rcyaon/suspension-board/fab/rev-b/docs/drill-report.txt

Drill report for suspension-load-daq.kicad_pcb
Created on 2026-10-19T18:48:59

Copper Layer Stackup:
    =============================================================
    L1 :  F.Cu                      front
    L2 :  In1.Cu                    in1
    L3 :  In2.Cu                    in2
    L4 :  B.Cu                      back

Drill file 'suspension-load-daq-PTH.drl' contains
    plated through holes:
    =============================================================
    T1  0.300mm  0.0118"  (591 holes))
    T2  0.600mm  0.0236"  (4 holes)  (with 4 slots)
    T3  0.750mm  0.0295"  (64 holes))
    T4  1.000mm  0.0394"  (10 holes))
    T5  3.200mm  0.1260"  (4 holes))

    Total plated holes count 673

Drill file 'suspension-load-daq-NPTH.drl' contains
    unplated through holes:
    =============================================================
    T1  0.650mm  0.0256"  (2 holes))
    T2  0.991mm  0.0390"  (3 holes))

    Total unplated holes count 5
