rcyaon/suspension-board/fab/rev-b/renders/suspension-load-daq-top.png

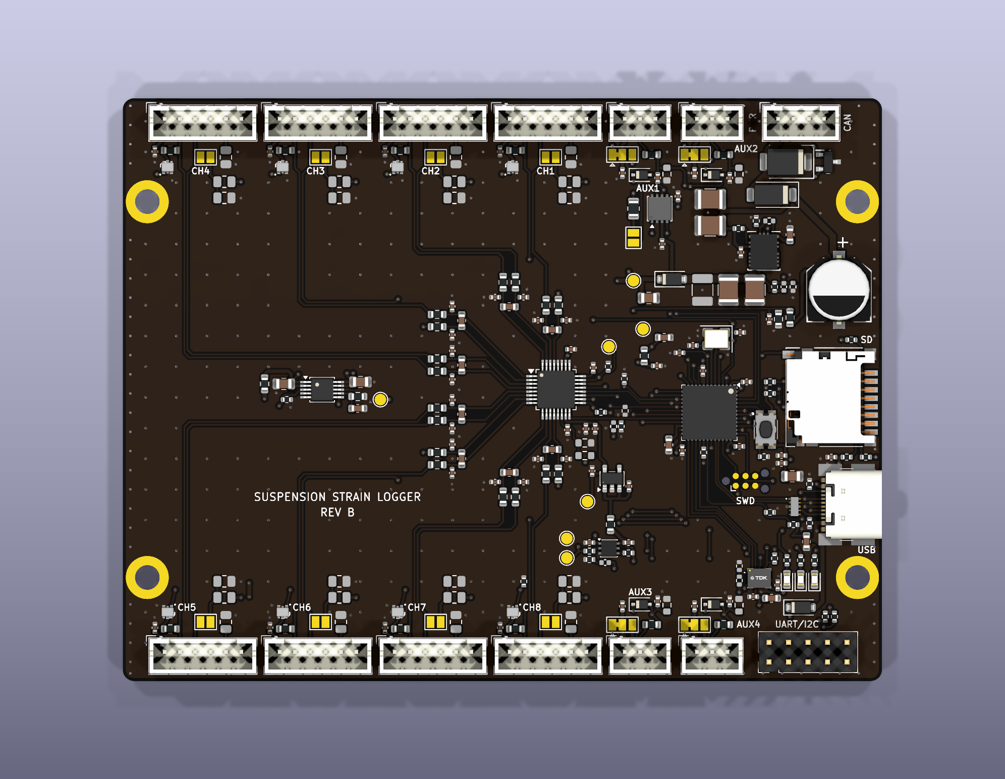
fab/rev-b/renders/suspension-load-daq-top.png
