rcyaon/suspension-board/fab/rev-b/assembly/suspension-load-daq-BOM-full.csv

Designator | Value | MPN | Manufacturer | Footprint | Population | LCSC | DigiKey | Mouser | Description
C1 | 47nF 16V | GRM155R71C473KA01J | Murata Electronics | C_0402_1005Metric | Fit | C2168391 | 490-11420-1-ND | 81-GRM155R71C473KA1J | 47 nF 10% 16 V X7R ceramic capacitor, 0402
C2 | 100nF 16V | GCM155R71H104KE02D | Murata Electronics | C_0402_1005Metric | Fit | C85858 | 490-10672-1-ND | 81-GCM155R71H104KE2D | 0.1 µF ±10% 50V Ceramic Capacitor X7R 0402 (1005 Metric)
C3 | 47nF 16V | GRM155R71C473KA01J | Murata Electronics | C_0402_1005Metric | Fit | C2168391 | 490-11420-1-ND | 81-GRM155R71C473KA1J | 47 nF 10% 16 V X7R ceramic capacitor, 0402
C4 | 100nF 16V | GCM155R71H104KE02D | Murata Electronics | C_0402_1005Metric | Fit | C85858 | 490-10672-1-ND | 81-GCM155R71H104KE2D | 0.1 µF ±10% 50V Ceramic Capacitor X7R 0402 (1005 Metric)
C5 | 47nF 16V | GRM155R71C473KA01J | Murata Electronics | C_0402_1005Metric | Fit | C2168391 | 490-11420-1-ND | 81-GRM155R71C473KA1J | 47 nF 10% 16 V X7R ceramic capacitor, 0402
C6 | 100nF 16V | GCM155R71H104KE02D | Murata Electronics | C_0402_1005Metric | Fit | C85858 | 490-10672-1-ND | 81-GCM155R71H104KE2D | 0.1 µF ±10% 50V Ceramic Capacitor X7R 0402 (1005 Metric)
C7 | 47nF 16V | GRM155R71C473KA01J | Murata Electronics | C_0402_1005Metric | Fit | C2168391 | 490-11420-1-ND | 81-GRM155R71C473KA1J | 47 nF 10% 16 V X7R ceramic capacitor, 0402
C8 | 100nF 16V | GCM155R71H104KE02D | Murata Electronics | C_0402_1005Metric | Fit | C85858 | 490-10672-1-ND | 81-GCM155R71H104KE2D | 0.1 µF ±10% 50V Ceramic Capacitor X7R 0402 (1005 Metric)
C9 | 1uF 10V | GRM155Z71A105KE01D | Murata Electronics | C_0402_1005Metric | Fit | C528974 | 490-GRM155Z71A105KE01DCT-ND | 81-GRM155Z71A105KE1D | 1 µF ±10% 10V Ceramic Capacitor X7R 0402 (1005 Metric)
C10 | 1uF 6.3V | GRM155Z71A105KE01D | Murata Electronics | C_0402_1005Metric | Fit | C528974 | 490-GRM155Z71A105KE01DCT-ND | 81-GRM155Z71A105KE1D | 1 µF ±10% 10V Ceramic Capacitor X7R 0402 (1005 Metric)
C11 | 1nF 5% 50V C0G | GCM1555C1H102FA16D | Murata Electronics | C_0402_1005Metric | Fit | C126493 | 490-16461-1-ND | 81-GCM1555C1H102FA6D | 1000 pF ±1% 50V Ceramic Capacitor C0G, NP0 0402 (1005 Metric)
C12 | 1nF 5% 50V C0G | GCM1555C1H102FA16D | Murata Electronics | C_0402_1005Metric | Fit | C126493 | 490-16461-1-ND | 81-GCM1555C1H102FA6D | 1000 pF ±1% 50V Ceramic Capacitor C0G, NP0 0402 (1005 Metric)
C13 | 10nF 5% 50V C0G | GCM1885C2A103JE02W | Murata Electronics | C_0603_1608Metric | Fit |  | 490-GCM1885C2A103JE02WCT-ND | 81-GCM1885C2A103JE2W | 10000 pF ±5% 100V Ceramic Capacitor C0G, NP0 0603 (1608 Metric)
C14 | 100nF 16V | GCM155R71H104KE02D | Murata Electronics | C_0402_1005Metric | Fit | C85858 | 490-10672-1-ND | 81-GCM155R71H104KE2D | 0.1 µF ±10% 50V Ceramic Capacitor X7R 0402 (1005 Metric)
C15 | 1nF 5% 50V C0G | GCM1555C1H102FA16D | Murata Electronics | C_0402_1005Metric | Fit | C126493 | 490-16461-1-ND | 81-GCM1555C1H102FA6D | 1000 pF ±1% 50V Ceramic Capacitor C0G, NP0 0402 (1005 Metric)
C16 | 1nF 5% 50V C0G | GCM1555C1H102FA16D | Murata Electronics | C_0402_1005Metric | Fit | C126493 | 490-16461-1-ND | 81-GCM1555C1H102FA6D | 1000 pF ±1% 50V Ceramic Capacitor C0G, NP0 0402 (1005 Metric)
C17 | 10nF 5% 50V C0G | GCM1885C2A103JE02W | Murata Electronics | C_0603_1608Metric | Fit |  | 490-GCM1885C2A103JE02WCT-ND | 81-GCM1885C2A103JE2W | 10000 pF ±5% 100V Ceramic Capacitor C0G, NP0 0603 (1608 Metric)
C18 | 100nF 16V | GCM155R71H104KE02D | Murata Electronics | C_0402_1005Metric | Fit | C85858 | 490-10672-1-ND | 81-GCM155R71H104KE2D | 0.1 µF ±10% 50V Ceramic Capacitor X7R 0402 (1005 Metric)
C19 | 1nF 5% 50V C0G | GCM1555C1H102FA16D | Murata Electronics | C_0402_1005Metric | Fit | C126493 | 490-16461-1-ND | 81-GCM1555C1H102FA6D | 1000 pF ±1% 50V Ceramic Capacitor C0G, NP0 0402 (1005 Metric)
C20 | 1nF 5% 50V C0G | GCM1555C1H102FA16D | Murata Electronics | C_0402_1005Metric | Fit | C126493 | 490-16461-1-ND | 81-GCM1555C1H102FA6D | 1000 pF ±1% 50V Ceramic Capacitor C0G, NP0 0402 (1005 Metric)
C21 | 10nF 5% 50V C0G | GCM1885C2A103JE02W | Murata Electronics | C_0603_1608Metric | Fit |  | 490-GCM1885C2A103JE02WCT-ND | 81-GCM1885C2A103JE2W | 10000 pF ±5% 100V Ceramic Capacitor C0G, NP0 0603 (1608 Metric)
C22 | 100nF 16V | GCM155R71H104KE02D | Murata Electronics | C_0402_1005Metric | Fit | C85858 | 490-10672-1-ND | 81-GCM155R71H104KE2D | 0.1 µF ±10% 50V Ceramic Capacitor X7R 0402 (1005 Metric)
C23 | 1nF 5% 50V C0G | GCM1555C1H102FA16D | Murata Electronics | C_0402_1005Metric | Fit | C126493 | 490-16461-1-ND | 81-GCM1555C1H102FA6D | 1000 pF ±1% 50V Ceramic Capacitor C0G, NP0 0402 (1005 Metric)
C24 | 1nF 5% 50V C0G | GCM1555C1H102FA16D | Murata Electronics | C_0402_1005Metric | Fit | C126493 | 490-16461-1-ND | 81-GCM1555C1H102FA6D | 1000 pF ±1% 50V Ceramic Capacitor C0G, NP0 0402 (1005 Metric)
C25 | 10nF 5% 50V C0G | GCM1885C2A103JE02W | Murata Electronics | C_0603_1608Metric | Fit |  | 490-GCM1885C2A103JE02WCT-ND | 81-GCM1885C2A103JE2W | 10000 pF ±5% 100V Ceramic Capacitor C0G, NP0 0603 (1608 Metric)
C26 | 100nF 16V | GCM155R71H104KE02D | Murata Electronics | C_0402_1005Metric | Fit | C85858 | 490-10672-1-ND | 81-GCM155R71H104KE2D | 0.1 µF ±10% 50V Ceramic Capacitor X7R 0402 (1005 Metric)
C27 | 1nF 5% 50V C0G | GCM1555C1H102FA16D | Murata Electronics | C_0402_1005Metric | Fit | C126493 | 490-16461-1-ND | 81-GCM1555C1H102FA6D | 1000 pF ±1% 50V Ceramic Capacitor C0G, NP0 0402 (1005 Metric)
C28 | 1nF 5% 50V C0G | GCM1555C1H102FA16D | Murata Electronics | C_0402_1005Metric | Fit | C126493 | 490-16461-1-ND | 81-GCM1555C1H102FA6D | 1000 pF ±1% 50V Ceramic Capacitor C0G, NP0 0402 (1005 Metric)
C29 | 10nF 5% 50V C0G | GCM1885C2A103JE02W | Murata Electronics | C_0603_1608Metric | Fit |  | 490-GCM1885C2A103JE02WCT-ND | 81-GCM1885C2A103JE2W | 10000 pF ±5% 100V Ceramic Capacitor C0G, NP0 0603 (1608 Metric)
C30 | 100nF 16V | GCM155R71H104KE02D | Murata Electronics | C_0402_1005Metric | Fit | C85858 | 490-10672-1-ND | 81-GCM155R71H104KE2D | 0.1 µF ±10% 50V Ceramic Capacitor X7R 0402 (1005 Metric)
C31 | 1nF 5% 50V C0G | GCM1555C1H102FA16D | Murata Electronics | C_0402_1005Metric | Fit | C126493 | 490-16461-1-ND | 81-GCM1555C1H102FA6D | 1000 pF ±1% 50V Ceramic Capacitor C0G, NP0 0402 (1005 Metric)
C32 | 1nF 5% 50V C0G | GCM1555C1H102FA16D | Murata Electronics | C_0402_1005Metric | Fit | C126493 | 490-16461-1-ND | 81-GCM1555C1H102FA6D | 1000 pF ±1% 50V Ceramic Capacitor C0G, NP0 0402 (1005 Metric)
C33 | 10nF 5% 50V C0G | GCM1885C2A103JE02W | Murata Electronics | C_0603_1608Metric | Fit |  | 490-GCM1885C2A103JE02WCT-ND | 81-GCM1885C2A103JE2W | 10000 pF ±5% 100V Ceramic Capacitor C0G, NP0 0603 (1608 Metric)
C34 | 100nF 16V | GCM155R71H104KE02D | Murata Electronics | C_0402_1005Metric | Fit | C85858 | 490-10672-1-ND | 81-GCM155R71H104KE2D | 0.1 µF ±10% 50V Ceramic Capacitor X7R 0402 (1005 Metric)
C35 | 1nF 5% 50V C0G | GCM1555C1H102FA16D | Murata Electronics | C_0402_1005Metric | Fit | C126493 | 490-16461-1-ND | 81-GCM1555C1H102FA6D | 1000 pF ±1% 50V Ceramic Capacitor C0G, NP0 0402 (1005 Metric)
C36 | 1nF 5% 50V C0G | GCM1555C1H102FA16D | Murata Electronics | C_0402_1005Metric | Fit | C126493 | 490-16461-1-ND | 81-GCM1555C1H102FA6D | 1000 pF ±1% 50V Ceramic Capacitor C0G, NP0 0402 (1005 Metric)
C37 | 10nF 5% 50V C0G | GCM1885C2A103JE02W | Murata Electronics | C_0603_1608Metric | Fit |  | 490-GCM1885C2A103JE02WCT-ND | 81-GCM1885C2A103JE2W | 10000 pF ±5% 100V Ceramic Capacitor C0G, NP0 0603 (1608 Metric)
C38 | 100nF 16V | GCM155R71H104KE02D | Murata Electronics | C_0402_1005Metric | Fit | C85858 | 490-10672-1-ND | 81-GCM155R71H104KE2D | 0.1 µF ±10% 50V Ceramic Capacitor X7R 0402 (1005 Metric)
C39 | 1nF 5% 50V C0G | GCM1555C1H102FA16D | Murata Electronics | C_0402_1005Metric | Fit | C126493 | 490-16461-1-ND | 81-GCM1555C1H102FA6D | 1000 pF ±1% 50V Ceramic Capacitor C0G, NP0 0402 (1005 Metric)
C40 | 1nF 5% 50V C0G | GCM1555C1H102FA16D | Murata Electronics | C_0402_1005Metric | Fit | C126493 | 490-16461-1-ND | 81-GCM1555C1H102FA6D | 1000 pF ±1% 50V Ceramic Capacitor C0G, NP0 0402 (1005 Metric)
C41 | 10nF 5% 50V C0G | GCM1885C2A103JE02W | Murata Electronics | C_0603_1608Metric | Fit |  | 490-GCM1885C2A103JE02WCT-ND | 81-GCM1885C2A103JE2W | 10000 pF ±5% 100V Ceramic Capacitor C0G, NP0 0603 (1608 Metric)
C42 | 100nF 16V | GCM155R71H104KE02D | Murata Electronics | C_0402_1005Metric | Fit | C85858 | 490-10672-1-ND | 81-GCM155R71H104KE2D | 0.1 µF ±10% 50V Ceramic Capacitor X7R 0402 (1005 Metric)
C43 | 1uF 16V | GRM155R61C105KA12J | Murata Electronics | C_0402_1005Metric | Fit | C20549880 | 490-14598-1-ND | 81-GRM155R61C105KA2J | 1 uF 10% 16 V X5R ceramic capacitor, 0402
C44 | 100nF 16V | GCM155R71H104KE02D | Murata Electronics | C_0402_1005Metric | Fit | C85858 | 490-10672-1-ND | 81-GCM155R71H104KE2D | 0.1 µF ±10% 50V Ceramic Capacitor X7R 0402 (1005 Metric)
C45 | 220nF 16V | GRM155R71C224KA12J | Murata Electronics | C_0402_1005Metric | Fit | C2190027 | 490-GRM155R71C224KA12JCT-ND | 81-GRM155R71C224KA2J | 220 nF 10% 16 V X7R ceramic capacitor, 0402
C46 | 1uF 16V | GRM155R61C105KA12J | Murata Electronics | C_0402_1005Metric | Fit | C20549880 | 490-14598-1-ND | 81-GRM155R61C105KA2J | 1 uF 10% 16 V X5R ceramic capacitor, 0402
C47 | 100nF 16V | GCM155R71H104KE02D | Murata Electronics | C_0402_1005Metric | Fit | C85858 | 490-10672-1-ND | 81-GCM155R71H104KE2D | 0.1 µF ±10% 50V Ceramic Capacitor X7R 0402 (1005 Metric)
C48 | 10uF 16V | GRM21BZ71E106KE15L | Murata Electronics | C_0805_2012Metric | Fit | C237493 | 490-GRM21BZ71E106KE15LCT-ND | 81-GRM21BZ71E106KE5L | 10 µF ±10% 25V Ceramic Capacitor X7R 0805 (2012 Metric)
C49 | 100nF 16V | GCM155R71H104KE02D | Murata Electronics | C_0402_1005Metric | Fit | C85858 | 490-10672-1-ND | 81-GCM155R71H104KE2D | 0.1 µF ±10% 50V Ceramic Capacitor X7R 0402 (1005 Metric)
C50 | 1uF 25V | GCM188R71E105KA64D | Murata Electronics | C_0603_1608Metric | Fit | C85862 | 490-10673-1-ND | 81-GCM188R71E105KA4D | 1 µF ±10% 25V Ceramic Capacitor X7R 0603 (1608 Metric)
C51 | 10uF 16V | GRM21BZ71E106KE15L | Murata Electronics | C_0805_2012Metric | Fit | C237493 | 490-GRM21BZ71E106KE15LCT-ND | 81-GRM21BZ71E106KE5L | 10 µF ±10% 25V Ceramic Capacitor X7R 0805 (2012 Metric)
C52 | 10uF 16V | GRM21BZ71E106KE15L | Murata Electronics | C_0805_2012Metric | Fit | C237493 | 490-GRM21BZ71E106KE15LCT-ND | 81-GRM21BZ71E106KE5L | 10 µF ±10% 25V Ceramic Capacitor X7R 0805 (2012 Metric)
C53 | 4.7uF 16V | GRM188Z71C475KE21D | Murata Electronics | C_0603_1608Metric | Fit | C389010 | 490-GRM188Z71C475KE21DCT-ND | 81-GRM188Z71C475KE1D | 4.7 µF ±10% 16V Ceramic Capacitor X7R 0603 (1608 Metric)
C54 | 10nF 10% 6.3V | GCM155R71H103KA55D | Murata Electronics | C_0402_1005Metric | Fit | C91601 | 490-4762-1-ND | 81-GCM155R71H103KA5D | 10000 pF ±10% 50V Ceramic Capacitor X7R 0402 (1005 Metric)
C55 | 100nF 10% 6.3V | GCM155R71H104KE02D | Murata Electronics | C_0402_1005Metric | Fit | C85858 | 490-10672-1-ND | 81-GCM155R71H104KE2D | 0.1 µF ±10% 50V Ceramic Capacitor X7R 0402 (1005 Metric)
C56 | 2.2uF 10V | GRM188Z71E225ME43D | Murata Electronics | C_0603_1608Metric | Fit | C3856236 | 490-GRM188Z71E225ME43DCT-ND | 81-GRM188Z71E225ME3D | 2.2 µF ±20% 25V Ceramic Capacitor X7R 0603 (1608 Metric)
C58 | 12pF 5% 50V C0G | GCM1555C1H120FA16D | Murata Electronics | C_0402_1005Metric | Fit | C393682 | 490-16460-1-ND | 81-GCM1555C1H120FA6D | 12 pF ±1% 50V Ceramic Capacitor C0G, NP0 0402 (1005 Metric)
C59 | 12pF 5% 50V C0G | GCM1555C1H120FA16D | Murata Electronics | C_0402_1005Metric | Fit | C393682 | 490-16460-1-ND | 81-GCM1555C1H120FA6D | 12 pF ±1% 50V Ceramic Capacitor C0G, NP0 0402 (1005 Metric)
C62 | 100nF 16V | GCM155R71H104KE02D | Murata Electronics | C_0402_1005Metric | Fit | C85858 | 490-10672-1-ND | 81-GCM155R71H104KE2D | 0.1 µF ±10% 50V Ceramic Capacitor X7R 0402 (1005 Metric)
C63 | 4.7uF 16V | GRM188Z71C475KE21D | Murata Electronics | C_0603_1608Metric | Fit | C389010 | 490-GRM188Z71C475KE21DCT-ND | 81-GRM188Z71C475KE1D | 4.7 µF ±10% 16V Ceramic Capacitor X7R 0603 (1608 Metric)
C64 | 100nF 16V | GCM155R71H104KE02D | Murata Electronics | C_0402_1005Metric | Fit | C85858 | 490-10672-1-ND | 81-GCM155R71H104KE2D | 0.1 µF ±10% 50V Ceramic Capacitor X7R 0402 (1005 Metric)
C65 | 100nF 16V | GCM155R71H104KE02D | Murata Electronics | C_0402_1005Metric | Fit | C85858 | 490-10672-1-ND | 81-GCM155R71H104KE2D | 0.1 µF ±10% 50V Ceramic Capacitor X7R 0402 (1005 Metric)
C66 | 100nF 16V | GCM155R71H104KE02D | Murata Electronics | C_0402_1005Metric | Fit | C85858 | 490-10672-1-ND | 81-GCM155R71H104KE2D | 0.1 µF ±10% 50V Ceramic Capacitor X7R 0402 (1005 Metric)
C67 | 100nF 16V | GCM155R71H104KE02D | Murata Electronics | C_0402_1005Metric | Fit | C85858 | 490-10672-1-ND | 81-GCM155R71H104KE2D | 0.1 µF ±10% 50V Ceramic Capacitor X7R 0402 (1005 Metric)
C68 | 100nF 16V | GCM155R71H104KE02D | Murata Electronics | C_0402_1005Metric | Fit | C85858 | 490-10672-1-ND | 81-GCM155R71H104KE2D | 0.1 µF ±10% 50V Ceramic Capacitor X7R 0402 (1005 Metric)
C69 | 1uF 16V | GRM155R61C105KA12J | Murata Electronics | C_0402_1005Metric | Fit | C20549880 | 490-14598-1-ND | 81-GRM155R61C105KA2J | 1 uF 10% 16 V X5R ceramic capacitor, 0402
C70 | 100nF 16V | GCM155R71H104KE02D | Murata Electronics | C_0402_1005Metric | Fit | C85858 | 490-10672-1-ND | 81-GCM155R71H104KE2D | 0.1 µF ±10% 50V Ceramic Capacitor X7R 0402 (1005 Metric)
C71 | 4.7uF 16V | GRM188Z71C475KE21D | Murata Electronics | C_0603_1608Metric | Fit | C389010 | 490-GRM188Z71C475KE21DCT-ND | 81-GRM188Z71C475KE1D | 4.7 µF ±10% 16V Ceramic Capacitor X7R 0603 (1608 Metric)
C72 | 10pF 50V C0G | GCM1555C1H100FA16D | Murata Electronics |  | DNP | C161145 | 490-14348-1-ND | 81-GCM1555C1H100FA6D | 10 pF ±1% 50V Ceramic Capacitor C0G, NP0 0402 (1005 Metric)
C73 | 4.7uF 50V X7R | C3225X7R1H475K250AB | TDK | C_1210_3225Metric | Fit | C2183952 | 445-7726-1-ND | 810-C3225X7R1H475K | 4.7uF 50V X7R
C74 | 100nF 50V X7R | GCM155R71H104KE02D | Murata Electronics | C_0402_1005Metric | Fit | C85858 | 490-10672-1-ND | 81-GCM155R71H104KE2D | 0.1 µF ±10% 50V Ceramic Capacitor X7R 0402 (1005 Metric)
C75 | 4.7uF 50V X7R | C3225X7R1H475K250AB | TDK | C_1210_3225Metric | Fit | C2183952 | 445-7726-1-ND | 810-C3225X7R1H475K | 4.7uF 50V X7R
C76 | 22uF 16V X7R | GRM32ER71E226KE15L | Murata Electronics | C_1210_3225Metric | Fit | C21397 | 490-5313-1-ND | 81-GRM32ER71E226KE5L | 22 µF ±10% 25V Ceramic Capacitor X7R 1210 (3225 Metric)
C77 | 22uF 16V X7R | GRM32ER71E226KE15L | Murata Electronics | C_1210_3225Metric | Fit | C21397 | 490-5313-1-ND | 81-GRM32ER71E226KE5L | 22 µF ±10% 25V Ceramic Capacitor X7R 1210 (3225 Metric)
C78 | 22uF 16V X7R | GRM32ER71E226KE15L | Murata Electronics |  | DNP | C21397 | 490-5313-1-ND | 81-GRM32ER71E226KE5L | 22 µF ±10% 25V Ceramic Capacitor X7R 1210 (3225 Metric)
C79 | 2.2uF 16V X7R | CC0603KRX7R7BB225 | YAGEO | C_0603_1608Metric | Fit | C914769 | 311-3490-1-ND | 603-CC0603KRX77BB225 | 2.2uF 16V X7R
C80 | 1uF 16V | GRM155R61C105KA12J | Murata Electronics | C_0402_1005Metric | Fit | C20549880 | 490-14598-1-ND | 81-GRM155R61C105KA2J | 1 uF 10% 16 V X5R ceramic capacitor, 0402
C81 | 1uF 16V | GRM155R61C105KA12J | Murata Electronics | C_0402_1005Metric | Fit | C20549880 | 490-14598-1-ND | 81-GRM155R61C105KA2J | 1 uF 10% 16 V X5R ceramic capacitor, 0402
C82 | EEE-FK1H470P | EEE-FK1H470P | Panasonic | EEE-FK1H470P | Fit | C278400 | PCE3815CT-ND | 667-EEE-FK1H470P | Aluminum electrolytic capacitor, 47uF 20% 50V, FK series low-impedance, SMD size E (8x6.2mm), 20 ...
C83 | 100nF 16V | GCM155R71H104KE02D | Murata Electronics | C_0402_1005Metric | Fit | C85858 | 490-10672-1-ND | 81-GCM155R71H104KE2D | 0.1 µF ±10% 50V Ceramic Capacitor X7R 0402 (1005 Metric)
C84 | 10uF 16V | GRM21BZ71E106KE15L | Murata Electronics | C_0805_2012Metric | Fit | C237493 | 490-GRM21BZ71E106KE15LCT-ND | 81-GRM21BZ71E106KE5L | 10 µF ±10% 25V Ceramic Capacitor X7R 0805 (2012 Metric)
C85 | 10nF | GCM155R71H103KA55D | Murata Electronics |  | DNP | C91601 | 490-4762-1-ND | 81-GCM155R71H103KA5D | 10000 pF ±10% 50V Ceramic Capacitor X7R 0402 (1005 Metric)
C86 | 1uF 10V | GRM155Z71A105KE01D | Murata Electronics | C_0402_1005Metric | Fit | C528974 | 490-GRM155Z71A105KE01DCT-ND | 81-GRM155Z71A105KE1D | 1 µF ±10% 10V Ceramic Capacitor X7R 0402 (1005 Metric)
C87 | 1uF 10V | GRM155Z71A105KE01D | Murata Electronics | C_0402_1005Metric | Fit | C528974 | 490-GRM155Z71A105KE01DCT-ND | 81-GRM155Z71A105KE1D | 1 µF ±10% 10V Ceramic Capacitor X7R 0402 (1005 Metric)
D1 | PESD2CANFD24V | PESD2CANFD24V-TR | Nexperia | PESD2CANFD24V | Fit | C552486 | 1727-PESD2CANFD24V-CT-ND | 771-PESD2CANFD24V-TR | Dual bidirectional TVS array for automotive CAN/CAN-FD ESD protection, 24 V working, AEC-Q101, S ...
D2 | LED RED | LTST-C190KRKT | Lite-On Inc. | LED_0603_1608Metric | Fit | C94869 | 160-1436-1-ND | 859-LTST-C190KRKT | Red 631 nm LED, 0603, typical VF 2.0 V
D3 | LED GREEN | LTST-C190KGKT | Lite-On Inc. | LED_0603_1608Metric | Fit | C125094 | 160-1435-1-ND | 859-LTST-C190KGKT | Green 572 nm LED, 0603, typical VF 2.15 V
D4 | LED BLUE | LTST-C190TBKT | Lite-On Inc. | LED_0603_1608Metric | Fit | C125096 | 160-1646-1-ND | 859-LTST-C190TBKT | Blue 470 nm LED, 0603, typical VF 3.3 V
D5 | TPD4E02B04DQAR | TPD4E02B04DQAR | Texas Instruments | TPD4E02B04DQAR | Fit | C106794 | 296-43875-1-ND | 595-TPD4E02B04DQAR | 4-channel bidirectional ESD/TVS protection array for USB Type-C and high-speed data lines, 0.25p ...
D6 | 1A 40V Low-IR Schottky | RB168MM-40TFTR | Rohm Semiconductor | D_SOD-123F | Fit | C3758797 | RB168MM-40TFCT-ND | 755-RB168MM-40TFTR | 1 A 40 V super-low-IR Schottky rectifier, AEC-Q101, VF <= 0.65 V at 1 A, IR <= 0.55 uA at 40 V/2 ...
D7 | 1A 40V Low-IR Schottky | RB168MM-40TFTR | Rohm Semiconductor | D_SOD-123F | Fit | C3758797 | RB168MM-40TFCT-ND | 755-RB168MM-40TFTR | 1 A 40 V super-low-IR Schottky rectifier, AEC-Q101, VF <= 0.65 V at 1 A, IR <= 0.55 uA at 40 V/2 ...
D8 | 2A 40V Schottky Rectifier | B240A-13-F | Diodes Incorporated | D_SMA | Fit | C92506 | B240A-FDICT-ND | 621-B240A-F | 2 A 40 V Schottky rectifier, DO-214AC (SMA)
D9 | 18V TVS Diode | SMBJ18CA | Littelfuse | D_SMB | Fit | C83327 | SMBJ18CALFCT-ND | 576-SMBJ18CA | 18V TVS Diode
D10 | 200mA 30V Schottky Rectifier | BAT54WS-HE3_A-08 | Vishay | D_SOD-323 | Fit | C146335 | 112-BAT54WS-HE3_A-08CT-ND | 78-BAT54WS-HE3_A-08 | 200mA 30V Schottky Rectifier
D11 | 200mA 30V Schottky Rectifier | BAT54WS-HE3_A-08 | Vishay | D_SOD-323 | Fit | C146335 | 112-BAT54WS-HE3_A-08CT-ND | 78-BAT54WS-HE3_A-08 | 200mA 30V Schottky Rectifier
D12 | 200mA 30V Schottky Rectifier | BAT54WS-HE3_A-08 | Vishay | D_SOD-323 | Fit | C146335 | 112-BAT54WS-HE3_A-08CT-ND | 78-BAT54WS-HE3_A-08 | 200mA 30V Schottky Rectifier
D13 | 200mA 30V Schottky Rectifier | BAT54WS-HE3_A-08 | Vishay | D_SOD-323 | Fit | C146335 | 112-BAT54WS-HE3_A-08CT-ND | 78-BAT54WS-HE3_A-08 | 200mA 30V Schottky Rectifier
FB1 | 220 100MHz | BLM18EG221SZ1D | Murata Electronics | R_0603_1608Metric | Fit | C710364 | 490-16657-1-ND | 81-BLM18EG221SZ1D | 220 Ohms @ 100 MHz 1 Signal Line Ferrite Bead 0603 (1608 Metric) 2A 50mOhm
FB2 | 220 100MHz | BLM18EG221SZ1D | Murata Electronics | R_0603_1608Metric | Fit | C710364 | 490-16657-1-ND | 81-BLM18EG221SZ1D | 220 Ohms @ 100 MHz 1 Signal Line Ferrite Bead 0603 (1608 Metric) 2A 50mOhm
IC1 | ICM-42688-P | ICM-42688-P | TDK | IIM42352 | Fit | C20619370 |  |  | IMU (Inertial Measurement Unit), 6-Axis, Accelerometer, Gyroscope
J1 | B3B-PH-K-S | B3B-PH-K-S | JST | JST_PH_B3B-PH-K_1x03_P2.00mm_Vertical | Fit | C131339 | 455-1705-ND | 306-B3BPHKSLFSNP | JST PH series 2.00mm 3-position vertical through-hole wire-to-board header
J2 | B3B-PH-K-S | B3B-PH-K-S | JST | JST_PH_B3B-PH-K_1x03_P2.00mm_Vertical | Fit | C131339 | 455-1705-ND | 306-B3BPHKSLFSNP | JST PH series 2.00mm 3-position vertical through-hole wire-to-board header
J3 | B3B-PH-K-S | B3B-PH-K-S | JST | JST_PH_B3B-PH-K_1x03_P2.00mm_Vertical | Fit | C131339 | 455-1705-ND | 306-B3BPHKSLFSNP | JST PH series 2.00mm 3-position vertical through-hole wire-to-board header
J4 | B3B-PH-K-S | B3B-PH-K-S | JST | JST_PH_B3B-PH-K_1x03_P2.00mm_Vertical | Fit | C131339 | 455-1705-ND | 306-B3BPHKSLFSNP | JST PH series 2.00mm 3-position vertical through-hole wire-to-board header
J5 | B6B-PH-K-S | B6B-PH-K-S | JST | JST_PH_B6B-PH-K_1x06_P2.00mm_Vertical | Fit | C131342 | 455-1708-ND | 306-B6B-PH-K-SLFSN | JST PH series 2.00mm 6-position vertical through-hole wire-to-board header
J6 | B6B-PH-K-S | B6B-PH-K-S | JST | JST_PH_B6B-PH-K_1x06_P2.00mm_Vertical | Fit | C131342 | 455-1708-ND | 306-B6B-PH-K-SLFSN | JST PH series 2.00mm 6-position vertical through-hole wire-to-board header
J7 | B6B-PH-K-S | B6B-PH-K-S | JST | JST_PH_B6B-PH-K_1x06_P2.00mm_Vertical | Fit | C131342 | 455-1708-ND | 306-B6B-PH-K-SLFSN | JST PH series 2.00mm 6-position vertical through-hole wire-to-board header
J8 | B6B-PH-K-S | B6B-PH-K-S | JST | JST_PH_B6B-PH-K_1x06_P2.00mm_Vertical | Fit | C131342 | 455-1708-ND | 306-B6B-PH-K-SLFSN | JST PH series 2.00mm 6-position vertical through-hole wire-to-board header
J9 | B6B-PH-K-S | B6B-PH-K-S | JST | JST_PH_B6B-PH-K_1x06_P2.00mm_Vertical | Fit | C131342 | 455-1708-ND | 306-B6B-PH-K-SLFSN | JST PH series 2.00mm 6-position vertical through-hole wire-to-board header
J10 | B6B-PH-K-S | B6B-PH-K-S | JST | JST_PH_B6B-PH-K_1x06_P2.00mm_Vertical | Fit | C131342 | 455-1708-ND | 306-B6B-PH-K-SLFSN | JST PH series 2.00mm 6-position vertical through-hole wire-to-board header
J11 | B6B-PH-K-S | B6B-PH-K-S | JST | JST_PH_B6B-PH-K_1x06_P2.00mm_Vertical | Fit | C131342 | 455-1708-ND | 306-B6B-PH-K-SLFSN | JST PH series 2.00mm 6-position vertical through-hole wire-to-board header
J12 | B6B-PH-K-S | B6B-PH-K-S | JST | JST_PH_B6B-PH-K_1x06_P2.00mm_Vertical | Fit | C131342 | 455-1708-ND | 306-B6B-PH-K-SLFSN | JST PH series 2.00mm 6-position vertical through-hole wire-to-board header
J13 | 2.54mm 5 x 2 THT Vertical Male | TSW-105-07-G-D | Samtec Inc. | PinHeader_2x05_P2.54mm_Vertical | Fit | C7074471 | 612-TSW-105-07-G-D-ND | 200-TSW10507GD | 2x5 male straight through-hole header, 2.54 mm pitch, 0.64 mm square posts
J15 | USB4105 | USB4105-GF-A | GCT | USB4105 | Fit | C3020560 | 2073-USB4105-GF-ACT-ND | 640-USB4105-GF-A | USB Type-C USB 2.0 receptacle, 16P, top-mount right-angle, GCT USB4105
J16 | B4B-PH-K-S | B4B-PH-K-S | JST | JST_PH_B4B-PH-K_1x04_P2.00mm_Vertical | Fit | C131334 | 455-1706-ND | 306-B4BPHKSLFSNPP | JST PH series 2.00mm 4-position vertical through-hole wire-to-board header
J17 | DM3D-SF | DM3D-SF | Hirose Electric Co Ltd | microSD_HC_Hirose_DM3D-SF | Fit | C719027 | HR1941CT-ND | 798-DM3D-SF | Hirose DM3D-SF push-pull microSD card socket, right-angle SMT, with card-detect switch
Q1 | PJE138K_R1_00001 | PJE138K_R1_00001 | PANJIT | SOT-523 | Fit | C391643 | 3757-PJE138K_R1_00001CT-ND | 241-PJE138K_R1_00001 | FET/MOSFET transistor
Q2 | PJE138K_R1_00001 | PJE138K_R1_00001 | PANJIT | SOT-523 | Fit | C391643 | 3757-PJE138K_R1_00001CT-ND | 241-PJE138K_R1_00001 | FET/MOSFET transistor
Q3 | PJE138K_R1_00001 | PJE138K_R1_00001 | PANJIT | SOT-523 | Fit | C391643 | 3757-PJE138K_R1_00001CT-ND | 241-PJE138K_R1_00001 | FET/MOSFET transistor
Q4 | PJE138K_R1_00001 | PJE138K_R1_00001 | PANJIT | SOT-523 | Fit | C391643 | 3757-PJE138K_R1_00001CT-ND | 241-PJE138K_R1_00001 | FET/MOSFET transistor
Q5 | PJE138K_R1_00001 | PJE138K_R1_00001 | PANJIT | SOT-523 | Fit | C391643 | 3757-PJE138K_R1_00001CT-ND | 241-PJE138K_R1_00001 | FET/MOSFET transistor
Q6 | PJE138K_R1_00001 | PJE138K_R1_00001 | PANJIT | SOT-523 | Fit | C391643 | 3757-PJE138K_R1_00001CT-ND | 241-PJE138K_R1_00001 | FET/MOSFET transistor
Q7 | PJE138K_R1_00001 | PJE138K_R1_00001 | PANJIT | SOT-523 | Fit | C391643 | 3757-PJE138K_R1_00001CT-ND | 241-PJE138K_R1_00001 | FET/MOSFET transistor
Q8 | PJE138K_R1_00001 | PJE138K_R1_00001 | PANJIT | SOT-523 | Fit | C391643 | 3757-PJE138K_R1_00001CT-ND | 241-PJE138K_R1_00001 | FET/MOSFET transistor
R1 | 18k 1% | ERJ-3EKF1802V | Panasonic Industry |  | DNP | C403034 | P18.0KHCT-ND | 667-ERJ-3EKF1802V | 18 kOhms ±1% 0.1W, 1/10W Chip Resistor 0603 (1608 Metric) Automotive AEC-Q200 Thick Film
R2 | 10k 1% | ERJ-3EKF1002V | Panasonic Industry | R_0603_1608Metric | Fit | C191124 | P10.0KHCT-ND | 667-ERJ-3EKF1002V | 10 kOhms ±1% 0.1W, 1/10W Chip Resistor 0603 (1608 Metric) Automotive AEC-Q200 Thick Film
R3 | 18k 1% | ERJ-3EKF1802V | Panasonic Industry |  | DNP | C403034 | P18.0KHCT-ND | 667-ERJ-3EKF1802V | 18 kOhms ±1% 0.1W, 1/10W Chip Resistor 0603 (1608 Metric) Automotive AEC-Q200 Thick Film
R4 | 10k 1% | ERJ-3EKF1002V | Panasonic Industry | R_0603_1608Metric | Fit | C191124 | P10.0KHCT-ND | 667-ERJ-3EKF1002V | 10 kOhms ±1% 0.1W, 1/10W Chip Resistor 0603 (1608 Metric) Automotive AEC-Q200 Thick Film
R5 | 18k 1% | ERJ-3EKF1802V | Panasonic Industry |  | DNP | C403034 | P18.0KHCT-ND | 667-ERJ-3EKF1802V | 18 kOhms ±1% 0.1W, 1/10W Chip Resistor 0603 (1608 Metric) Automotive AEC-Q200 Thick Film
R6 | 10k 1% | ERJ-3EKF1002V | Panasonic Industry | R_0603_1608Metric | Fit | C191124 | P10.0KHCT-ND | 667-ERJ-3EKF1002V | 10 kOhms ±1% 0.1W, 1/10W Chip Resistor 0603 (1608 Metric) Automotive AEC-Q200 Thick Film
R7 | 18k 1% | ERJ-3EKF1802V | Panasonic Industry |  | DNP | C403034 | P18.0KHCT-ND | 667-ERJ-3EKF1802V | 18 kOhms ±1% 0.1W, 1/10W Chip Resistor 0603 (1608 Metric) Automotive AEC-Q200 Thick Film
R8 | 10k 1% | ERJ-3EKF1002V | Panasonic Industry | R_0603_1608Metric | Fit | C191124 | P10.0KHCT-ND | 667-ERJ-3EKF1002V | 10 kOhms ±1% 0.1W, 1/10W Chip Resistor 0603 (1608 Metric) Automotive AEC-Q200 Thick Film
R9 | 100k 0.1% | TNPW0603100KBEEA | Vishay Dale | R_0603_1608Metric | Fit | C844888 | TNP100KAACT-ND | 71-TNPW0603100KBEEA | 100 kOhm 0.1%, 0603, 0.21 W thin-film resistor
R10 | 1k 0.1% | TNPW06031K00BEEA | Vishay Dale | R_0603_1608Metric | Fit | C844891 | TNP1.00KAACT-ND | 71-TNPW06031K00BEEA | 1 kOhm 0.1%, 0603, 0.21 W thin-film resistor
R11 | 1k 0.1% | TNPW06031K00BEEA | Vishay Dale | R_0603_1608Metric | Fit | C844891 | TNP1.00KAACT-ND | 71-TNPW06031K00BEEA | 1 kOhm 0.1%, 0603, 0.21 W thin-film resistor
R12 | 350 0.1% | RWB350R0BL | VPG Foil Resistors |  | DNP |  | 804-RWB350R0BL-ND |  | 350 Ohm 0.1%, 0805, 0.2 W bulk metal-foil resistor
R13 | 350 0.1% | RWB350R0BL | VPG Foil Resistors |  | DNP |  | 804-RWB350R0BL-ND |  | 350 Ohm 0.1%, 0805, 0.2 W bulk metal-foil resistor
R14 | 350 0.1% | RWB350R0BL | VPG Foil Resistors |  | DNP |  | 804-RWB350R0BL-ND |  | 350 Ohm 0.1%, 0805, 0.2 W bulk metal-foil resistor
R15 | 100k 0.1% | TNPW0603100KBEEA | Vishay Dale | R_0603_1608Metric | Fit | C844888 | TNP100KAACT-ND | 71-TNPW0603100KBEEA | 100 kOhm 0.1%, 0603, 0.21 W thin-film resistor
R16 | 1k 0.1% | TNPW06031K00BEEA | Vishay Dale | R_0603_1608Metric | Fit | C844891 | TNP1.00KAACT-ND | 71-TNPW06031K00BEEA | 1 kOhm 0.1%, 0603, 0.21 W thin-film resistor
R17 | 1k 0.1% | TNPW06031K00BEEA | Vishay Dale | R_0603_1608Metric | Fit | C844891 | TNP1.00KAACT-ND | 71-TNPW06031K00BEEA | 1 kOhm 0.1%, 0603, 0.21 W thin-film resistor
R18 | 350 0.1% | RWB350R0BL | VPG Foil Resistors |  | DNP |  | 804-RWB350R0BL-ND |  | 350 Ohm 0.1%, 0805, 0.2 W bulk metal-foil resistor
R19 | 350 0.1% | RWB350R0BL | VPG Foil Resistors |  | DNP |  | 804-RWB350R0BL-ND |  | 350 Ohm 0.1%, 0805, 0.2 W bulk metal-foil resistor
R20 | 350 0.1% | RWB350R0BL | VPG Foil Resistors |  | DNP |  | 804-RWB350R0BL-ND |  | 350 Ohm 0.1%, 0805, 0.2 W bulk metal-foil resistor
R21 | 100k 0.1% | TNPW0603100KBEEA | Vishay Dale | R_0603_1608Metric | Fit | C844888 | TNP100KAACT-ND | 71-TNPW0603100KBEEA | 100 kOhm 0.1%, 0603, 0.21 W thin-film resistor
R22 | 1k 0.1% | TNPW06031K00BEEA | Vishay Dale | R_0603_1608Metric | Fit | C844891 | TNP1.00KAACT-ND | 71-TNPW06031K00BEEA | 1 kOhm 0.1%, 0603, 0.21 W thin-film resistor
R23 | 1k 0.1% | TNPW06031K00BEEA | Vishay Dale | R_0603_1608Metric | Fit | C844891 | TNP1.00KAACT-ND | 71-TNPW06031K00BEEA | 1 kOhm 0.1%, 0603, 0.21 W thin-film resistor
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
R52 | 1k 0.1% | TNPW06031K00BEEA | Vishay Dale | R_0603_1608Metric | Fit | C844891 | TNP1.00KAACT-ND | 71-TNPW06031K00BEEA | 1 kOhm 0.1%, 0603, 0.21 W thin-film resistor
R53 | 1k 0.1% | TNPW06031K00BEEA | Vishay Dale | R_0603_1608Metric | Fit | C844891 | TNP1.00KAACT-ND | 71-TNPW06031K00BEEA | 1 kOhm 0.1%, 0603, 0.21 W thin-film resistor
R54 | 350 0.1% | RWB350R0BL | VPG Foil Resistors |  | DNP |  | 804-RWB350R0BL-ND |  | 350 Ohm 0.1%, 0805, 0.2 W bulk metal-foil resistor
R55 | 350 0.1% | RWB350R0BL | VPG Foil Resistors |  | DNP |  | 804-RWB350R0BL-ND |  | 350 Ohm 0.1%, 0805, 0.2 W bulk metal-foil resistor
R56 | 350 0.1% | RWB350R0BL | VPG Foil Resistors |  | DNP |  | 804-RWB350R0BL-ND |  | 350 Ohm 0.1%, 0805, 0.2 W bulk metal-foil resistor
R57 | 100k | ERJ-2RKF1003X | Panasonic Industry | R_0402_1005Metric | Fit | C192169 | P100KLCT-ND | 667-ERJ-2RKF1003X | 100 kOhms ±1% 0.1W, 1/10W Chip Resistor 0402 (1005 Metric) Automotive AEC-Q200 Thick Film
R58 | 1 1% | RC0603FR-071RL | YAGEO | R_0603_1608Metric | Fit | C112305 | 311-1.00HRCT-ND | 603-RC0603FR-071RL | 1 Ohm 1%, 0603, 0.1 W thick-film resistor
R59 | 24.9k 0.1% | TNPW060324K9BEEA | Vishay Dale | R_0603_1608Metric | Fit | C3009044 | TNP24.9KAACT-ND | 71-TNPW060324K9BEEA | 24.9 kOhm 0.1%, 0603, 0.21 W thin-film resistor
R60 | 10k | ERJ-2RKF1002X | Panasonic Industry |  | DNP | C191123 | P10.0KLCT-ND | 667-ERJ-2RKF1002X | 10 kOhms ±1% 0.1W, 1/10W Chip Resistor 0402 (1005 Metric) Automotive AEC-Q200 Thick Film
R61 | 10k | ERJ-2RKF1002X | Panasonic Industry |  | DNP | C191123 | P10.0KLCT-ND | 667-ERJ-2RKF1002X | 10 kOhms ±1% 0.1W, 1/10W Chip Resistor 0402 (1005 Metric) Automotive AEC-Q200 Thick Film
R62 | 10k | ERJ-2RKF1002X | Panasonic Industry | R_0402_1005Metric | Fit | C191123 | P10.0KLCT-ND | 667-ERJ-2RKF1002X | 10 kOhms ±1% 0.1W, 1/10W Chip Resistor 0402 (1005 Metric) Automotive AEC-Q200 Thick Film
R63 | 10k | ERJ-2RKF1002X | Panasonic Industry | R_0402_1005Metric | Fit | C191123 | P10.0KLCT-ND | 667-ERJ-2RKF1002X | 10 kOhms ±1% 0.1W, 1/10W Chip Resistor 0402 (1005 Metric) Automotive AEC-Q200 Thick Film
R64 | 10k | ERJ-2RKF1002X | Panasonic Industry | R_0402_1005Metric | Fit | C191123 | P10.0KLCT-ND | 667-ERJ-2RKF1002X | 10 kOhms ±1% 0.1W, 1/10W Chip Resistor 0402 (1005 Metric) Automotive AEC-Q200 Thick Film
R65 | 100k | ERJ-2RKF1003X | Panasonic Industry | R_0402_1005Metric | Fit | C192169 | P100KLCT-ND | 667-ERJ-2RKF1003X | 100 kOhms ±1% 0.1W, 1/10W Chip Resistor 0402 (1005 Metric) Automotive AEC-Q200 Thick Film
R66 | 10k | ERJ-2RKF1002X | Panasonic Industry |  | DNP | C191123 | P10.0KLCT-ND | 667-ERJ-2RKF1002X | 10 kOhms ±1% 0.1W, 1/10W Chip Resistor 0402 (1005 Metric) Automotive AEC-Q200 Thick Film
R67 | 0 | ERJ-2GE0R00X | Panasonic Industry | R_0402_1005Metric | Fit | C242160 | P0.0JCT-ND | 667-ERJ-2GE0R00X | 0 Ohms Jumper Chip Resistor 0402 (1005 Metric) Automotive AEC-Q200 Thick Film
R68 | 100k | ERJ-2RKF1003X | Panasonic Industry | R_0402_1005Metric | Fit | C192169 | P100KLCT-ND | 667-ERJ-2RKF1003X | 100 kOhms ±1% 0.1W, 1/10W Chip Resistor 0402 (1005 Metric) Automotive AEC-Q200 Thick Film
R69 | 100k | ERJ-2RKF1003X | Panasonic Industry |  | DNP | C192169 | P100KLCT-ND | 667-ERJ-2RKF1003X | 100 kOhms ±1% 0.1W, 1/10W Chip Resistor 0402 (1005 Metric) Automotive AEC-Q200 Thick Film
R70 | 100k | ERJ-2RKF1003X | Panasonic Industry | R_0402_1005Metric | Fit | C192169 | P100KLCT-ND | 667-ERJ-2RKF1003X | 100 kOhms ±1% 0.1W, 1/10W Chip Resistor 0402 (1005 Metric) Automotive AEC-Q200 Thick Film
R71 | 51k 1% | ERJ-2RKF5102X | Panasonic Industry | R_0402_1005Metric | Fit | C278599 | P51.0KLCT-ND | 667-ERJ-2RKF5102X | 51 kOhms ±1% 0.1W, 1/10W Chip Resistor 0402 (1005 Metric) Automotive AEC-Q200 Thick Film
R72 | 255k 1% | ERJ-2RKF2553X | Panasonic Industry | R_0402_1005Metric | Fit | C2986594 | P255KLCT-ND | 667-ERJ-2RKF2553X | 255 kOhms ±1% 0.1W, 1/10W Chip Resistor 0402 (1005 Metric) Automotive AEC-Q200 Thick Film
R73 | 100k 1% | ERJ-3EKF1003V | Panasonic Industry | R_0603_1608Metric | Fit | C189597 | P100KHCT-ND | 667-ERJ-3EKF1003V | 100 kOhms ±1% 0.1W, 1/10W Chip Resistor 0603 (1608 Metric) Automotive AEC-Q200 Thick Film
R74 | 10k 1% | ERJ-3EKF1002V | Panasonic Industry | R_0603_1608Metric | Fit | C191124 | P10.0KHCT-ND | 667-ERJ-3EKF1002V | 10 kOhms ±1% 0.1W, 1/10W Chip Resistor 0603 (1608 Metric) Automotive AEC-Q200 Thick Film
R75 | 33 | ERJ-2RKF33R0X | Panasonic Industry | R_0402_1005Metric | Fit | C278594 | P33.0LCT-ND | 667-ERJ-2RKF33R0X | 33 Ohms ±1% 0.1W, 1/10W Chip Resistor 0402 (1005 Metric) Automotive AEC-Q200 Thick Film
R76 | 100k | ERJ-2RKF1003X | Panasonic Industry | R_0402_1005Metric | Fit | C192169 | P100KLCT-ND | 667-ERJ-2RKF1003X | 100 kOhms ±1% 0.1W, 1/10W Chip Resistor 0402 (1005 Metric) Automotive AEC-Q200 Thick Film
R77 | 10k | ERJ-2RKF1002X | Panasonic Industry | R_0402_1005Metric | Fit | C191123 | P10.0KLCT-ND | 667-ERJ-2RKF1002X | 10 kOhms ±1% 0.1W, 1/10W Chip Resistor 0402 (1005 Metric) Automotive AEC-Q200 Thick Film
R78 | 100k | ERJ-2RKF1003X | Panasonic Industry |  | DNP | C192169 | P100KLCT-ND | 667-ERJ-2RKF1003X | 100 kOhms ±1% 0.1W, 1/10W Chip Resistor 0402 (1005 Metric) Automotive AEC-Q200 Thick Film
R79 | 100k | ERJ-2RKF1003X | Panasonic Industry | R_0402_1005Metric | Fit | C192169 | P100KLCT-ND | 667-ERJ-2RKF1003X | 100 kOhms ±1% 0.1W, 1/10W Chip Resistor 0402 (1005 Metric) Automotive AEC-Q200 Thick Film
R80 | 10k | ERJ-2RKF1002X | Panasonic Industry |  | DNP | C191123 | P10.0KLCT-ND | 667-ERJ-2RKF1002X | 10 kOhms ±1% 0.1W, 1/10W Chip Resistor 0402 (1005 Metric) Automotive AEC-Q200 Thick Film
R81 | 120 1% | ERJ-6ENF1200V | Panasonic Industry | R_0805_2012Metric | Fit | C409952 | P120CCT-ND | 667-ERJ-6ENF1200V | 120 Ohm 1%, 0805, 0.125 W thick-film resistor
R82 | 5.1k 1% | ERJ-2RKF5101X | Panasonic Industry | R_0402_1005Metric | Fit | C278598 | P5.10KLCT-ND | 667-ERJ-2RKF5101X | 5.1 kOhms ±1% 0.1W, 1/10W Chip Resistor 0402 (1005 Metric) Automotive AEC-Q200 Thick Film
R83 | 5.1k 1% | ERJ-2RKF5101X | Panasonic Industry | R_0402_1005Metric | Fit | C278598 | P5.10KLCT-ND | 667-ERJ-2RKF5101X | 5.1 kOhms ±1% 0.1W, 1/10W Chip Resistor 0402 (1005 Metric) Automotive AEC-Q200 Thick Film
R84 | 1k | ERJ-2RKF1001X | Panasonic Industry | R_0402_1005Metric | Fit | C242161 | P1.00KLCT-ND | 667-ERJ-2RKF1001X | 1 kOhms ±1% 0.1W, 1/10W Chip Resistor 0402 (1005 Metric) Automotive AEC-Q200 Thick Film
R85 | 1k | ERJ-2RKF1001X | Panasonic Industry | R_0402_1005Metric | Fit | C242161 | P1.00KLCT-ND | 667-ERJ-2RKF1001X | 1 kOhms ±1% 0.1W, 1/10W Chip Resistor 0402 (1005 Metric) Automotive AEC-Q200 Thick Film
R86 | 2.2k | ERJ-2RKF2201X | Panasonic Industry | R_0402_1005Metric | Fit | C413087 | P2.20KLCT-ND | 667-ERJ-2RKF2201X | 2.2 kOhms ±1% 0.1W, 1/10W Chip Resistor 0402 (1005 Metric) Automotive AEC-Q200 Thick Film
R87 | 10k 0.1% | TNPW060310K0BEEA | Vishay Dale |  | DNP | C844890 | TNP10.0KAACT-ND | 71-TNPW060310K0BEEA | 10 kOhm 0.1%, 0603, 0.21 W thin-film resistor
R88 | 10k 0.1% | TNPW060310K0BEEA | Vishay Dale |  | DNP | C844890 | TNP10.0KAACT-ND | 71-TNPW060310K0BEEA | 10 kOhm 0.1%, 0603, 0.21 W thin-film resistor
R89 | 4.7k | ERJ-2RKF4701X | Panasonic Industry | R_0402_1005Metric | Fit | C400631 | P4.70KLCT-ND | 667-ERJ-2RKF4701X | 4.7 kOhms ±1% 0.1W, 1/10W Chip Resistor 0402 (1005 Metric) Automotive AEC-Q200 Thick Film
R90 | 4.7k | ERJ-2RKF4701X | Panasonic Industry | R_0402_1005Metric | Fit | C400631 | P4.70KLCT-ND | 667-ERJ-2RKF4701X | 4.7 kOhms ±1% 0.1W, 1/10W Chip Resistor 0402 (1005 Metric) Automotive AEC-Q200 Thick Film
R91 | 47k | ERJ-2RKF4702X | Panasonic Industry | R_0402_1005Metric | Fit | C413103 | P47.0KLCT-ND | 667-ERJ-2RKF4702X | 47 kOhms ±1% 0.1W, 1/10W Chip Resistor 0402 (1005 Metric) Automotive AEC-Q200 Thick Film
R92 | 47k | ERJ-2RKF4702X | Panasonic Industry | R_0402_1005Metric | Fit | C413103 | P47.0KLCT-ND | 667-ERJ-2RKF4702X | 47 kOhms ±1% 0.1W, 1/10W Chip Resistor 0402 (1005 Metric) Automotive AEC-Q200 Thick Film
R93 | 47k | ERJ-2RKF4702X | Panasonic Industry | R_0402_1005Metric | Fit | C413103 | P47.0KLCT-ND | 667-ERJ-2RKF4702X | 47 kOhms ±1% 0.1W, 1/10W Chip Resistor 0402 (1005 Metric) Automotive AEC-Q200 Thick Film
R94 | 47k | ERJ-2RKF4702X | Panasonic Industry | R_0402_1005Metric | Fit | C413103 | P47.0KLCT-ND | 667-ERJ-2RKF4702X | 47 kOhms ±1% 0.1W, 1/10W Chip Resistor 0402 (1005 Metric) Automotive AEC-Q200 Thick Film
R95 | 47k | ERJ-2RKF4702X | Panasonic Industry | R_0402_1005Metric | Fit | C413103 | P47.0KLCT-ND | 667-ERJ-2RKF4702X | 47 kOhms ±1% 0.1W, 1/10W Chip Resistor 0402 (1005 Metric) Automotive AEC-Q200 Thick Film
R96 | 100k | ERJ-2RKF1003X | Panasonic Industry | R_0402_1005Metric | Fit | C192169 | P100KLCT-ND | 667-ERJ-2RKF1003X | 100 kOhms ±1% 0.1W, 1/10W Chip Resistor 0402 (1005 Metric) Automotive AEC-Q200 Thick Film
R97 | 10k 1% | ERJ-2RKF1002X | Panasonic Industry | R_0402_1005Metric | Fit | C191123 | P10.0KLCT-ND | 667-ERJ-2RKF1002X | 10 kOhms ±1% 0.1W, 1/10W Chip Resistor 0402 (1005 Metric) Automotive AEC-Q200 Thick Film
R98 | 15k 1% | ERJ-2RKF1502X | Panasonic Industry | R_0402_1005Metric | Fit | C413097 | P15.0KLCT-ND | 667-ERJ-2RKF1502X | 15 kOhms ±1% 0.1W, 1/10W Chip Resistor 0402 (1005 Metric) Automotive AEC-Q200 Thick Film
SW1 | KMR211NGLFS | KMR211NG LFS | C&K | KMR2x1NGLFS | Fit | C221676 | CKN10243CT-ND | 611-KMR211NGLFS | Tactile switch SPST-NO, 1.2N, 32V 50mA, silver contacts, IP40, 4.2x2.8mm SMD gullwing
U1 | TCAN1462VDRBRQ1 | TCAN1462VDRBRQ1 | Texas Instruments | TCAN1462V-Q1-DRB | Fit | C5215833 | 296-TCAN1462VDRBRQ1CT-ND | 595-TCAN1462VDRBRQ1 | Automotive CAN FD transceiver with SIC and VIO level-shift, 8 Mbps, 58-V bus fault, standby, VSO ...
U2 | LT3042xMSE | LT3042EMSE#PBF | Analog Devices | MSOP-10-1EP_3x3mm_P0.5mm_EP1.68x1.88mm | Fit | C69847 | 505-LT3042EMSE#PBF-ND | 584-LT3042EMSE#PBF | 200mA, Adjustable, Ultralow Noise, Ultrahigh PSRR RF Linear Regulator, MSOP-10
U3 |  | STM32F412CEU6 | STMicroelectronics | ST_UFQFPN-48-1EP_7x7mm_P0.5mm_EP5.6x5.6mm | Fit | C1337664 | 497-18545-ND | 511-STM32F412CEU6 | STM32F412CE Arm Cortex-M4F MCU, 100 MHz, 512 KB flash, 256 KB SRAM, UFQFPN48 7x7 mm 0.5 mm pitch ...
U4 | TPSM33610S5QRDNRQ1 | TPSM33610S5QRDNRQ1 | Texas Instruments | TPSM336xx-Q1 | Fit | C51957001 | 296-TPSM33610S5QRDNRQ1CT-ND | 595-SM33610S5QRDNRQ1 | 1A 5V fixed automotive synchronous buck power module, 3-36V VIN, QFN-FCMOD-11
U5 | TPS74501PDRVR | TPS74501PDRVR | Texas Instruments | TPS74x01P | Fit | C2841886 | 296-TPS74501PDRVRCT-ND | 595-TPS74501PDRVR | 500mA low-IQ high-PSRR adjustable LDO, open-drain PG with 150 us delay, WSON-6
U6 | LP5907MFX-3.3 | LP5907MFX-3.3/NOPB | Texas Instruments | SOT-23-5 | Fit | C80670 | 296-38557-1-ND | 595-LP5907MFX-3.3NPB | 250-mA Ultra-Low-Noise Low-IQ LDO, 3.3V, SOT-23
U7 | ADS131M08xPBS | ADS131M08IPBSR | Texas Instruments | TQFP-32_5x5mm_P0.5mm | Fit | C2862610 | 296-ADS131M08IPBSRCT-ND | 595-ADS131M08IPBSR | 8-channel, 24-bit, simultaneous sampling Delta-Sigma ADC, 32kSPS, G=1..128 PGA, SPI interface, i ...
Y1 | 8MHz 10pF | ECS-80-10-33-CGN-TR3 | ECS Inc. | Crystal_SMD_3225-4Pin_3.2x2.5mm | Fit | C7183312 | 50-ECS-80-10-33-CGN-TR3CT-ND | 520-80-10-33-CGN-TR3 | 8 MHz 10 pF load crystal, 3.2x2.5 mm, GND pads 2/4
