rcyaon/suspension-board/data/adams-mini-baja/mini_baja_parts.csv

Subsystem | Part | Symmetry | Count | Mass each (kg) | Mass total (kg) | Sprung % | CM x from part (mm) | CM y from part (mm) | CM z from part (mm) | Ixx (kg mm^2) | Iyy (kg mm^2) | Izz (kg mm^2) | Section
baja_dw_rear.sub | subframe | single | 1 | 1 | 1 | 100 | 0 | 0 | 149.9999999994 | 1.0000000005 | 1.0000000005 | 1.0000000005 | PART_ASSEMBLY
baja_dw_rear.sub | drive_shaft | left/right | 2 | 4.2174529406 | 8.434906 | 100 | 0 | 0 | -365.6817014647 | 165989.06562 | 165989.06562 | 692.8258536659 | PART_ASSEMBLY
baja_dw_rear.sub | lower_control_arm | left/right | 2 | 1.6629087861 | 3.325818 | 100 | 4.7397791183 | -1.3327599202 | 58.5711320574 | 14669.8365509993 | 34505.8650550141 | 20075.1108630053 | PART_ASSEMBLY
baja_dw_rear.sub | lower_control_arm2 | left/right | 2 | 1 | 2 | 100 | 0 | 0 | 0 | 100 | 100 | 100 | PART_ASSEMBLY
baja_dw_rear.sub | lower_strut | left/right | 2 | 5 | 10 | 100 | 0 | 0 | 0 | 1.0000000005 | 1.0000000005 | 1.0000000005 | PART_ASSEMBLY
baja_dw_rear.sub | spindle | left/right | 2 | 1.1028403931 | 2.205681 | 100 | 0 | 0 | 14.9999999999 | 477.8975036801 | 477.8975036801 | 496.2781768715 | PART_ASSEMBLY
baja_dw_rear.sub | tierod_inner | left/right | 2 | 1 | 2 | 100 | 0 | 0 | 0 | 1 | 1 | 1 | PART_ASSEMBLY
baja_dw_rear.sub | tierod_outer | left/right | 2 | 1 | 2 | 100 | 0 | 0 | 0 | 1 | 1 | 1 | PART_ASSEMBLY
baja_dw_rear.sub | tripot | left/right | 2 | 1.9851127075 | 3.970225 | 100 | 0 | 0 | 13.8888888897 | 1101.8600904956 | 1101.8600904956 | 813.8962100962 | PART_ASSEMBLY
baja_dw_rear.sub | upper_control_arm | left/right | 2 | 1.0030822408 | 2.006164 | 100 | -3.2492670295 | 0 | 44.5679265383 | 5755.987035363 | 7485.6933100743 | 1838.5550157111 | PART_ASSEMBLY
baja_dw_rear.sub | upper_strut | left/right | 2 | 5 | 10 | 100 | 0 | 0 | 0 | 1.0000000005 | 1.0000000005 | 1.0000000005 | PART_ASSEMBLY
baja_dw_rear.sub | upright | left/right | 2 | 3.6382197927 | 7.27644 | 100 | 24.7110210579 | 50.4417588928 | 11.6960296584 | 40802.7390439917 | 42306.3470500134 | 8340.0654158878 | PART_ASSEMBLY
baja_frame.sub | frame | single | 1 | 42.9186083435 | 42.918608 | 100 | 4.8261130884 | 351.5814123527 | 250.3380939253 | 13559683.943 | 6036911.2847 | 9978160.0252 | PART_ASSEMBLY
baja_front_suspension.sub | subframe | single | 1 | 50 | 50 | 100 | 0 | 0 | 149.9999999994 | 1.0000000005 | 1.0000000005 | 1.0000000005 | PART_ASSEMBLY
baja_front_suspension.sub | drive_shaft | left/right | 2 | 4.2174529406 | 8.434906 | 100 | 0 | 0 | -365.6817014647 | 165989.06562 | 165989.06562 | 692.8258536659 | PART_ASSEMBLY
baja_front_suspension.sub | lower_control_arm | left/right | 2 | 1.2585941448 | 2.517188 | 100 | 0.3755068334 | -0.048659067 | 53.1632597566 | 8826.6108269838 | 11962.2175481191 | 3267.6557991862 | PART_ASSEMBLY
baja_front_suspension.sub | lower_control_arm2 | left/right | 2 | 1 | 2 | 100 | 0 | 0 | 0 | 100 | 100 | 100 | PART_ASSEMBLY
baja_front_suspension.sub | lower_strut | left/right | 2 | 1 | 2 | 100 | 0 | 0 | 0 | 1.0000000005 | 1.0000000005 | 1.0000000005 | PART_ASSEMBLY
baja_front_suspension.sub | spindle | left/right | 2 | 1.1028403931 | 2.205681 | 100 | 0 | 0 | 14.9999999999 | 477.8975036801 | 477.8975036801 | 496.2781768715 | PART_ASSEMBLY
baja_front_suspension.sub | tierod_inner | left/right | 2 | 1 | 2 | 100 | 0 | 0 | 0 | 1 | 1 | 1 | PART_ASSEMBLY
baja_front_suspension.sub | tierod_outer | left/right | 2 | 1 | 2 | 100 | 0 | 0 | 0 | 1 | 1 | 1 | PART_ASSEMBLY
baja_front_suspension.sub | tripot | left/right | 2 | 1.9851127075 | 3.970225 | 100 | 0 | 0 | 13.8888888897 | 1101.8600904956 | 1101.8600904956 | 813.8962100962 | PART_ASSEMBLY
baja_front_suspension.sub | upper_control_arm | left/right | 2 | 1.0898458291 | 2.179692 | 100 | 0.4524900755 | 0 | 48.770965008 | 6853.9502778226 | 9694.866311484 | 2959.2443868273 | PART_ASSEMBLY
baja_front_suspension.sub | upper_strut | left/right | 2 | 1 | 2 | 100 | 0 | 0 | 0 | 1.0000000005 | 1.0000000005 | 1.0000000005 | PART_ASSEMBLY
baja_front_suspension.sub | upright | left/right | 2 | 2.0966221 | 4.193244 | 100 | 4.6737466698 | 66.9207758712 | -7.084493131 | 6528.2028936822 | 5746.2509422746 | 1769.3494505115 | PART_ASSEMBLY
baja_front_tires.sub | wheel | left/right | 2 | 10 | 20 | 0 |  |  |  | 50000 | 50000 | 10000 | WHEEL_ASSEMBLY
baja_powertrain.sub | powertrain | single | 1 | 23.5 | 23.5 | 100 | 0 | 0 | 0 | 202000 | 242000 | 185000 | PART_ASSEMBLY
baja_powertrain.sub | diff_output | left/right | 2 | 2 | 4 | 100 | 0 | 0 | 0 | 1 | 1 | 1 | PART_ASSEMBLY
baja_powertrain_direct.sub | powertrain | single | 1 | 23.5 | 23.5 | 100 | 0 | 0 | 0 | 202000 | 242000 | 185000 | PART_ASSEMBLY
baja_rear_tires.sub | wheel | left/right | 2 | 10 | 20 | 0 |  |  |  | 50000 | 50000 | 10000 | WHEEL_ASSEMBLY
baja_rear_tires_large.sub | wheel | left/right | 2 | 10 | 20 | 0 |  |  |  | 50000 | 50000 | 10000 | WHEEL_ASSEMBLY
baja_steering.sub | pinion | single | 1 | 0.5 | 0.5 | 100 | 0 | 0 | 0 | 1.0000000005 | 1.0000000005 | 1.0000000005 | PART_ASSEMBLY
baja_steering.sub | rack | single | 1 | 0.7673154258 | 0.767315 | 100 | 0 | 0 | 0 | 8102.56606854 | 8102.56606854 | 33.7856137587 | PART_ASSEMBLY
baja_steering.sub | rack_housing | single | 1 | 1.2331855057 | 1.233186 | 100 | 0 | 0 | 0 | 6691.1019369207 | 6691.1019369207 | 122.1711925931 | PART_ASSEMBLY
baja_steering.sub | steering_shaft | single | 1 | 3.8402178979 | 3.840218 | 100 | 0 | 0 | 286.8192469979 | 165681.51056 | 165681.51056 | 418.8756073553 | PART_ASSEMBLY
baja_steering.sub | steering_wheel | single | 1 | 2.1500262923 | 2.150026 | 100 | 0 | 0 | 0.5768768879 | 25892.1478540083 | 25892.1478540083 | 51629.1769820088 | PART_ASSEMBLY
baja_swingarm.sub | rear_axle | single | 1 | 3.314705255 | 3.314705 | 100 | 0 | 0 | 0 | 206140.10712 | 206140.10712 | 259.6108904164 | PART_ASSEMBLY
baja_swingarm.sub | swingarm | single | 1 | 5.3040777002 | 5.304078 | 100 | 440.0066461343 | 304.7899094182 | 11.6826043386 | 425592.2646 | 154772.5621 | 575364.55074 | PART_ASSEMBLY
baja_swingarm.sub | lower_strut | left/right | 2 | 1 | 2 | 100 | 0 | 0 | 0 | 1.0000000005 | 1.0000000005 | 1.0000000005 | PART_ASSEMBLY
baja_swingarm.sub | upper_strut | left/right | 2 | 1 | 2 | 100 | 0 | 0 | 0 | 1.0000000005 | 1.0000000005 | 1.0000000005 | PART_ASSEMBLY
