rcyaon/suspension-board/eda/3dmodels/LQFP-64_10x10mm_P0.5mm.step

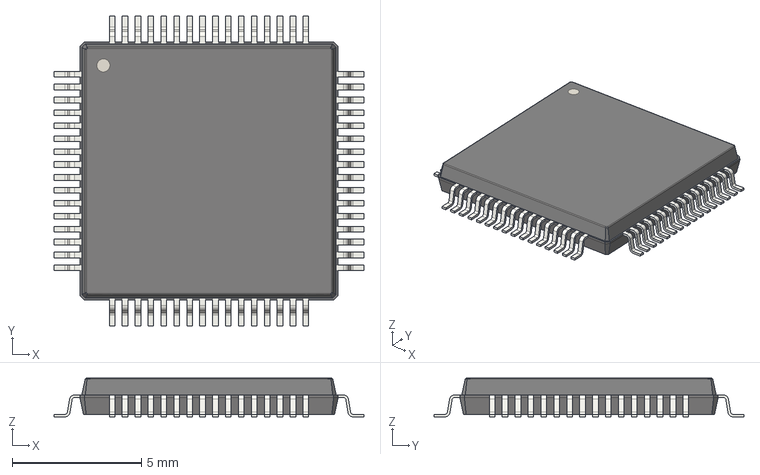
[picture p5: CAD file, 2026-10-19]
eda/3dmodels/LQFP-64_10x10mm_P0.5mm.step
12.0 x 12.0 x 1.50 mm
