rcyaon/suspension-board/fab/rev-b/3d/suspension-load-daq.step

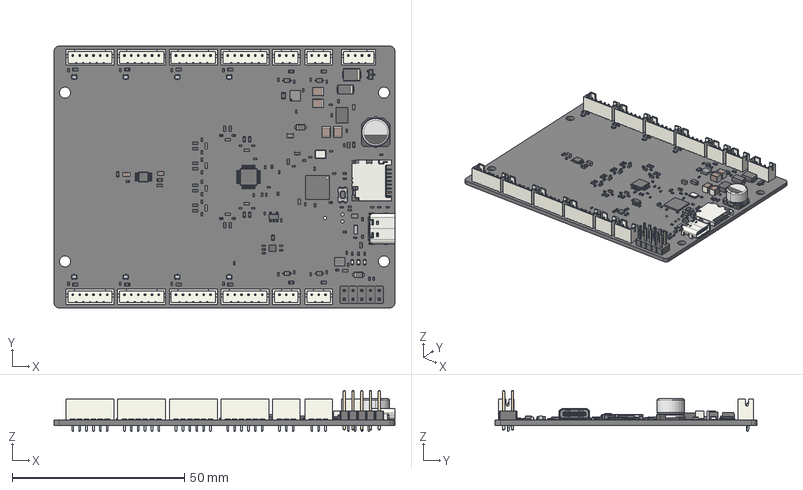
[picture p6: CAD file, 2026-10-19]
fab/rev-b/3d/suspension-load-daq.step
99.0 x 76.0 x 11.9 mm
D_SOD_123F x 2
R_0402_1005Metric x 29
C_0402_1005Metric x 58
R_0603_1608Metric x 34
C_0603_1608Metric x 14
C_0805_2012Metric x 4
JST_B6B_PH_K x 8
WSIZE CODE E-001
WSIZE CODE E-002
WSIZE CODE E-003 x 2
LED_0603_1608Metric x 3
JST_B3B_PH_K x 4
3D SOT-523 x 8
D_SOD-323 x 4
TQFP-32_5x5mm_P0.5mm
MOLD_CPOMPOUND_AF0
SOLID1-489_AF0
SOLID1-490_AF0
SOLID1-491_AF0
SOLID1-492_AF0
SOLID1-493_AF0
SOLID1-494_AF0
SOLID1-495_AF0
SOLID1-496_AF0
SOLID1-497_AF0
SOLID1-498_AF0
SOT-23-5
R_0805_2012Metric
C_1210_3225Metric x 4
JST_B4B_PH_K
Crystal_SMD_3225-4Pin_3.2x2.5mm
ThermalPin
PinsArrayLR
ST_UFQFPN-48-1EP_7x7mm_P0.5mm_EP5.6x5.6mm
D_SMB
SOT23 lower body
SOT23 Lead x 3
SOT23 Upper body
D_SMA
BODY-SON_AF0
PIN1-ID
SW_Push_1P1T-SH_NO_CK_KMR2xxG
microSD_HC_Hirose_DM3D-SF
USB_C_Receptacle_16P_TopMnt_Horizontal_GCT_USB4105-xx-A
TPD4EUSB30DQAR
ICM-20690
MSOP-10-1EP_3x3mm_P0.5mm_EP1.68x1.88mm
suspension-load-daq_PCB
