rcyaon/suspension-board/eda/3dmodels/SOT-23-5.step

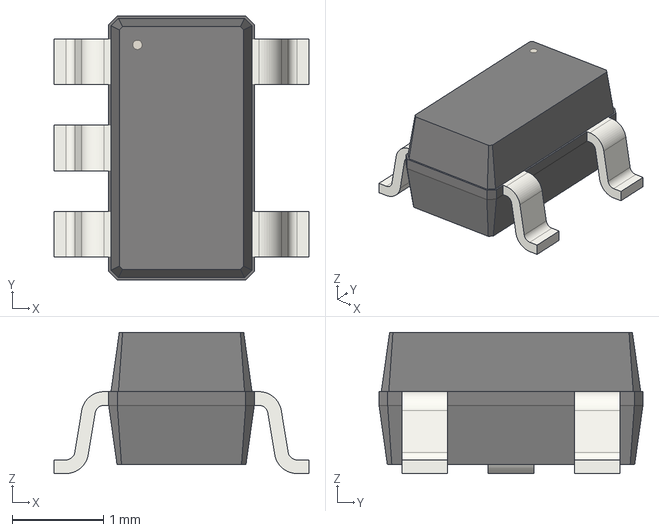
[picture p7: CAD file, 2026-10-16]
eda/3dmodels/SOT-23-5.step
2.80 x 2.90 x 1.55 mm
