rcyaon/suspension-board/eda/3dmodels/MSOP-10-1EP_3x3mm_P0.5mm_EP1.68x1.88mm.step

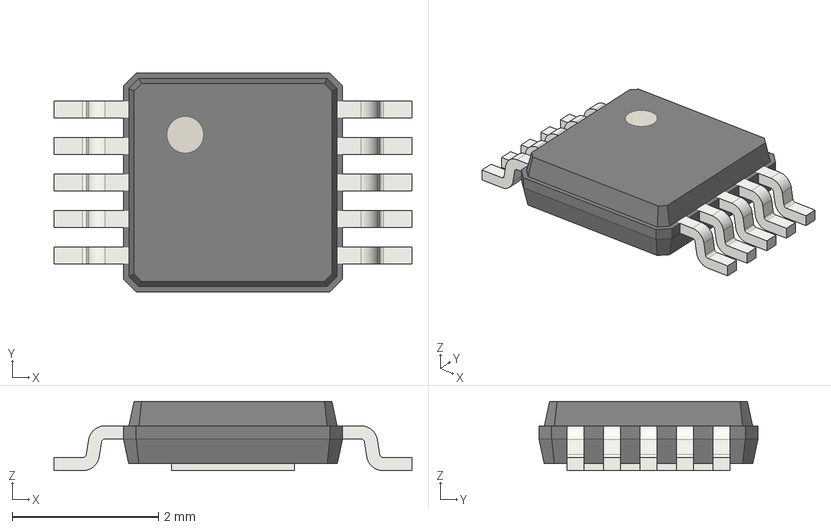
[picture p8: CAD file, 2026-10-16]
eda/3dmodels/MSOP-10-1EP_3x3mm_P0.5mm_EP1.68x1.88mm.step
4.90 x 3.00 x 0.95 mm
