rcyaon/suspension-board/firmware/test/data/adams_rear_drive.csv

t_s | road_mm | shock_travel_mm | shock_vel_mm_s | shock_force_n | tire_load_n | lca_axial_n | lca_foreaft_n | lca_normal_n | uca_axial_n | toe_link_n | ch1_mvv | ch2_mvv | ch3_mvv | ch4_mvv | ch5_mvv | ch6_mvv | ch7_mvv | ch8_mvv | aux1_v | accel_x_g | accel_y_g | accel_z_g | gyro_x_dps | gyro_y_dps | gyro_z_dps
0 | 0 | 43.2 | 0 | 1123.439 | 937.1782 | 221.7668 | 0 | 716.0798 | -259.8514 | 0 | 0.005612915 | 0.005612915 | 0.2429444 | 0.2356561 | -0.006576835 | -0.006576835 | 0 | 0.2808597 | 1.9884 | -0 | 0 | 1.000017 | 0 | -0 | 0
0.001 | -0.04078564 | 43.19858 | -3.735912 | 1116.412 | 713.3492 | 220.3798 | 0 | 711.6012 | -258.2262 | 0 | 0.00557781 | 0.00557781 | 0.2414249 | 0.2341822 | -0.006535701 | -0.006535701 | 0 | 0.2791031 | 1.988383 | -0 | 0 | 0.9937625 | 0 | -0 | 0
0.002 | -0.1457166 | 43.1904 | -12.77887 | 1099.342 | 579.622 | 217.0102 | 0 | 700.7208 | -254.2779 | 0 | 0.005492525 | 0.005492525 | 0.2377336 | 0.2306015 | -0.00643577 | -0.00643577 | 0 | 0.2748356 | 1.988285 | -0 | 0 | 0.9785679 | 0 | -0 | 0
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
