rcyaon/suspension-board/fab/rev-b/docs/suspension-load-daq-assembly-top.pdf

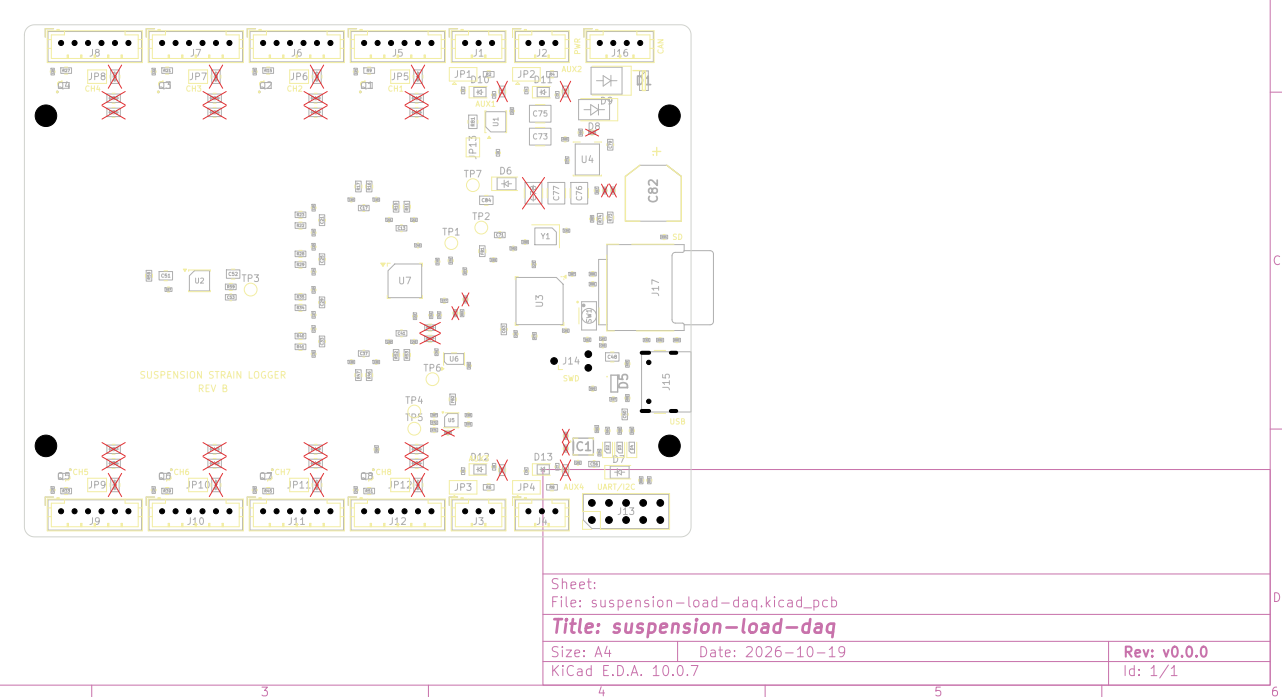
[picture p9: page 1]

Sheet:
File: suspension-load-daq.kicad_pcb
Title: suspension-load-daq

Size: A4 | Rev: v0.0.0
KiCad E.D.A. 10.0.7 | Id: 1/1
