rcyaon/suspension-board/fab/rev-b/docs/suspension-load-daq-schematic.pdf

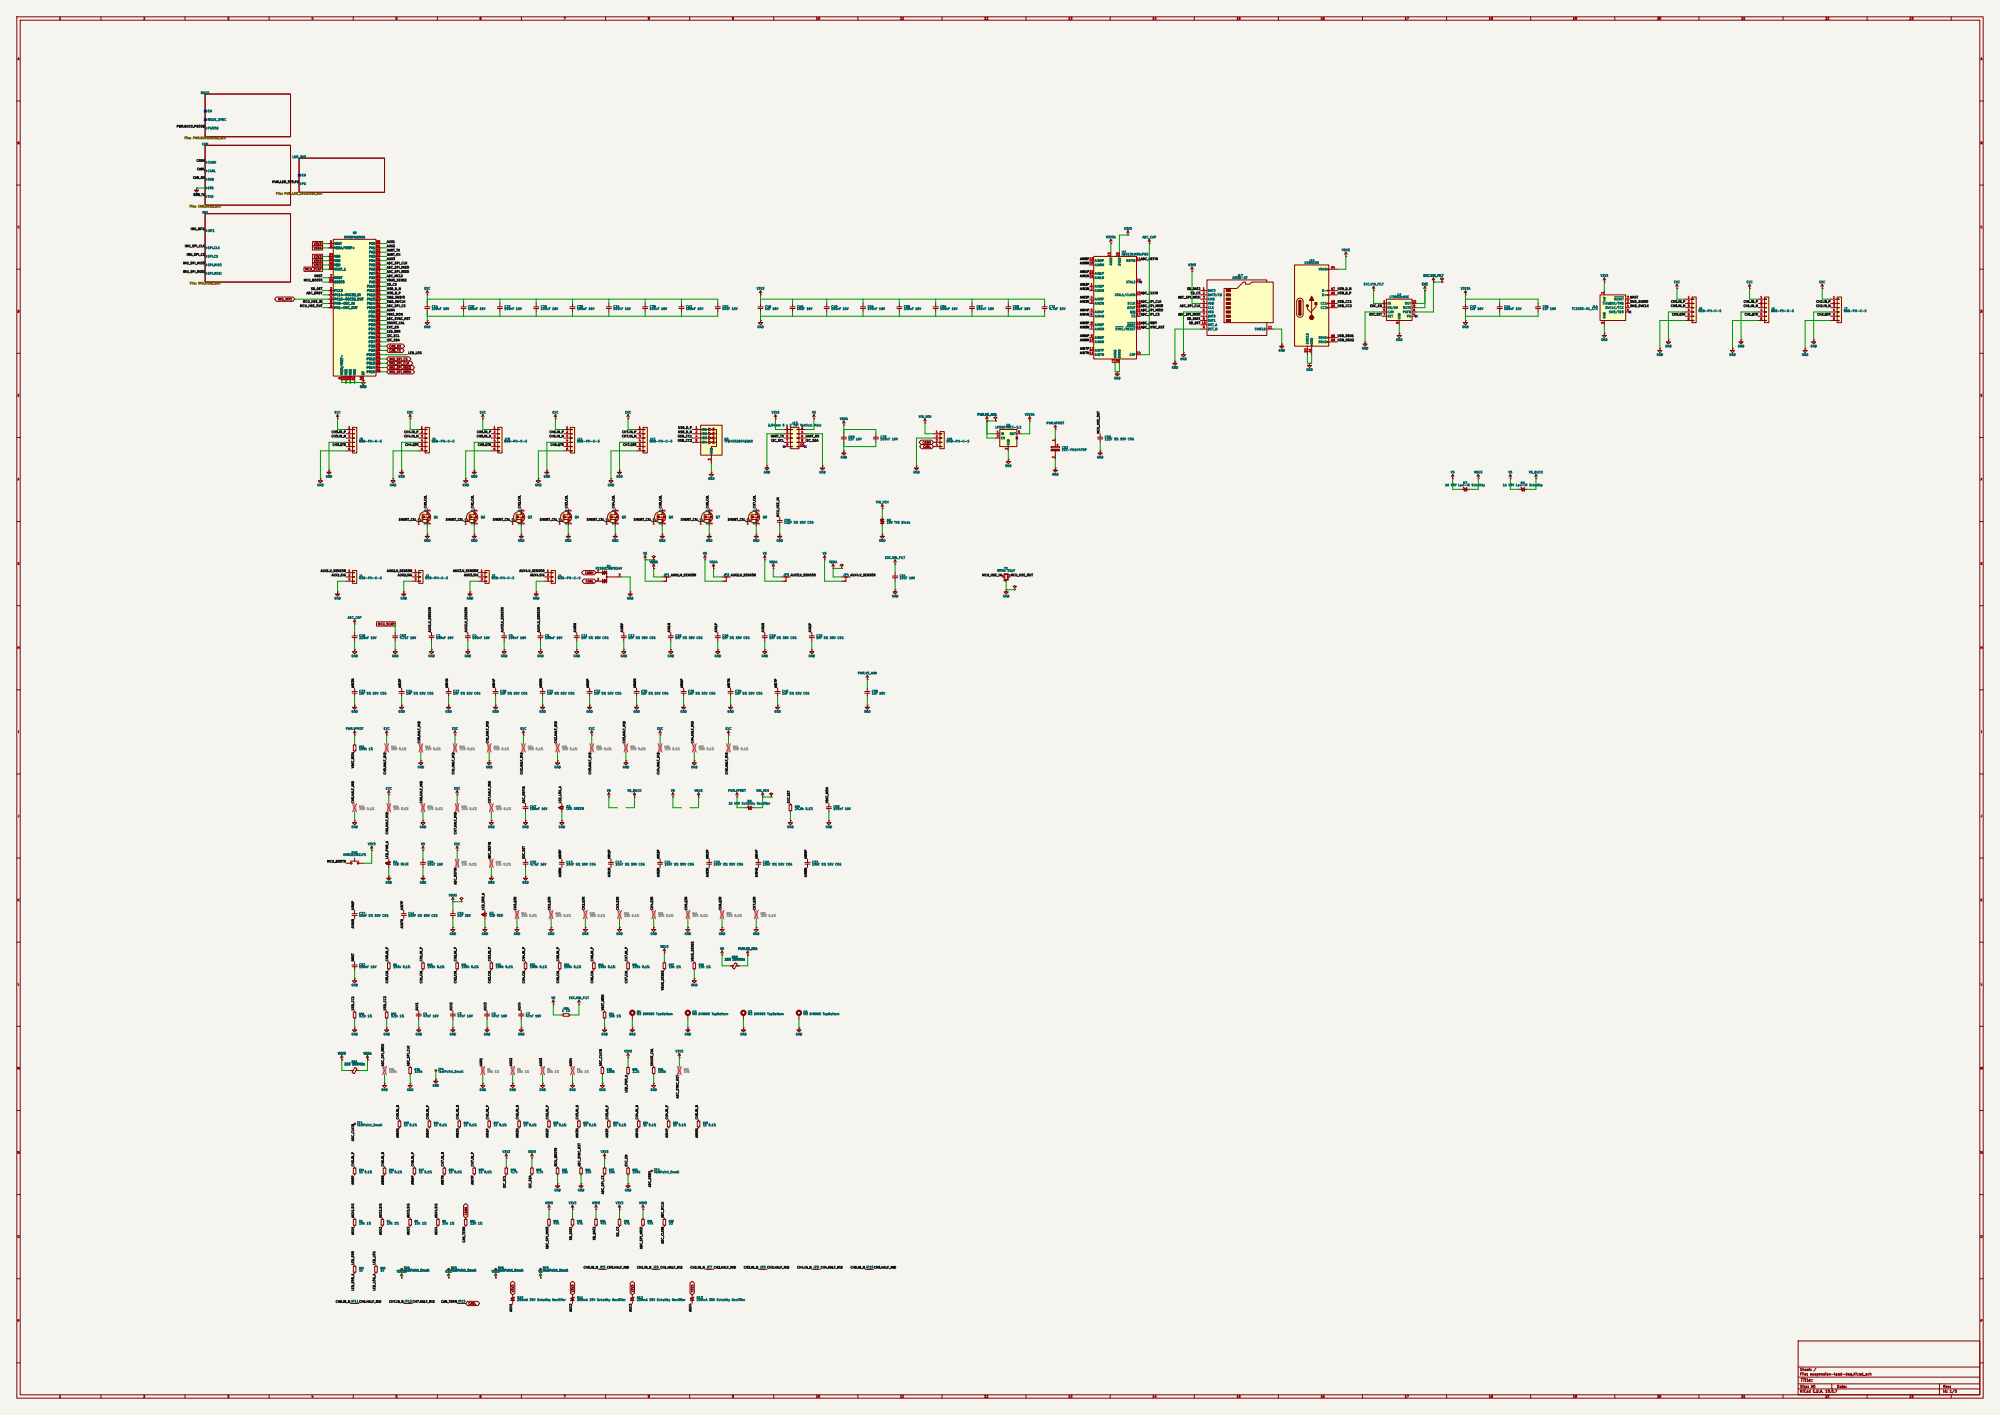
[picture p10: page 1]

200mA 30V Schottky Rectifier TP7 TestPoint_Small D10 200mA 30V Schottky Rectifier V5

Sheet: /
File: suspension-load-daq.kicad_sch
Title:

Size: A0 | Rev:
KiCad E.D.A. 10.0.7 | Id: 1/5

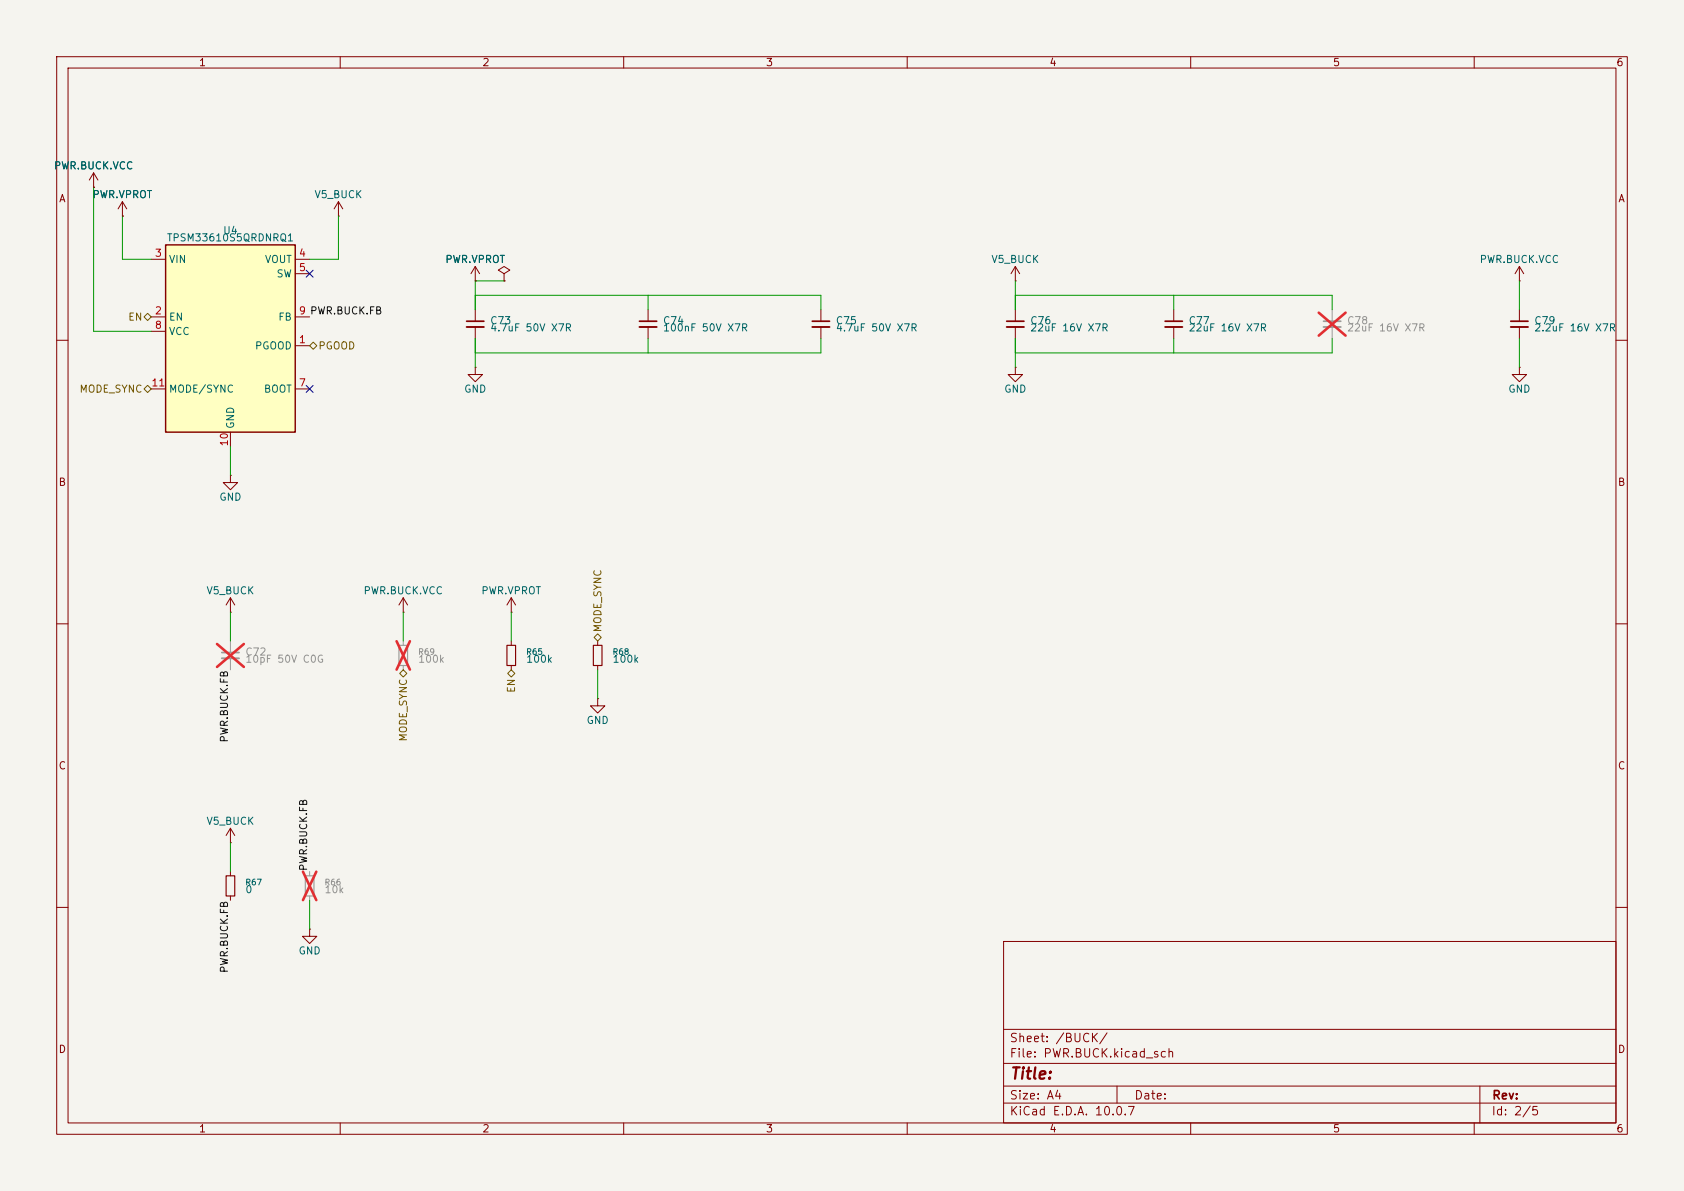
[picture p11: page 2]

PWR.VPROT PWR.VPROT PWR.BUCK.VCC

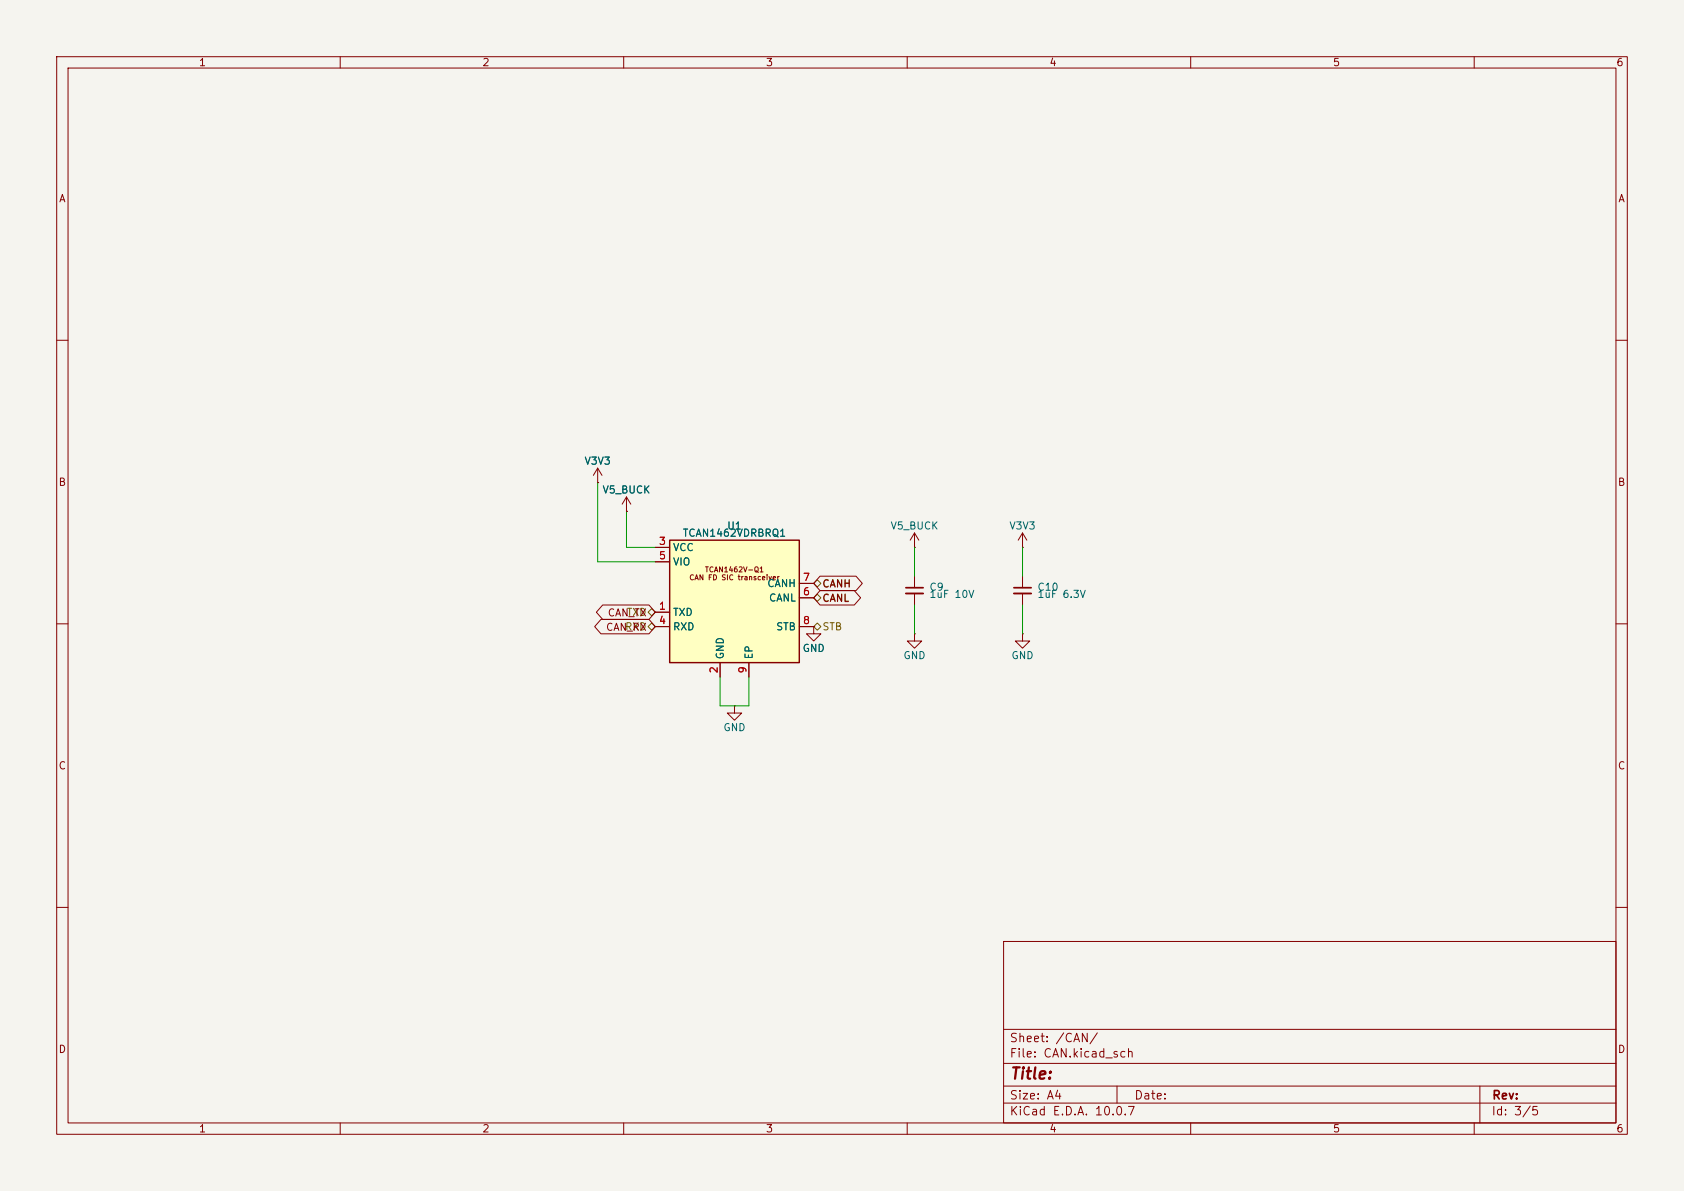
[picture p12: page 3]

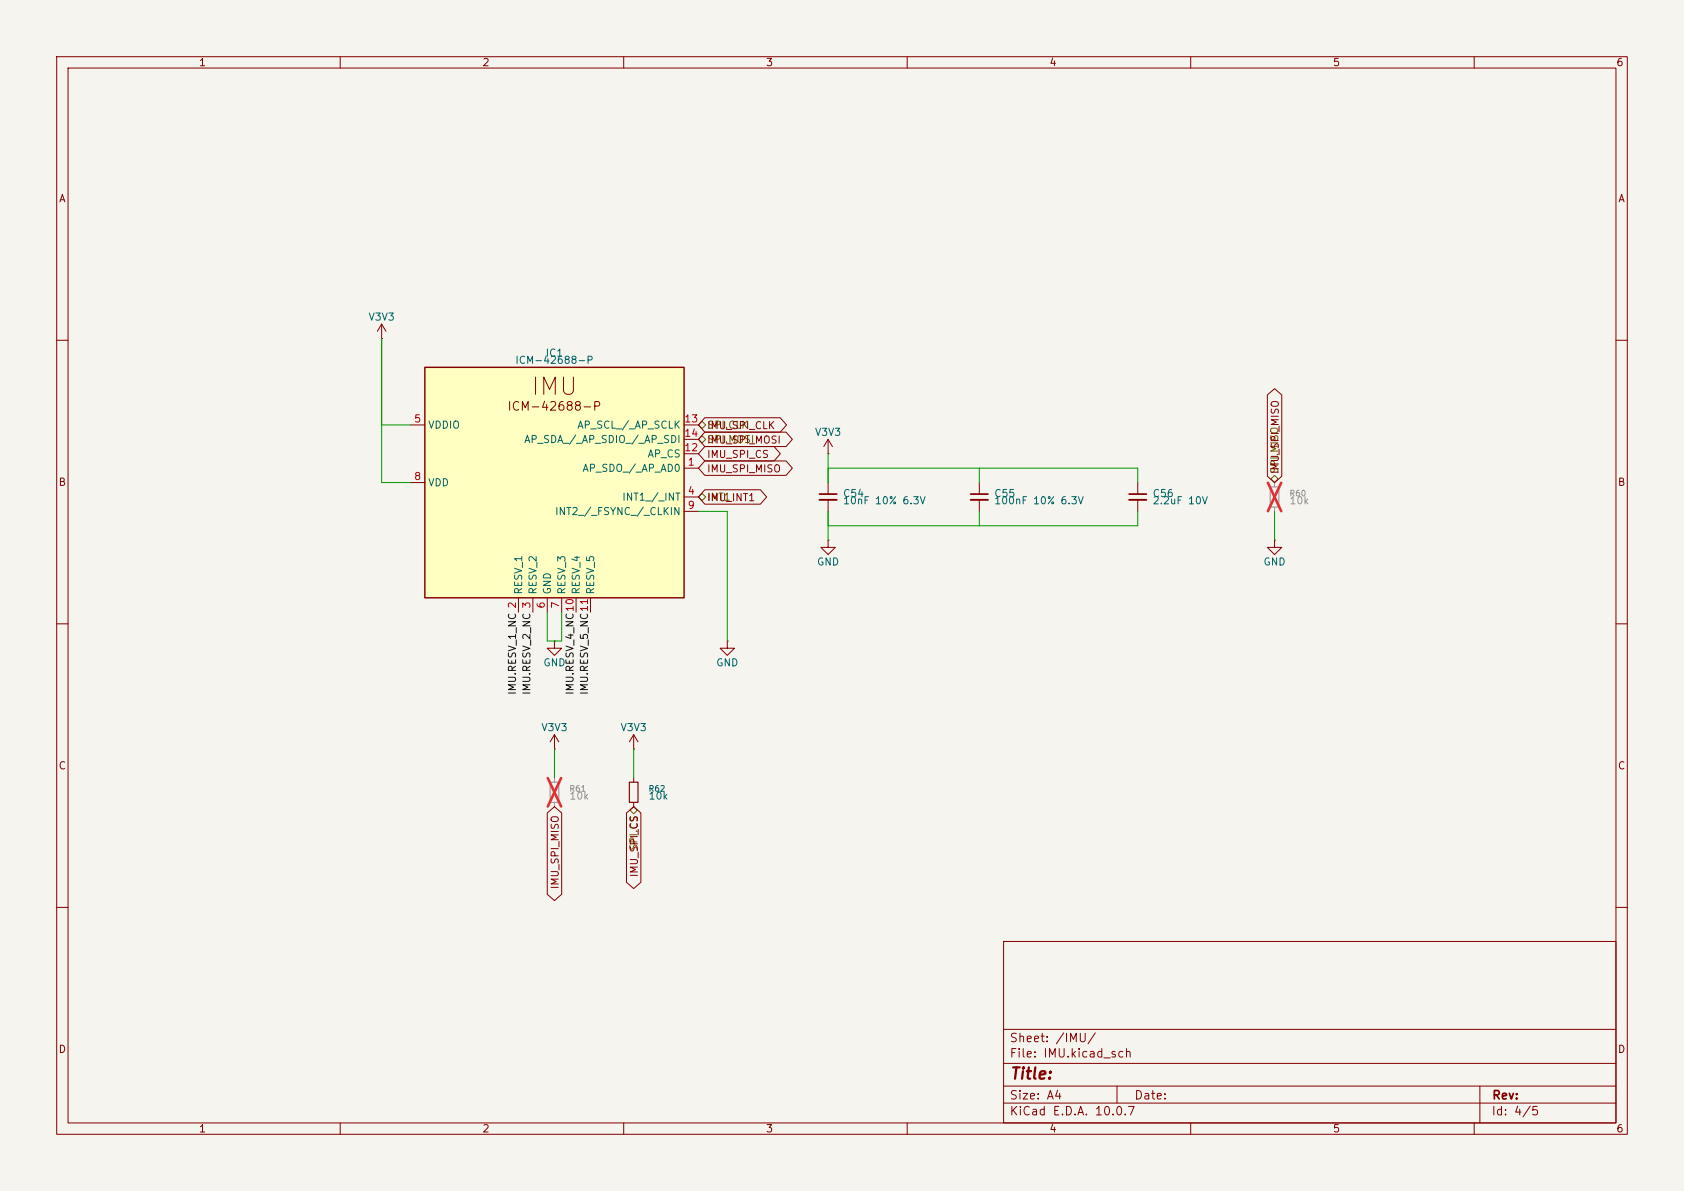
[picture p13: page 4]

SPI.MOSI SPI.CLK
IMU_SPI_CLK

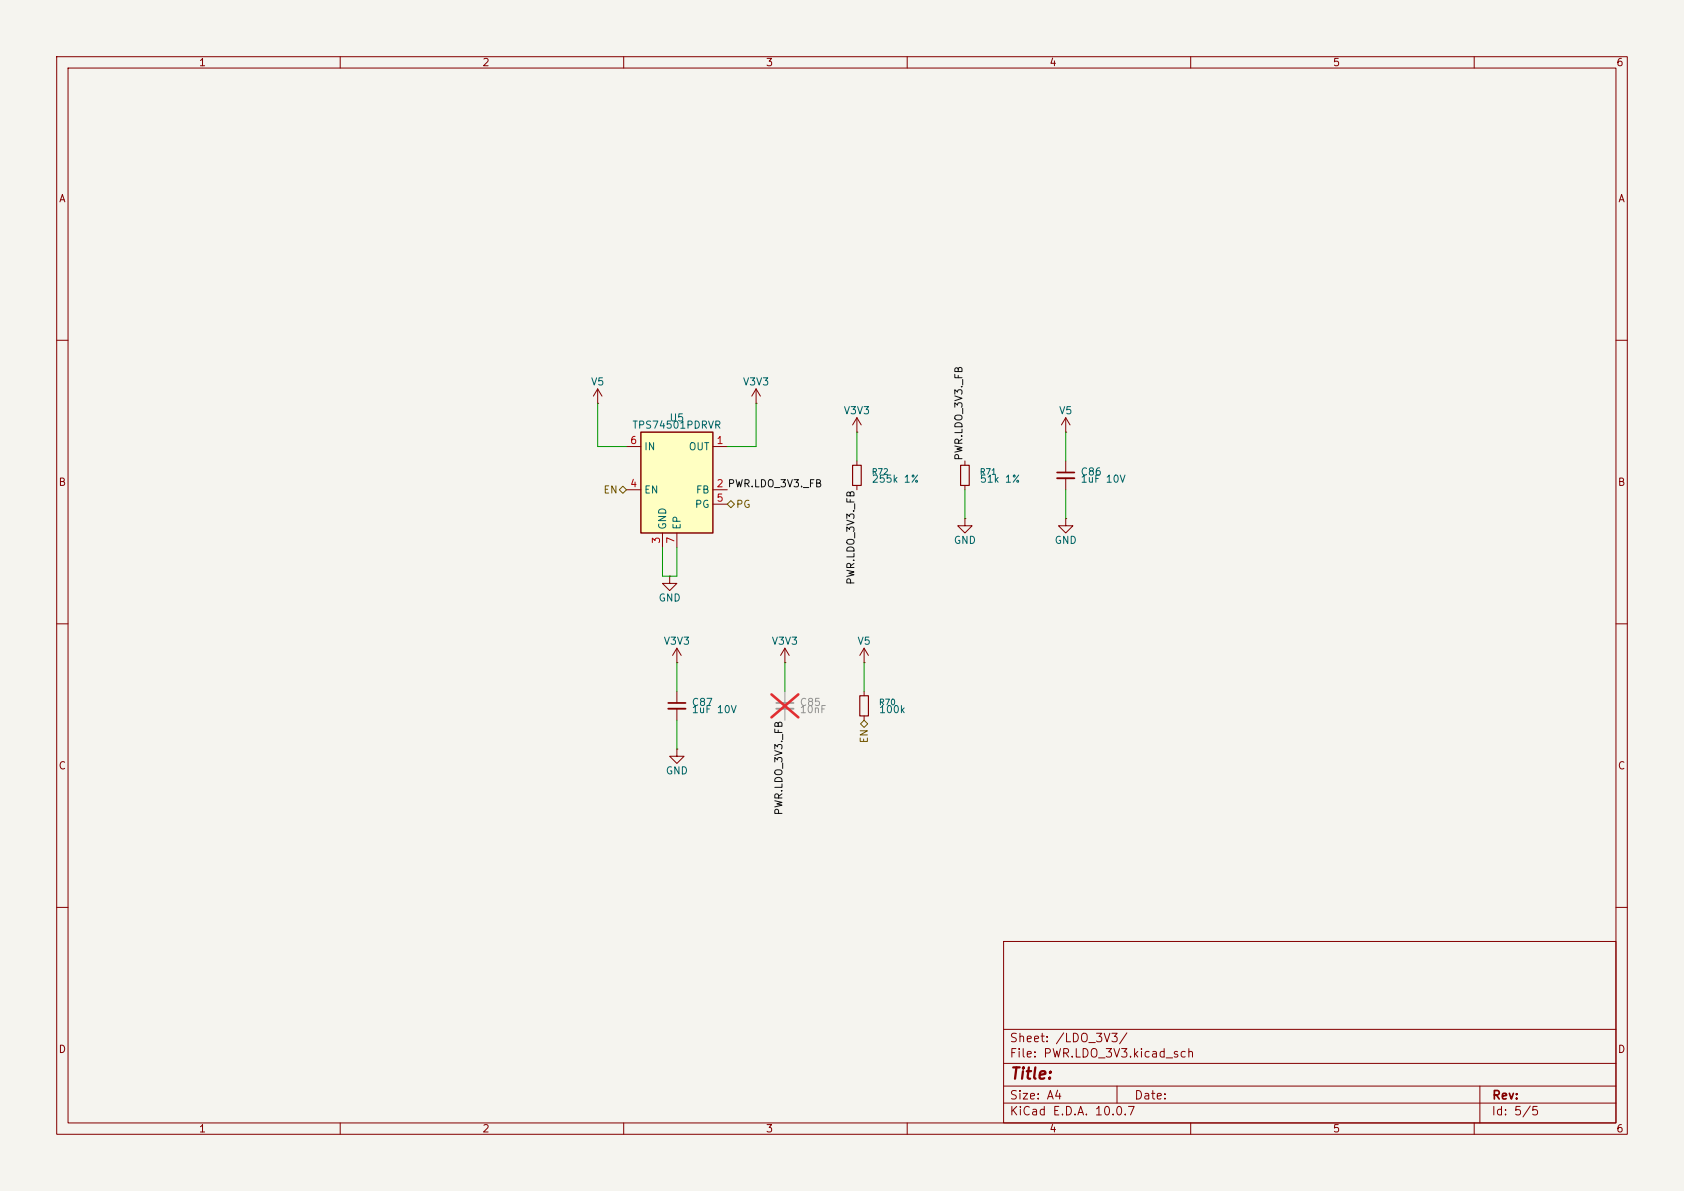
[picture p14: page 5]
