rcyaon/suspension-board/data/olin-baja/source/olin_baja_suspension.pdf

Variable | Value
Bump Travel (mm) | 228.600

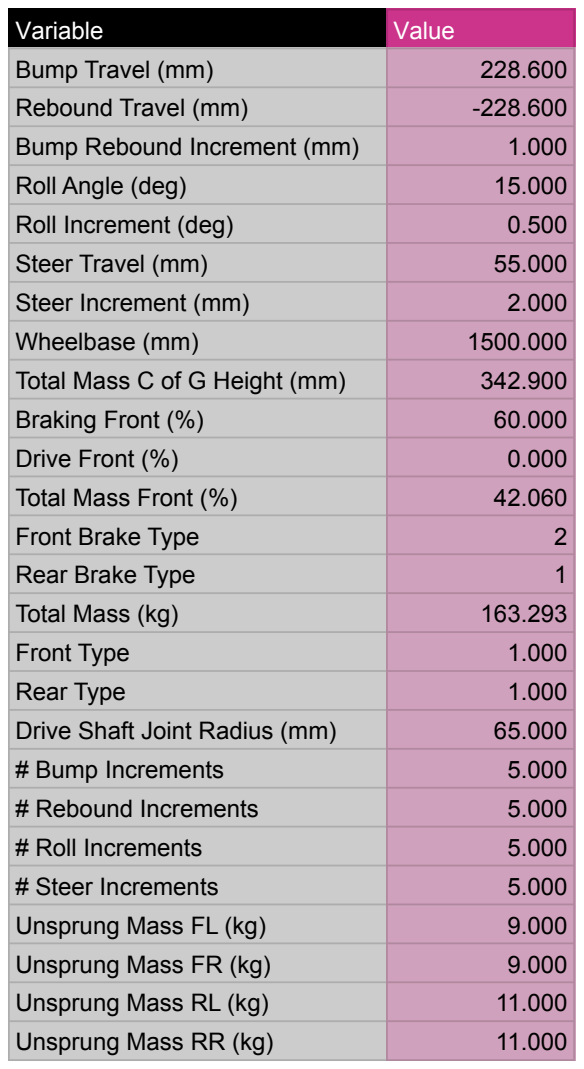
[picture p15: page 1]
Rebound Travel (mm); Bump Rebound Increment (mm); Roll Angle (deg); Roll Increment (deg); Steer Travel (mm); Steer Increment (mm); Wheelbase (mm); Total Mass C of G Height (mm); Braking Front (%); Drive Front (%); Total Mass Front (%); Front Brake Type; Rear Brake Type; Total Mass (kg); Front Type; Rear Type; Drive Shaft Joint Radius (mm); # Bump Increments; # Rebound Increments; # Roll Increments; # Steer Increments; Unsprung Mass FL (kg); Unsprung Mass FR (kg); Unsprung Mass RL (kg)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

(#) | HARD POINT LOCATION | X (mm) | Y (mm) | Z (mm)
1 | Lower Wishbone Front Pivot | -946.454 | -173.635 | 65.741

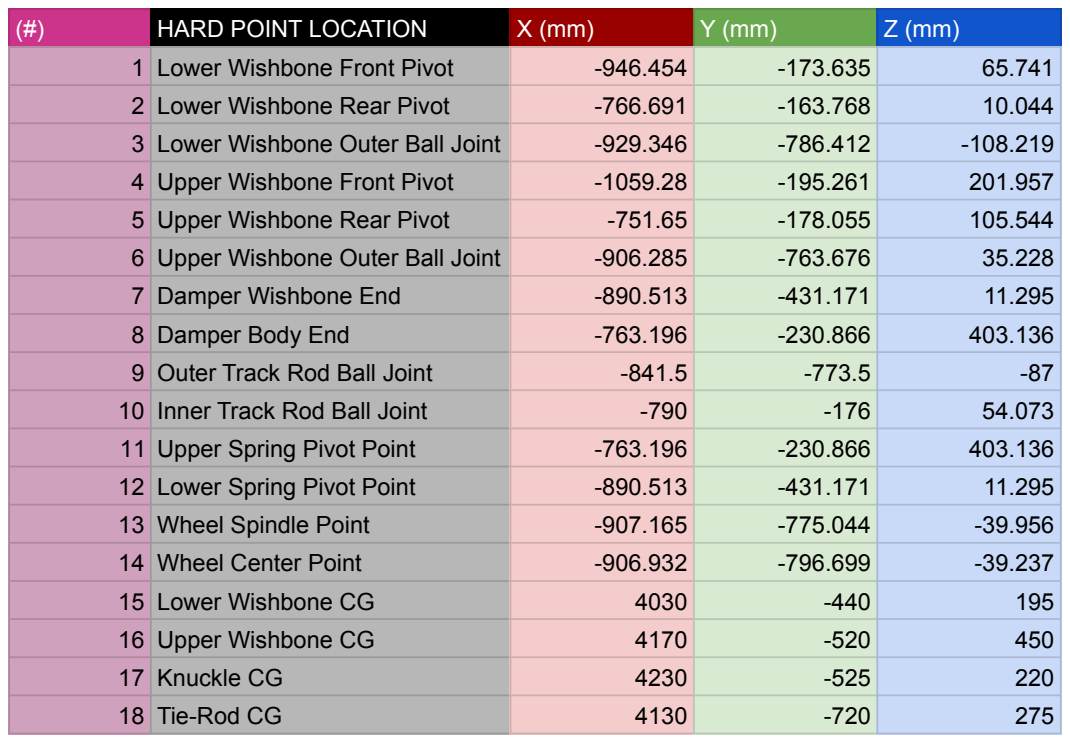
[picture p16: page 2]
Lower Wishbone Rear Pivot; Lower Wishbone Outer Ball Joint; Upper Wishbone Front Pivot; Upper Wishbone Rear Pivot; Upper Wishbone Outer Ball Joint; Damper Wishbone End; Damper Body End; Outer Track Rod Ball Joint; Inner Track Rod Ball Joint; Upper Spring Pivot Point; Lower Spring Pivot Point; Wheel Spindle Point; Wheel Center Point; Lower Wishbone CG; Upper Wishbone CG; Knuckle CG; Tie-Rod CG

(#) | HARD POINT LOCATION | X (in) | Y (in) | Z (in)
1 | Lower Wishbone Front Pivot | -37.262 | -6.836 | 2.588

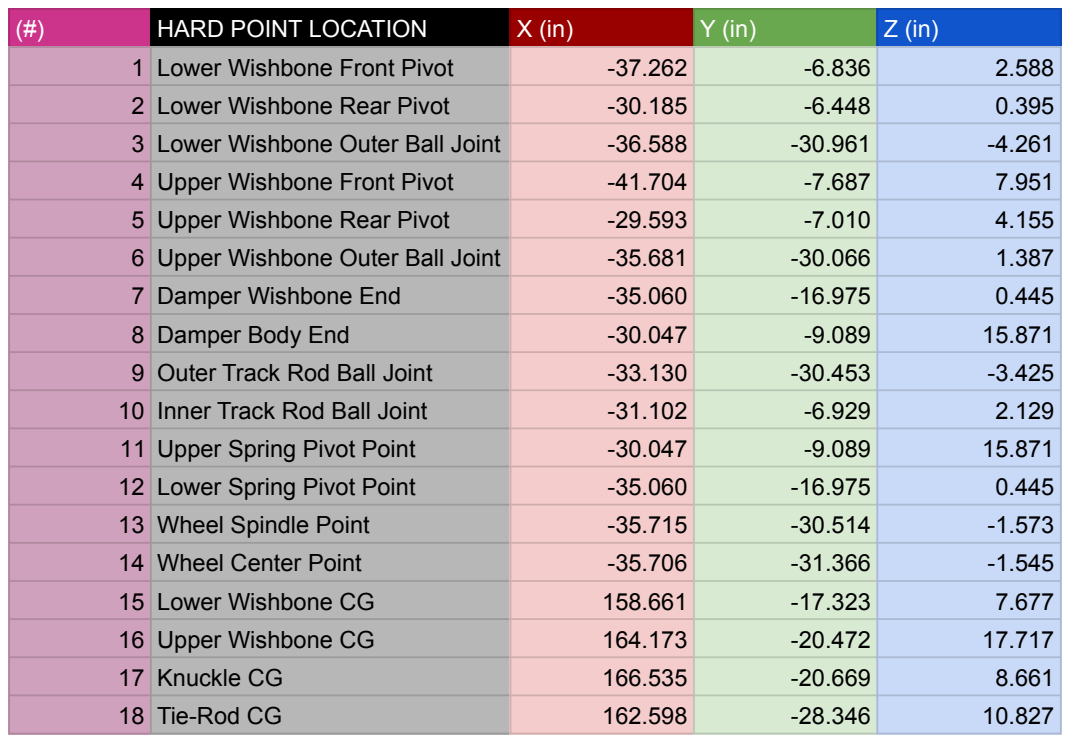
[picture p17: page 3]
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

(#) | HARD POINT LOCATION | X (in) | Y (in) | Z (in)
1 | Lower Wish Front Pivot | 1211.734 | 292.087 | 404.298

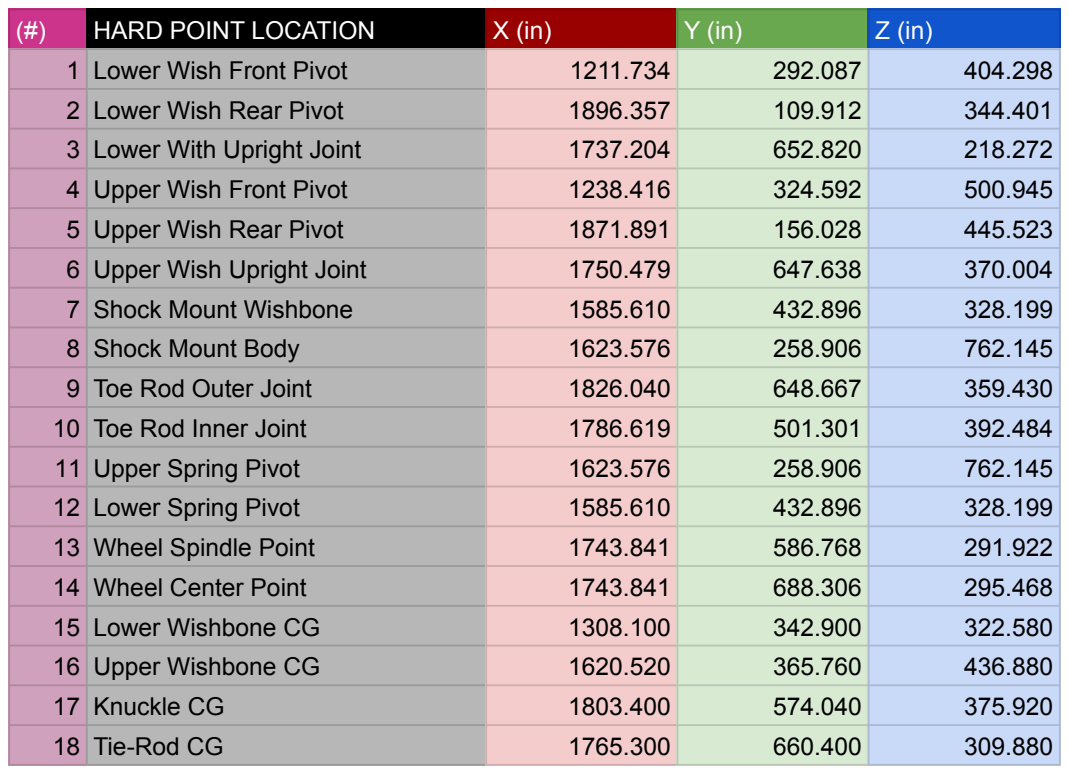
[picture p18: page 4]
Lower Wish Rear Pivot; Lower With Upright Joint; Upper Wish Front Pivot; Upper Wish Rear Pivot; Upper Wish Upright Joint; Shock Mount Wishbone; Shock Mount Body; Toe Rod Outer Joint; Toe Rod Inner Joint; Upper Spring Pivot; Lower Spring Pivot; Wheel Spindle Point; Wheel Center Point; Lower Wishbone CG; Upper Wishbone CG; Knuckle CG; Tie-Rod CG

(#) | HARD POINT LOCATION | X (in) | Y (in) | Z (in)
1 | Lower Wish Front Pivot | 47.706 | 11.499 | 15.917

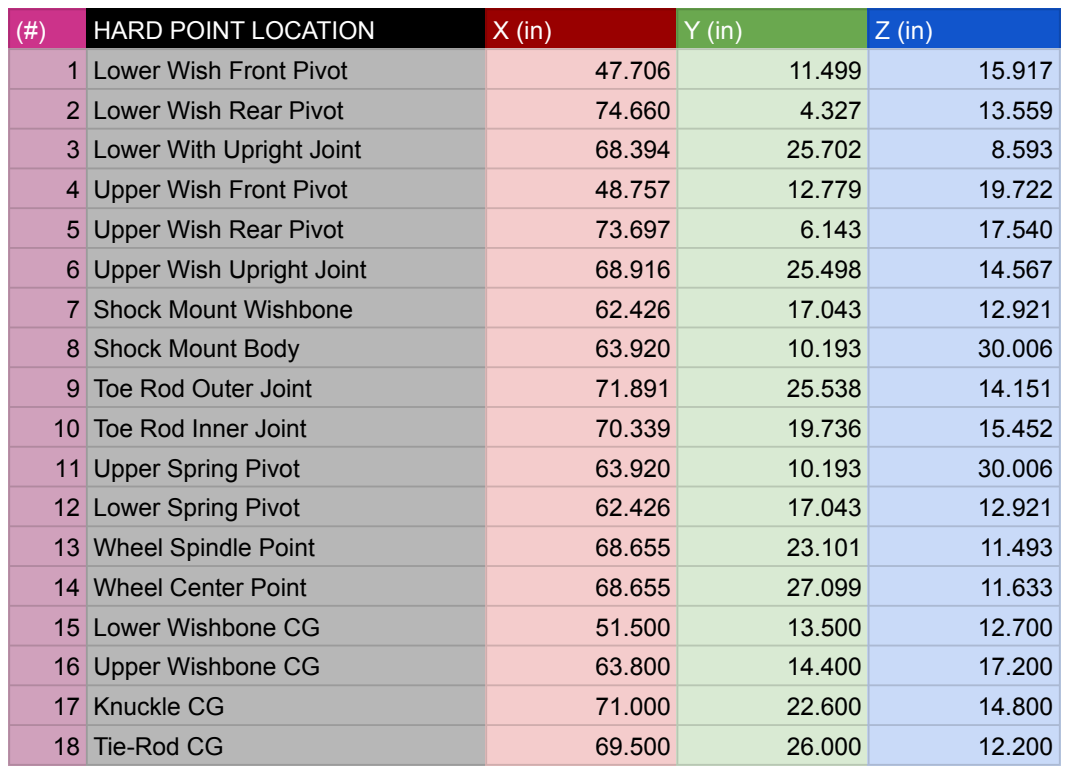
[picture p19: page 5]
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

## Ackermann (%)

X | Front -ve Y | Front +ve Y

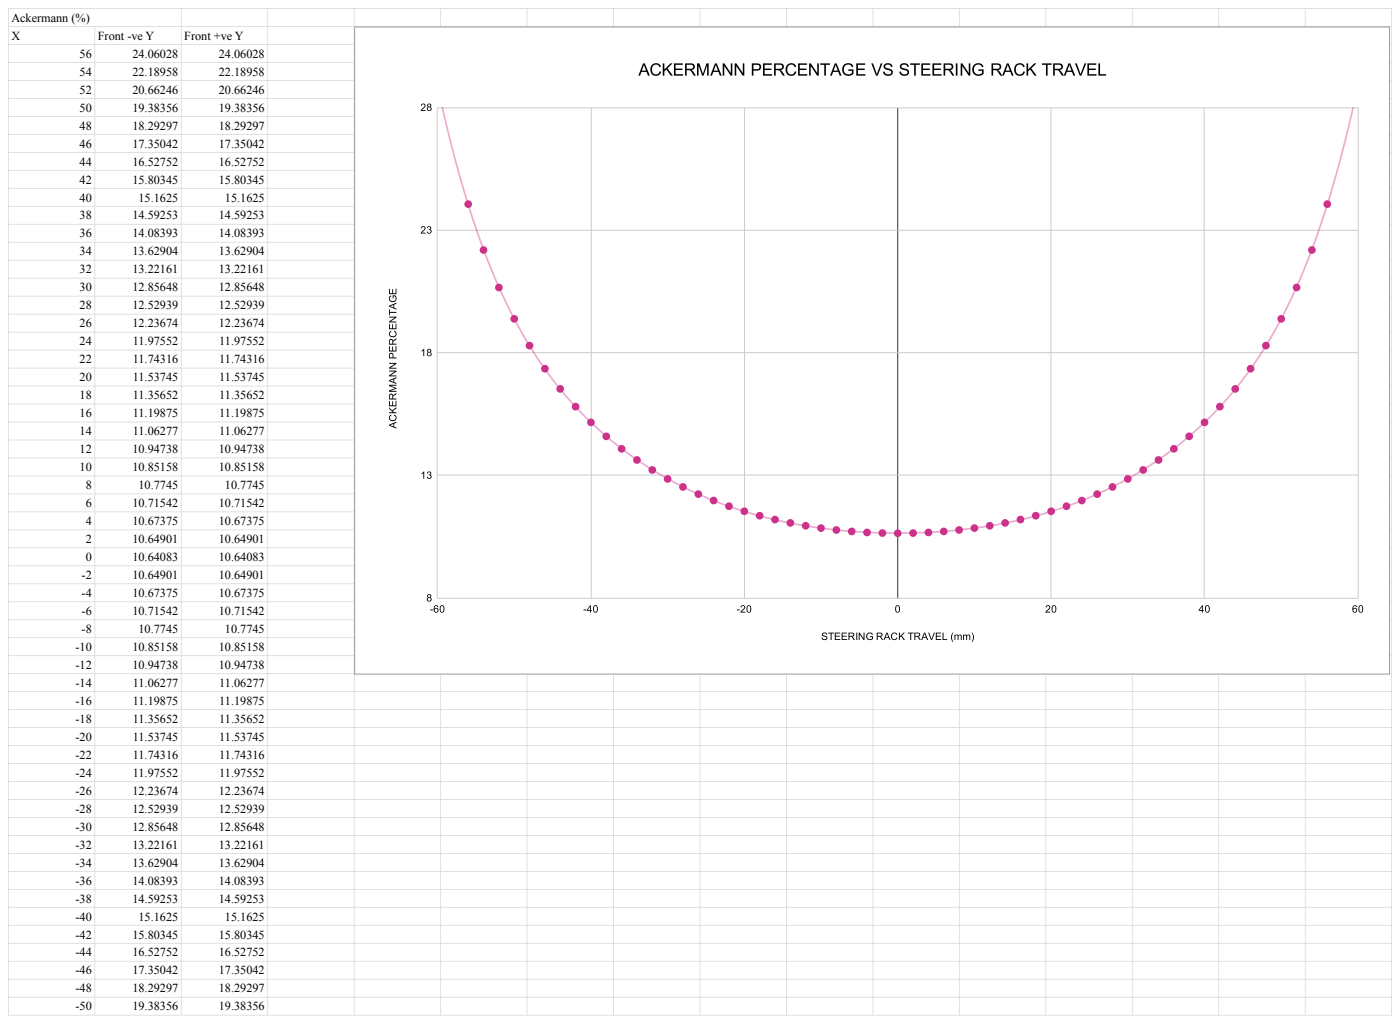
[picture p20: page 6]

-52 | 20.66246 | 20.66246
-54 | 22.18958 | 22.18958
-56 | 24.06028 | 24.06028

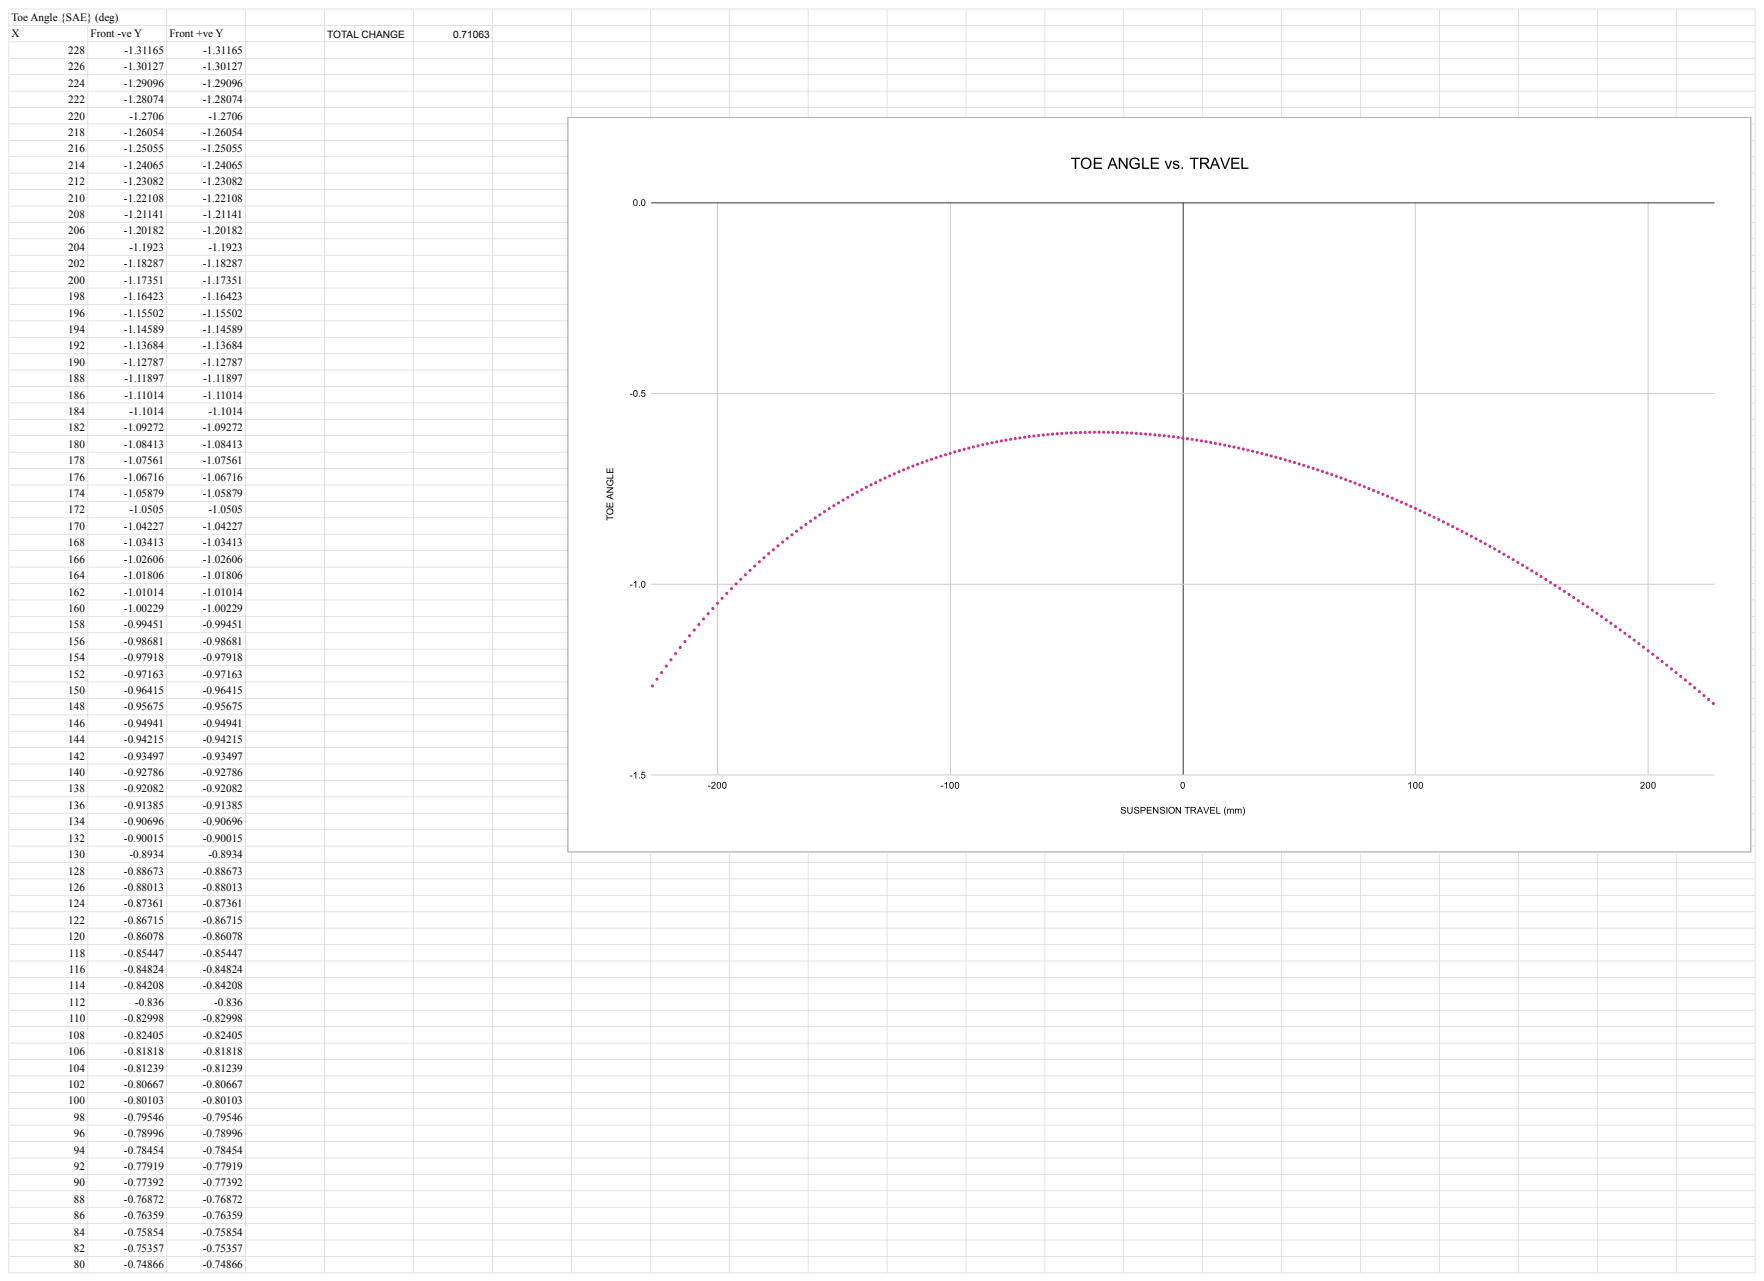
[picture p21: page 8]
Toe Angle {SAE} (deg) X; Front -ve Y; Front +ve Y; TOTAL CHANGE

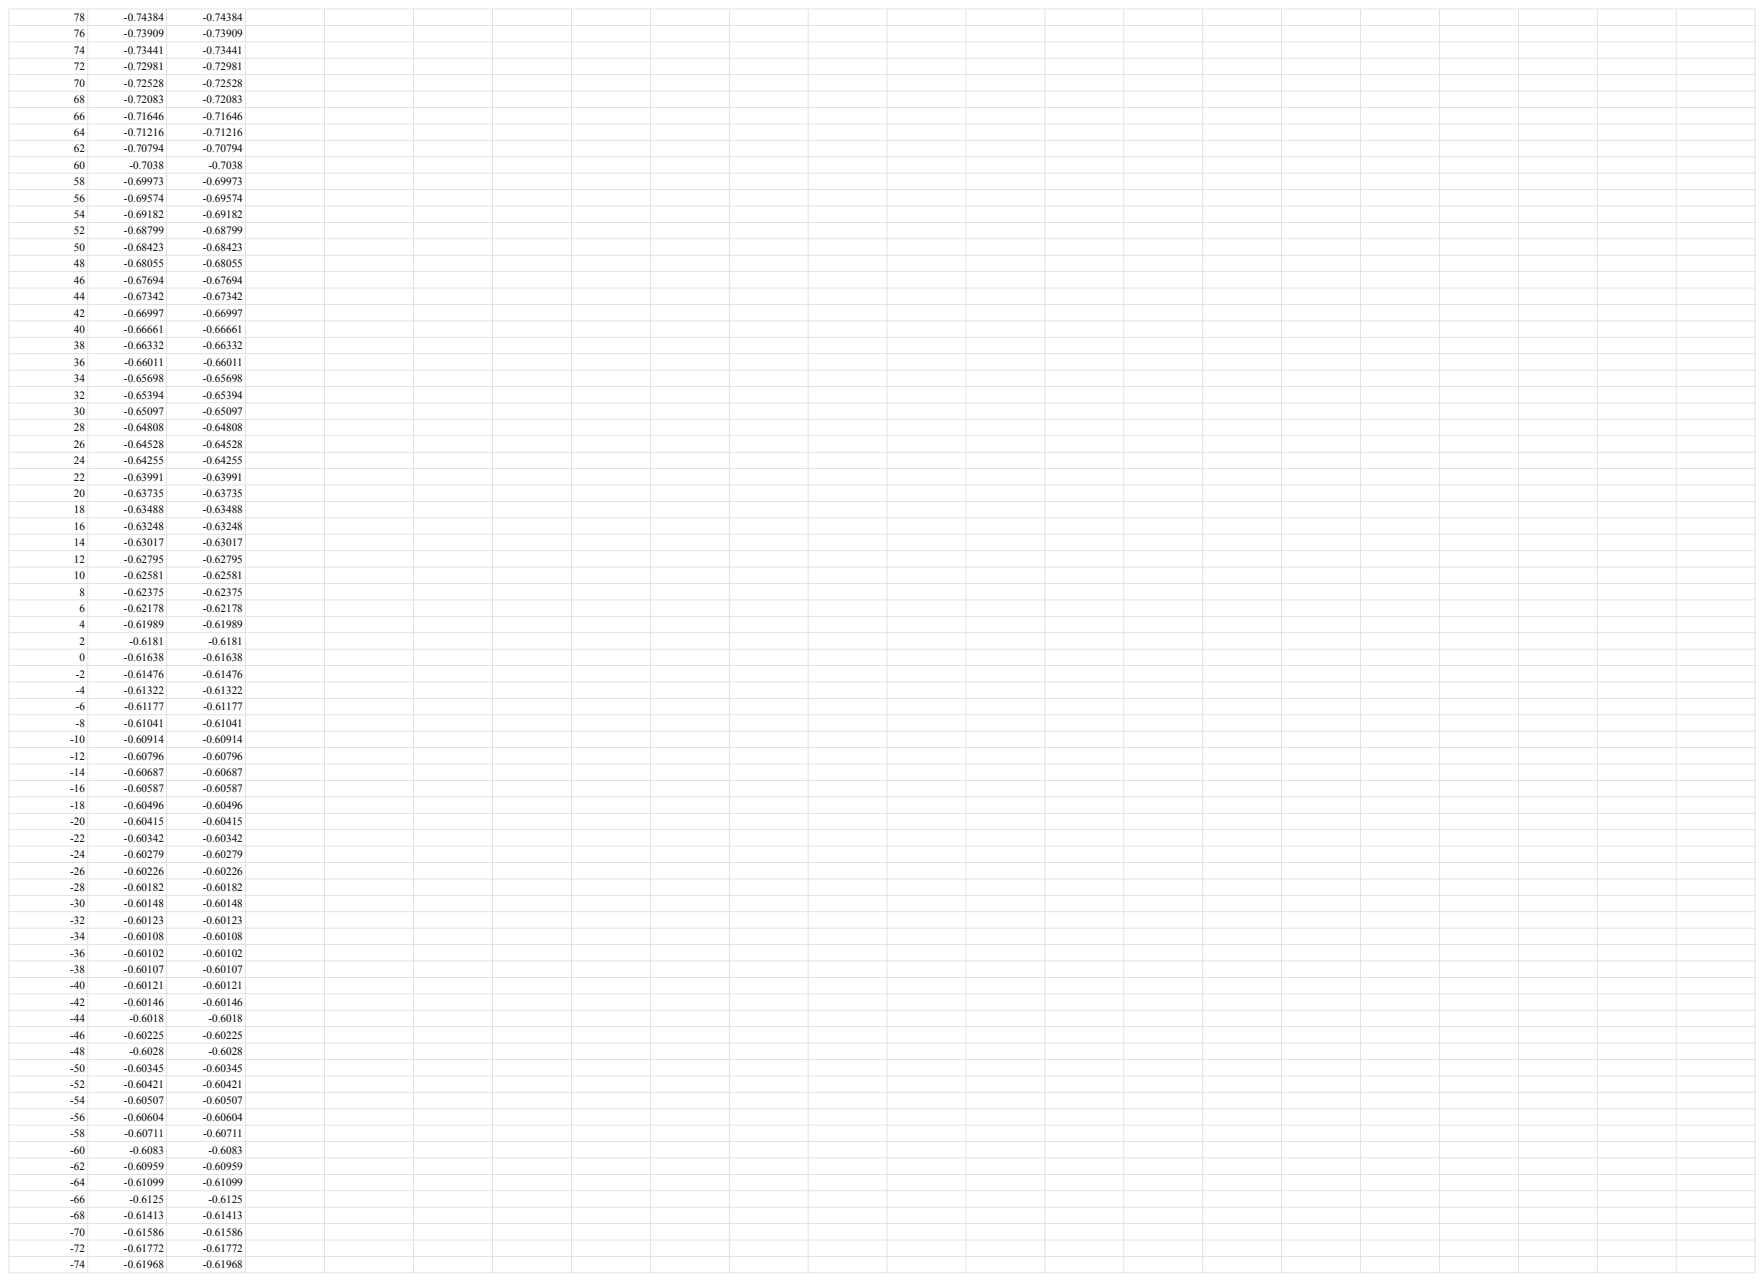
[picture p22: page 9]

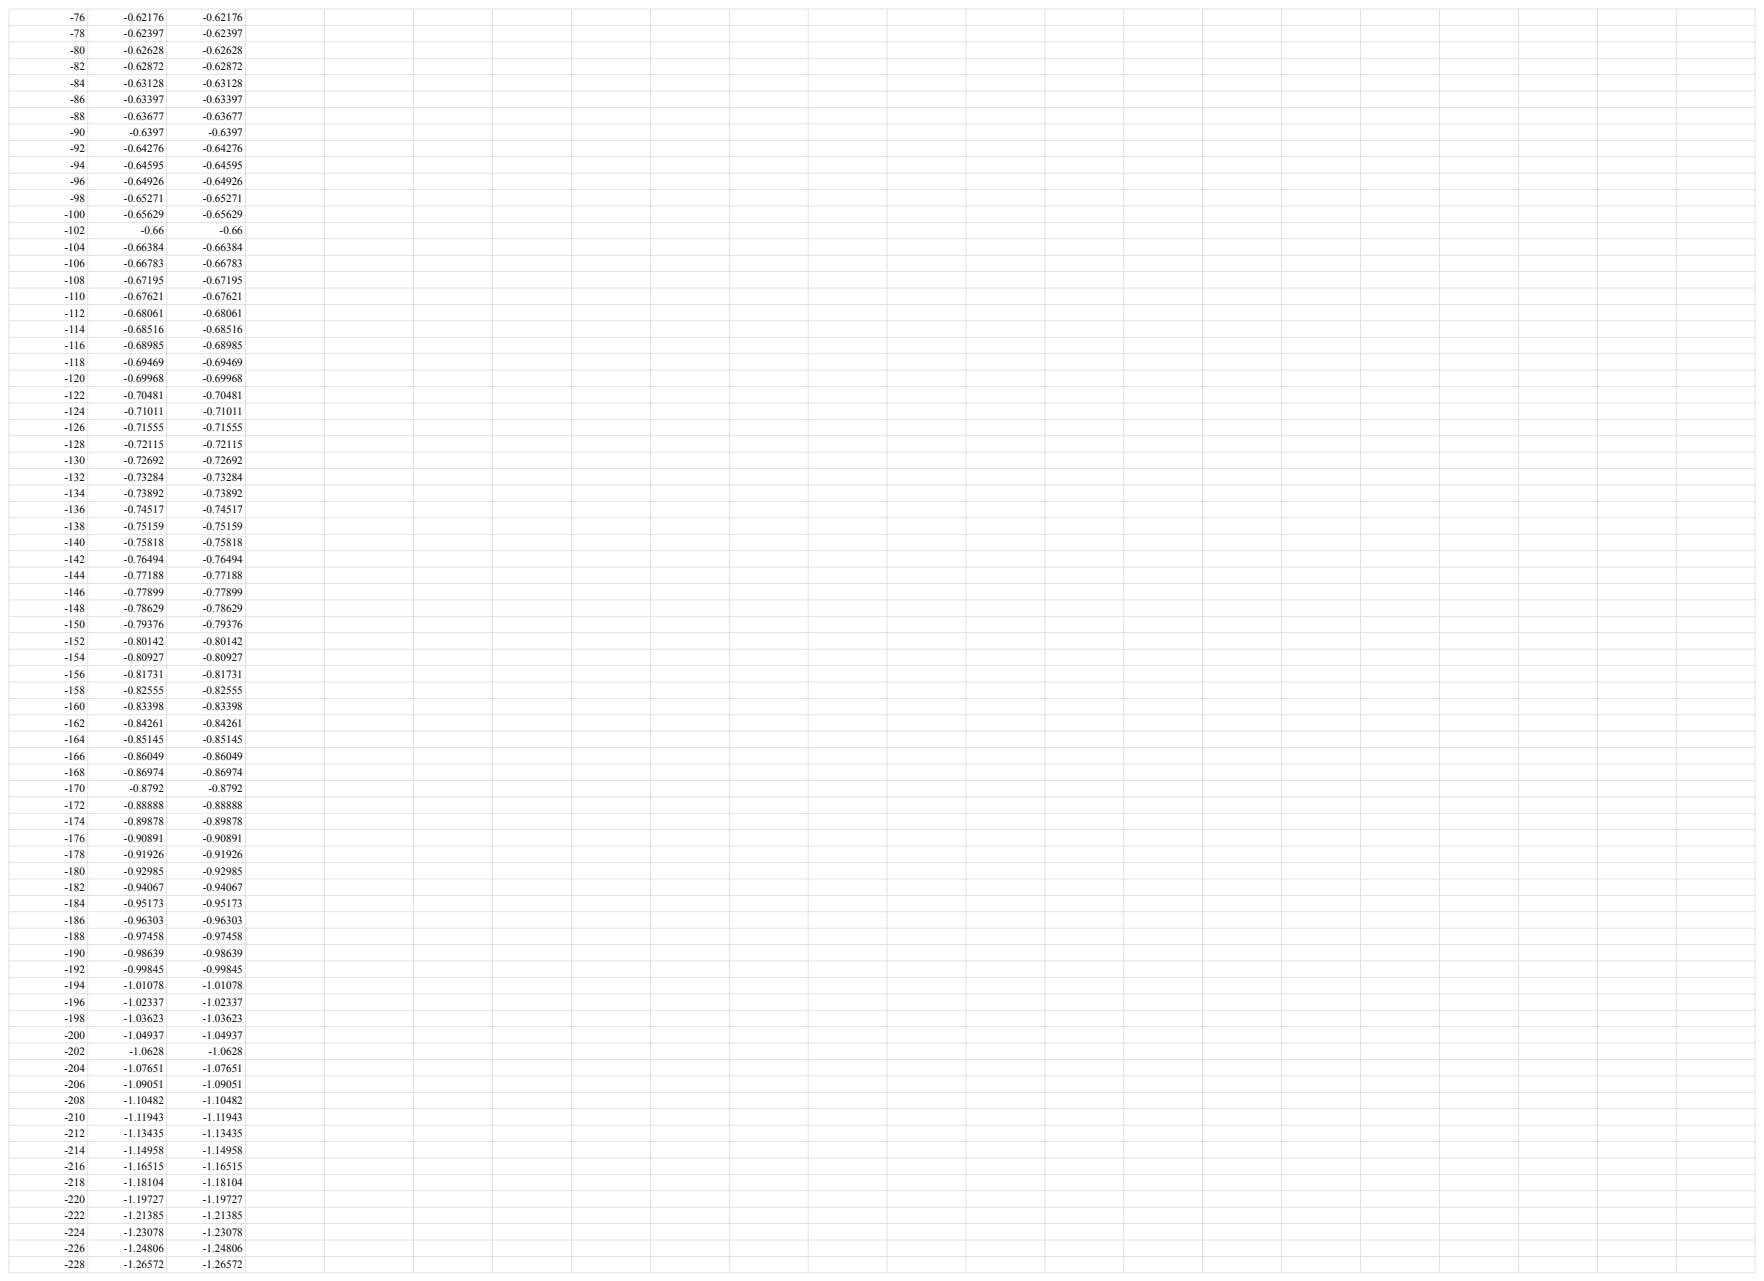
[picture p23: page 10]

56 | -50.2957
54 | -47.3986

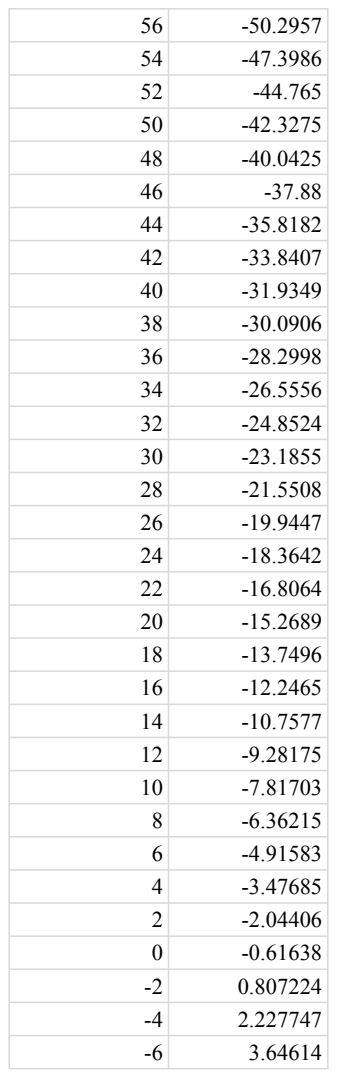
[picture p24: page 11]

-8 | 5.063324
-10 | 6.4802

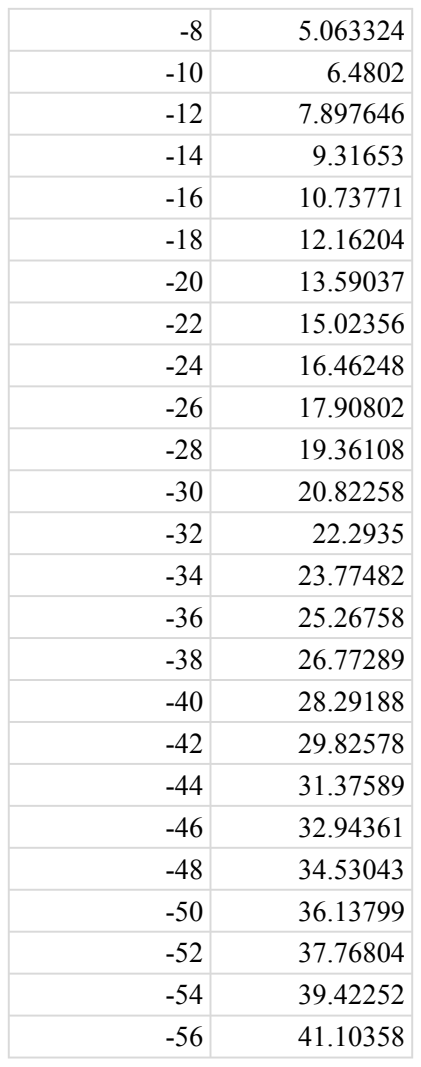
[picture p25: page 12]
