rcyaon/suspension-board/fab/rev-b/docs/suspension-load-daq-layers.pdf

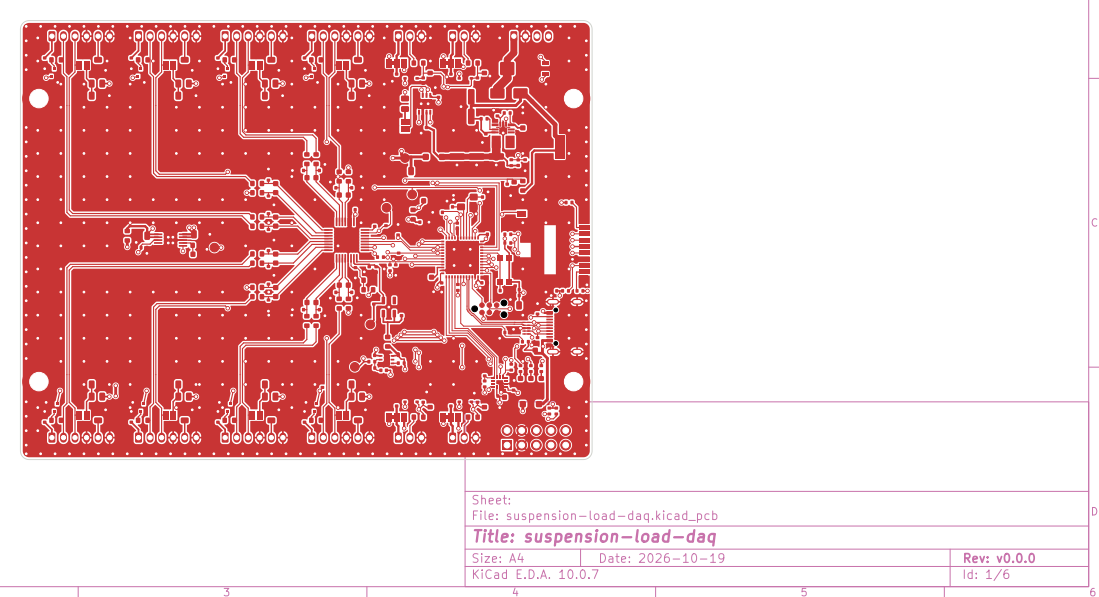
[picture p26: page 1]

Sheet:
File: suspension-load-daq.kicad_pcb
Title: suspension-load-daq

Size: A4 | Rev: v0.0.0
KiCad E.D.A. 10.0.7 | Id: 1/6

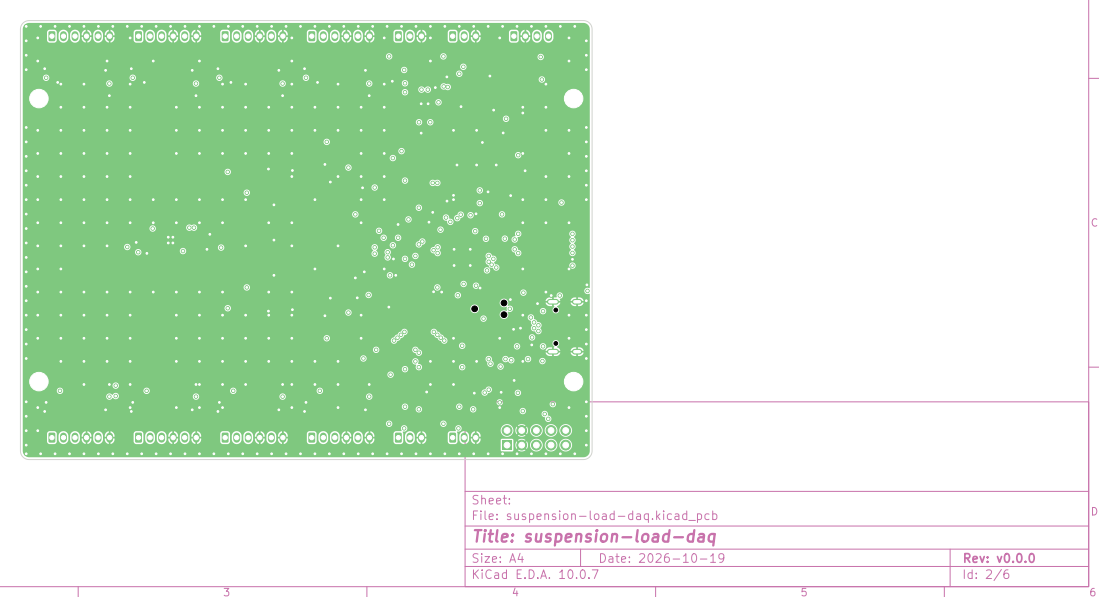
[picture p27: page 2]

Sheet:
File: suspension-load-daq.kicad_pcb
Title: suspension-load-daq

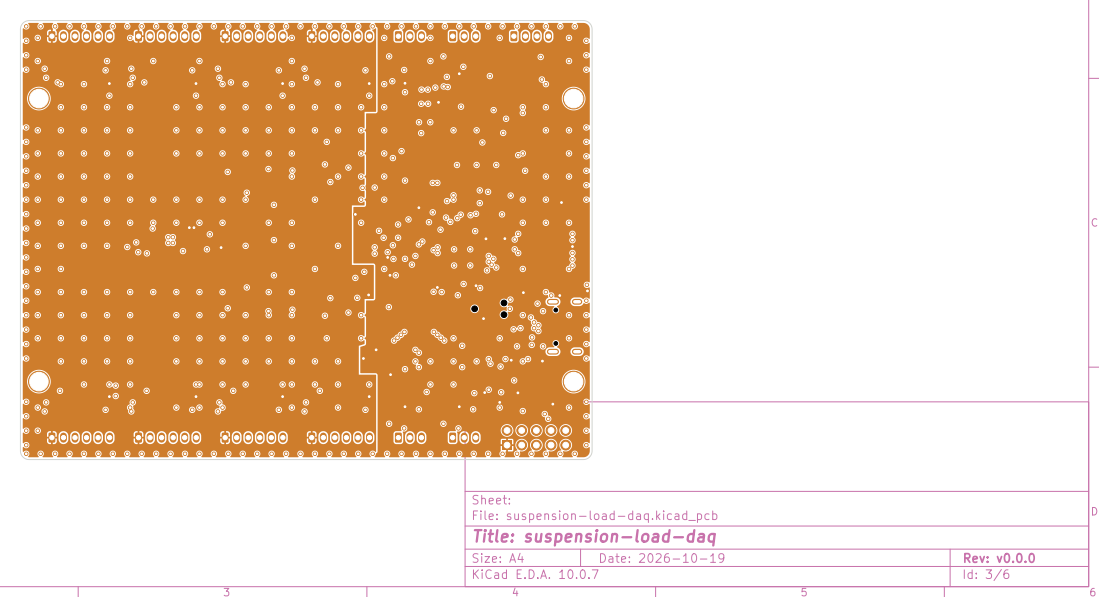
[picture p28: page 3]

Sheet:
File: suspension-load-daq.kicad_pcb
Title: suspension-load-daq

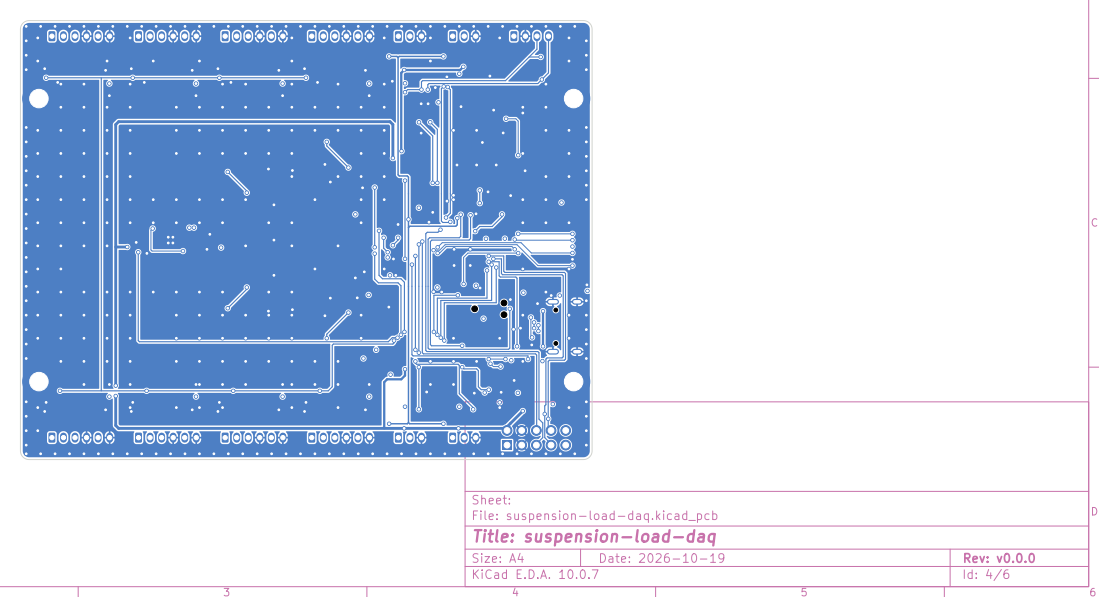
[picture p29: page 4]

Sheet:
File: suspension-load-daq.kicad_pcb
Title: suspension-load-daq

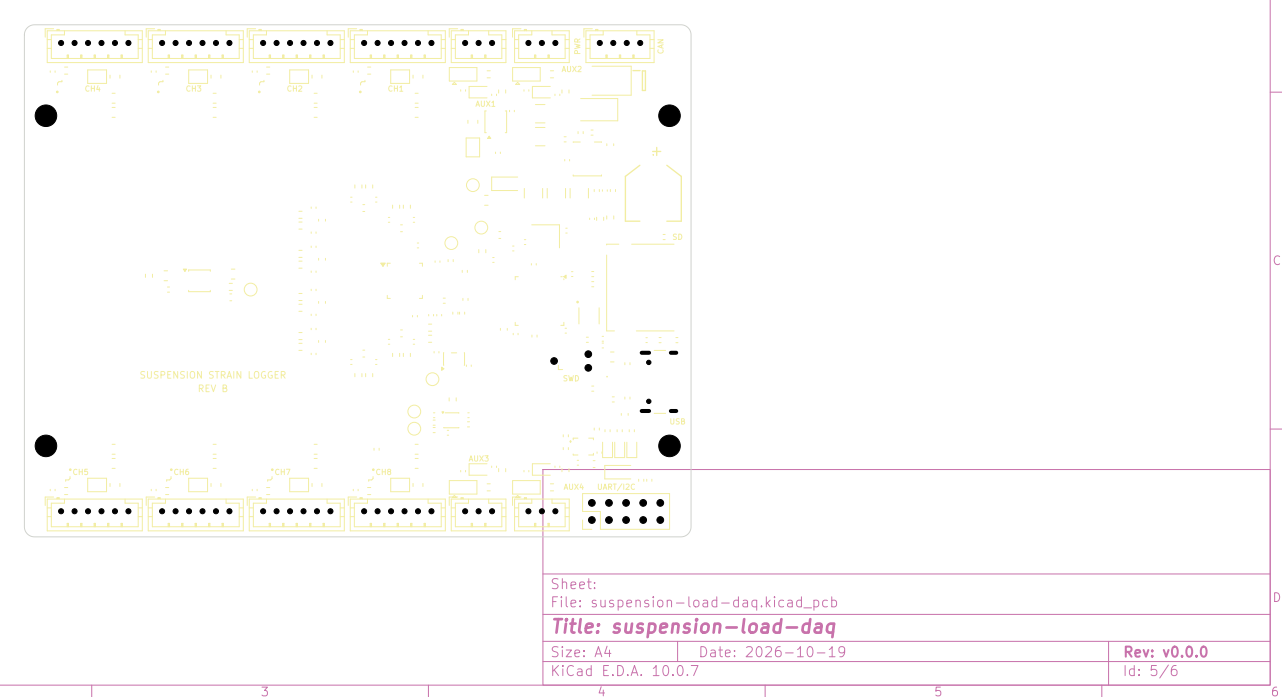
[picture p30: page 5]

Sheet:
File: suspension-load-daq.kicad_pcb
Title: suspension-load-daq

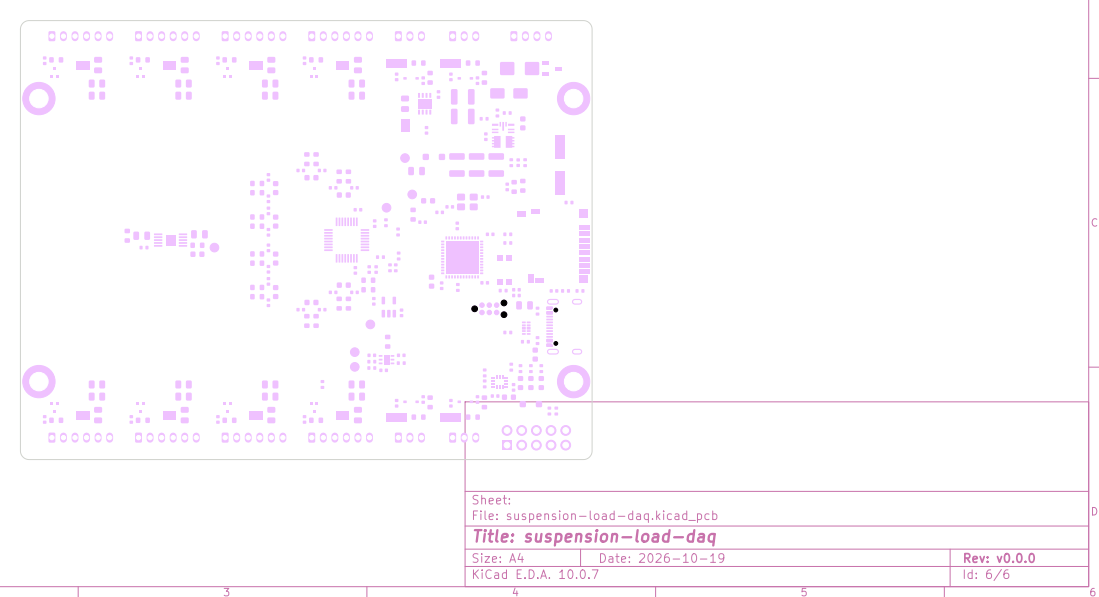
[picture p31: page 6]

Sheet:
File: suspension-load-daq.kicad_pcb
Title: suspension-load-daq
