rcyaon/suspension-board/eda/suspension-load-daq.kicad_pcb

## KiCad design eda/suspension-load-daq.kicad_pcb (2026-10-30)

Schematic: suspension-load-daq.kicad_sch

Parts:
C1, C3, C5, C7: 47nF 16V; C_0402_1005Metric
C2, C4, C6, C8, C14, C18, C22, C26, C30, C34, C38, C42, C44, C47, C49, C62, C64, C65, C66, C67, C68, C70, C83: 100nF 16V; C_0402_1005Metric
C11, C12, C15, C16, C19, C20, C23, C24, C27, C28, C31, C32, C35, C36, C39, C40: 1nF 5% 50V C0G; C_0402_1005Metric
C13, C17, C21, C25, C29, C33, C37, C41: 10nF 5% 50V C0G; C_0603_1608Metric
C43, C46, C69, C80, C81: 1uF 16V; C_0402_1005Metric
C45: 220nF 16V; C_0402_1005Metric
C48, C51, C52, C84: 10uF 16V; C_0805_2012Metric
C50: 1uF 25V; C_0603_1608Metric
C53, C63, C71: 4.7uF 16V; C_0603_1608Metric
C58, C59: 12pF 5% 50V C0G; C_0402_1005Metric
C82: EEE-FK1H470P
D1: PESD2CANFD24V
D2: LED RED; LED_0603_1608Metric
D3: LED GREEN; LED_0603_1608Metric
D4: LED YELLOW; LED_0603_1608Metric
D5: TPD4E02B04DQAR
D6, D7: 1A 40V Low-IR Schottky; D_SOD-123F
D8: 2A 40V Schottky Rectifier; D_SMA
D9: 18V TVS Diode; D_SMB
D10, D11, D12, D13: 200mA 30V Schottky Rectifier; D_SOD-323
FB1, FB2: 220 100MHz; R_0603_1608Metric
H1, H2, H3, H4: M3 DIN965 TopBottom; MountingHole_3.2mm_M3_DIN965_Pad_TopBottom
J1, J2, J3, J4: B3B-PH-K-S; JST_PH_B3B-PH-K_1x03_P2.00mm_Vertical
J5, J6, J7, J8, J9, J10, J11, J12: B6B-PH-K-S; JST_PH_B6B-PH-K_1x06_P2.00mm_Vertical
J13: 2.54mm 5 x 2 THT Vertical Male; PinHeader_2x05_P2.54mm_Vertical
J14: TC2030-NL_CTX; Tag-Connect_TC2030-IDC-NL_2x03_P1.27mm_Vertical
J15: USB4105
J16: B4B-PH-K-S; JST_PH_B4B-PH-K_1x04_P2.00mm_Vertical
J17: DM3D-SF; microSD_HC_Hirose_DM3D-SF
JP1, JP2, JP3, JP4: SolderJumper-3_P1.3mm_Bridged12_Pad1.0x1.5mm
JP5, JP6, JP7, JP8, JP9, JP10, JP11, JP12, JP13: SolderJumper-2_P1.3mm_Open_Pad1.0x1.5mm
Q1, Q2, Q3, Q4, Q5, Q6, Q7, Q8: PJE138K_R1_00001; SOT-523
R1, R3, R5, R7: 16.9k 1%; R_0603_1608Metric; not fitted
R2, R4, R6, R8, R74: 10k 1%; R_0603_1608Metric
R9, R15, R21, R27, R33, R39, R45, R51: 100k 0.1%; R_0603_1608Metric
R10, R11, R16, R17, R22, R23, R28, R29, R34, R35, R40, R41, R46, R47, R52, R53: 1k 0.1%; R_0603_1608Metric
R12, R13, R14, R18, R19, R20, R24, R25, R26, R30, R31, R32, R36, R37, R38, R42, R43, R44, R48, R49, R50, R54, R55, R56: 350 0.1%; R_0805_2012Metric; not fitted
R57, R76, R79, R96: 100k; R_0402_1005Metric
R58: 1 1%; R_0603_1608Metric
R59: 24.9k 0.1%; R_0603_1608Metric
R63, R64, R77: 10k; R_0402_1005Metric
R73: 100k 1%; R_0603_1608Metric
R75: 33; R_0402_1005Metric
R78: 100k; R_0402_1005Metric; not fitted
R80: 10k; R_0402_1005Metric; not fitted
R81: 120 1%; R_0805_2012Metric
R82, R83: 5.1k 1%; R_0402_1005Metric
R84, R85, R86: 1k; R_0402_1005Metric
R87, R88: 10k 0.1%; R_0603_1608Metric; not fitted
R89, R90: 4.7k; R_0402_1005Metric
R91, R92, R93, R94, R95: 47k; R_0402_1005Metric
R97: 10k 1%; R_0402_1005Metric
R98: 15k 1%; R_0402_1005Metric
SW1: KMR211NGLFS; KMR2x1NGLFS
TP1, TP2, TP3, TP4, TP5, TP6, TP7: TestPoint_Small; TestPoint_Pad_D1.5mm
U2: LT3042xMSE; MSOP-10-1EP_3x3mm_P0.5mm_EP1.68x1.88mm
U3: STM32F412CEU6; ST_UFQFPN-48-1EP_7x7mm_P0.5mm_EP5.6x5.6mm
U6: LP5907MFX-3.3; SOT-23-5
U7: ADS131M08xPBS; TQFP-32_5x5mm_P0.5mm
Y1: 8MHz 10pF; Crystal_SMD_3225-4Pin_3.2x2.5mm

Connections:
/ADC_CLKIN: R75.2, R76.1, TP1.1, U7.23 (XTAL1/CLKIN)
/ADC_DRDY: TP2.1, U3.3 (PC14-OSC32_IN), U7.18 (~DRDY)
/ADC_MCLK: R75.1, U3.29 (PA8)
/ADC_REFIN: C47.1, R87.2, R88.1, U7.14 (REFIN)
/ADC_SPI_CLK: J17.5 (CLK), R79.1, U3.15 (PA5), U7.19 (SCLK)
/ADC_SPI_CS: R77.1, U3.38 (PA15), U7.17 (~CS)
/ADC_SPI_MISO: J17.7 (DAT0), R92.1, U3.16 (PA6), U7.20 (DOUT)
/ADC_SPI_MOSI: J17.3 (CMD), R78.1, R91.1, U3.17 (PA7), U7.21 (DIN)
/ADC_SYNC_RST: R64.1, R80.1, U3.20 (PB2), U7.16 (~SYNC/~RESET)
/AIN0N: C11.1, C13.2, R10.2, U7.30 (AIN0N)
/AIN0P: C12.1, C13.1, R11.2, U7.29 (AIN0P)
/AIN1N: C15.1, C17.2, R16.2, U7.31 (AIN1N)
/AIN1P: C16.1, C17.1, R17.2, U7.32 (AIN1P)
/AIN2N: C19.1, C21.2, R22.2, U7.2 (AIN2N)
/AIN2P: C20.1, C21.1, R23.2, U7.1 (AIN2P)
/AIN3N: C23.1, C25.2, R28.2, U7.3 (AIN3N)
/AIN3P: C24.1, C25.1, R29.2, U7.4 (AIN3P)
/AIN4N: C27.1, C29.2, R34.2, U7.6 (AIN4N)
/AIN4P: C28.1, C29.1, R35.2, U7.5 (AIN4P)
/AIN5N: C31.1, C33.2, R40.2, U7.7 (AIN5N)
/AIN5P: C32.1, C33.1, R41.2, U7.8 (AIN5P)
/AIN6N: C35.1, C37.2, R46.2, U7.10 (AIN6N)
/AIN6P: C36.1, C37.1, R47.2, U7.9 (AIN6P)
/AIN7N: C39.1, C41.2, R52.2, U7.11 (AIN7N)
/AIN7P: C40.1, C41.1, R53.2, U7.12 (AIN7P)
/AUX1: C1.1, D10.2 (A), R1.1, R2.2, U3.10 (PA0)
/AUX1_SIG: J1.2, R2.1
/AUX1_V_SENSOR: C2.1, J1.1, JP1.2
/AUX2: C3.1, D11.2 (A), R3.1, R4.2, U3.11 (PA1)
/AUX2_SIG: J2.2, R4.1
/AUX2_V_SENSOR: C4.1, J2.1, JP2.2
/AUX3: C5.1, D12.2 (A), R5.1, R6.2, U3.14 (PA4)
/AUX3_SIG: J3.2, R6.1
/AUX3_V_SENSOR: C6.1, J3.1, JP3.2
/AUX4: C7.1, D13.2 (A), R7.1, R8.2, U3.18 (PB0)
/AUX4_SIG: J4.2, R8.1
/AUX4_V_SENSOR: C8.1, J4.1, JP4.2
/CAN_TERM: JP13.1, R81.2
/CH0_CAL: Q1.3 (D), R9.2
/CH0_HALF_MID: JP5.2, R12.2, R13.1
/CH0_IN_N: J5.3, JP5.1, R10.1
/CH0_IN_P: J5.2, R9.1, R11.1
/CH0_QTR: J5.5, R14.1
/CH1_CAL: Q2.3 (D), R15.2
/CH1_HALF_MID: JP6.2, R18.2, R19.1
/CH1_IN_N: J6.3, JP6.1, R16.1
/CH1_IN_P: J6.2, R15.1, R17.1
/CH1_QTR: J6.5, R20.1
/CH2_CAL: Q3.3 (D), R21.2
/CH2_HALF_MID: JP7.2, R24.2, R25.1
/CH2_IN_N: J7.3, JP7.1, R22.1
/CH2_IN_P: J7.2, R21.1, R23.1
/CH2_QTR: J7.5, R26.1
/CH3_CAL: Q4.3 (D), R27.2
/CH3_HALF_MID: JP8.2, R30.2, R31.1
/CH3_IN_N: J8.3, JP8.1, R28.1
/CH3_IN_P: J8.2, R27.1, R29.1
/CH3_QTR: J8.5, R32.1
/CH4_CAL: Q5.3 (D), R33.2
/CH4_HALF_MID: JP9.2, R36.2, R37.1
/CH4_IN_N: J9.3, JP9.1, R34.1
/CH4_IN_P: J9.2, R33.1, R35.1
/CH4_QTR: J9.5, R38.1
/CH5_CAL: Q6.3 (D), R39.2
/CH5_HALF_MID: JP10.2, R42.2, R43.1
/CH5_IN_N: J10.3, JP10.1, R40.1
/CH5_IN_P: J10.2, R39.1, R41.1
/CH5_QTR: J10.5, R44.1
/CH6_CAL: Q7.3 (D), R45.2
/CH6_HALF_MID: JP11.2, R48.2, R49.1
/CH6_IN_N: J11.3, JP11.1, R46.1
/CH6_IN_P: J11.2, R45.1, R47.1
/CH6_QTR: J11.5, R50.1
/CH7_CAL: Q8.3 (D), R51.2
/CH7_HALF_MID: JP12.2, R54.2, R55.1
/CH7_IN_N: J12.3, JP12.1, R52.1
/CH7_IN_P: J12.2, R51.1, R53.1
/CH7_QTR: J12.5, R56.1
/EXC_EN: R57.1, U2.3 (EN/UV), U3.40 (PB4)
/EXC_SET: C53.1, R59.1, U2.7 (SET)
/I2C_SCL: J13.7, R89.1, U3.42 (PB6)
/I2C_SDA: J13.8, R90.1, U3.43 (PB7)
/LED_ERR: R84.1, U3.41 (PB5)
/LED_ERR_A: D2.2 (A), R84.2
/LED_LOG: R85.1, U3.21 (PB10)
/LED_LOG_A: D3.2 (A), R85.2
/LED_PWR_A: D4.2 (A), R86.2
/MCU_BOOT0: R63.1, SW1.1, SW1.4 (1), U3.44 (BOOT0)
/MCU_HSE_IN: C58.1, U3.5 (PH0-OSC_IN), Y1.1
/MCU_HSE_OUT: C59.1, U3.6 (PH1-OSC_OUT), Y1.3
/NRST: C62.1, J14.3 (~RESET), U3.7 (NRST)
/SD_CS: J17.2 (DAT3/CD), R95.1, U3.31 (PA10)
/SD_DAT1: J17.8 (DAT1), R93.1
/SD_DAT2: J17.1 (DAT2), R94.1
/SD_DET: J17.10 (DET_A), U3.2 (PC13)
/SHUNT_CAL: Q1.1 (G), Q2.1 (G), Q3.1 (G), Q4.1 (G), Q5.1 (G), Q6.1 (G), Q7.1 (G), Q8.1 (G), R96.1, U3.39 (PB3)
/SWD_SWCLK: J14.4 (SWCLK/TCK), U3.37 (PA14)
/SWD_SWDIO: J14.2 (SWDIO/TMS), U3.34 (PA13)
/UART_RX: J13.6, U3.13 (PA3)
/UART_TX: J13.5, U3.12 (PA2)
/USB_CC1: D5.4 (IO3), D5.7 (IO3), J15.A5 (CC1), R82.1
/USB_CC2: D5.5 (IO4), D5.6 (IO4), J15.B5 (CC2), R83.1
/USB_D_N: D5.2 (IO2), D5.9 (IO2), J15.A7 (D-), J15.B7 (D-), U3.32 (PA11)
/USB_D_P: D5.1 (IO1), D5.10 (IO1), J15.A6 (D+), J15.B6 (D+), U3.33 (PA12)
/VBAT_MON: C83.1, R73.2, R74.1, U3.19 (PB1)
/VBUS_SENSE: R97.2, R98.1, U3.30 (PA9)
ADC_CAP: C45.1, U7.24 (CAP)
CANH: D1.1 (K1), J16.3, R81.1; also elsewhere on the board
CANL: D1.2 (K2), J16.4, JP13.2; also elsewhere on the board
CAN_RX: U3.45 (PB8); also elsewhere on the board
CAN_TX: U3.46 (PB9); also elsewhere on the board
CE92F33B_B5EE_566D_91AA_04935ED1A8A1.U2.NC_LT3042xMSE_PG: U2.4 (PG)
CE419F7E_AAEF_5640_A00C_559494572CE8.U7.NC_ADS131M08xPBS_XTAL2: U7.22 (XTAL2)
E5DDBF15_4968_5B0E_9312_A38794FA11BE.J13.NC_2_54mm_5_x_2_THT_Vertical_Male_Pin_9: J13.9
E5DDBF15_4968_5B0E_9312_A38794FA11BE.J13.NC_2_54mm_5_x_2_THT_Vertical_Male_Pin_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: J13.10
EXC: C14.1, C18.1, C22.1, C26.1, C30.1, C34.1, C38.1, C42.1, C52.1, J5.1, J6.1, J7.1, J8.1, J9.1, J10.1, J11.1, J12.1, R12.1, R18.1, R24.1, R30.1, R36.1, R42.1, R48.1, R54.1, R87.1, TP3.1, U2.9 (OUTS), U2.10 (OUT)
EXC_VIN_FILT: C51.1, R58.2, U2.1 (IN), U2.2 (IN), U2.6 (PGFB)
GND: C1.2, C2.2, C3.2, C4.2, C5.2, C6.2, C7.2, C8.2, C11.2, C12.2, C14.2, C15.2, C16.2, C18.2, C19.2, C20.2, C22.2, C23.2, C24.2, C26.2, C27.2, C28.2, C30.2, C31.2, C32.2, C34.2, C35.2, C36.2, C38.2, C39.2, C40.2, C42.2, C43.2, C44.2, C45.2, C46.2, C47.2, C48.2, C49.2, C50.2, C51.2, C52.2, C53.2, C58.2, C59.2, C62.2, C63.2, C64.2, C65.2, C66.2, C67.2, C68.2, C69.2, C70.2, C71.2, C80.2, C81.2, C82.2 (-), C83.2, C84.2, D1.3 (CC), D2.1 (K), D3.1 (K), D4.1 (K), D5.3 (GND), D5.8 (GND), D9.1 (A1), H1.1, H2.1, H3.1, H4.1, J1.3, J2.3, J3.3, J4.3, J5.4, J5.6, J6.4, J6.6, J7.4, J7.6, J8.4, J8.6, J9.4, J9.6, J10.4, J10.6, J11.4, J11.6, J12.4, J12.6, J13.3, J13.4, J14.5 (GND), J15.A1 (GND), J15.A12 (GND), J15.B1 (GND), J15.B12 (GND), J15.SH (SHIELD), J16.2, J17.6 (VSS), J17.9 (DET_B), J17.11 (SHIELD), Q1.2 (S), Q2.2 (S), Q3.2 (S), Q4.2 (S), Q5.2 (S), Q6.2 (S), Q7.2 (S), Q8.2 (S), R1.2, R3.2, R5.2, R7.2, R13.2, R14.2, R19.2, R20.2, R25.2, R26.2, R31.2, R32.2, R37.2, R38.2, R43.2, R44.2, R49.2, R50.2, R55.2, R56.2, R57.2, R59.2, R63.2, R64.2, R74.2, R76.2, R78.2, R79.2, R82.2, R83.2, R88.2, R96.2, R98.2, TP4.1, U2.5 (ILIM), U2.8 (GND), U2.11 (GND), U3.8 (VSSA/VREF-), U3.23 (VSS), U3.35 (VSS), U3.47 (VSS), U3.49 (EP), U6.2 (GND), U7.13 (AGND), U7.25 (DGND), U7.27 (AGND), U7.28 (AGND), Y1.2 (G), Y1.4 (G); also elsewhere on the board
IMU_INT1: U3.4 (PC15-OSC32_OUT); also elsewhere on the board
IMU_SPI_CLK: U3.26 (PB13); also elsewhere on the board
IMU_SPI_CS: U3.25 (PB12); also elsewhere on the board
IMU_SPI_MISO: U3.27 (PB14); also elsewhere on the board
IMU_SPI_MOSI: U3.28 (PB15); also elsewhere on the board
MCU_VCAP: C63.1, U3.22 (VCAP_1)
PWR_V5_ANA: C80.1, FB2.2, U6.1 (IN), U6.3 (EN)
PWR_VPROT: C82.1 (+), D8.1 (K), R73.1; also elsewhere on the board
SHEET_1E38873B_1565_589A_9F67_7DA908C7A1CF./USB_SBU1: J15.A8 (SBU1)
SHEET_1E38873B_1565_589A_9F67_7DA908C7A1CF./USB_SBU2: J15.B8 (SBU2)
SHEET_2FA17A4D_9B43_582C_8717_1449C502FD6B.U6.NC_LP5907MFX-3_3_NC: U6.4 (NC)
SHEET_86AE2C84_4DAF_53FF_BA88_4A842EC6F995.J14.NC_TC2030-NL_CTX_SWO/TDO: J14.6 (SWO/TDO)
V3V3: C46.1, C48.1, C49.1, C64.1, C65.1, C66.1, C67.1, C68.1, C71.1, D10.1 (K), D11.1 (K), D12.1 (K), D13.1 (K), FB1.1, J13.1, J14.1 (VTref), J17.4 (VDD), R77.2, R80.2, R86.1, R89.2, R90.2, R91.2, R92.2, R93.2, R94.2, R95.2, SW1.2, SW1.3 (2), TP5.1, U3.1 (VBAT), U3.24 (VDD), U3.36 (VDD), U3.48 (VDD), U7.26 (DVDD); also elsewhere on the board
V3V3A: C43.1, C44.1, C81.1, TP6.1, U6.5 (OUT), U7.15 (AVDD)
V5: C84.1, D6.1 (K), D7.1 (K), FB2.1, J13.2, R58.1, TP7.1; also elsewhere on the board
V5_BUCK: D6.2 (A), JP1.3, JP2.3, JP3.3, JP4.3; also elsewhere on the board
VBUS: C50.1, D7.2 (A), J15.A4 (VBUS), J15.A9 (VBUS), J15.B4 (VBUS), J15.B9 (VBUS), R97.1
VDDA: C69.1, C70.1, FB1.2, JP1.1, JP2.1, JP3.1, JP4.1, U3.9 (VDDA/VREF+)
VIN_VEH: D8.2 (A), D9.2 (A2), J16.1

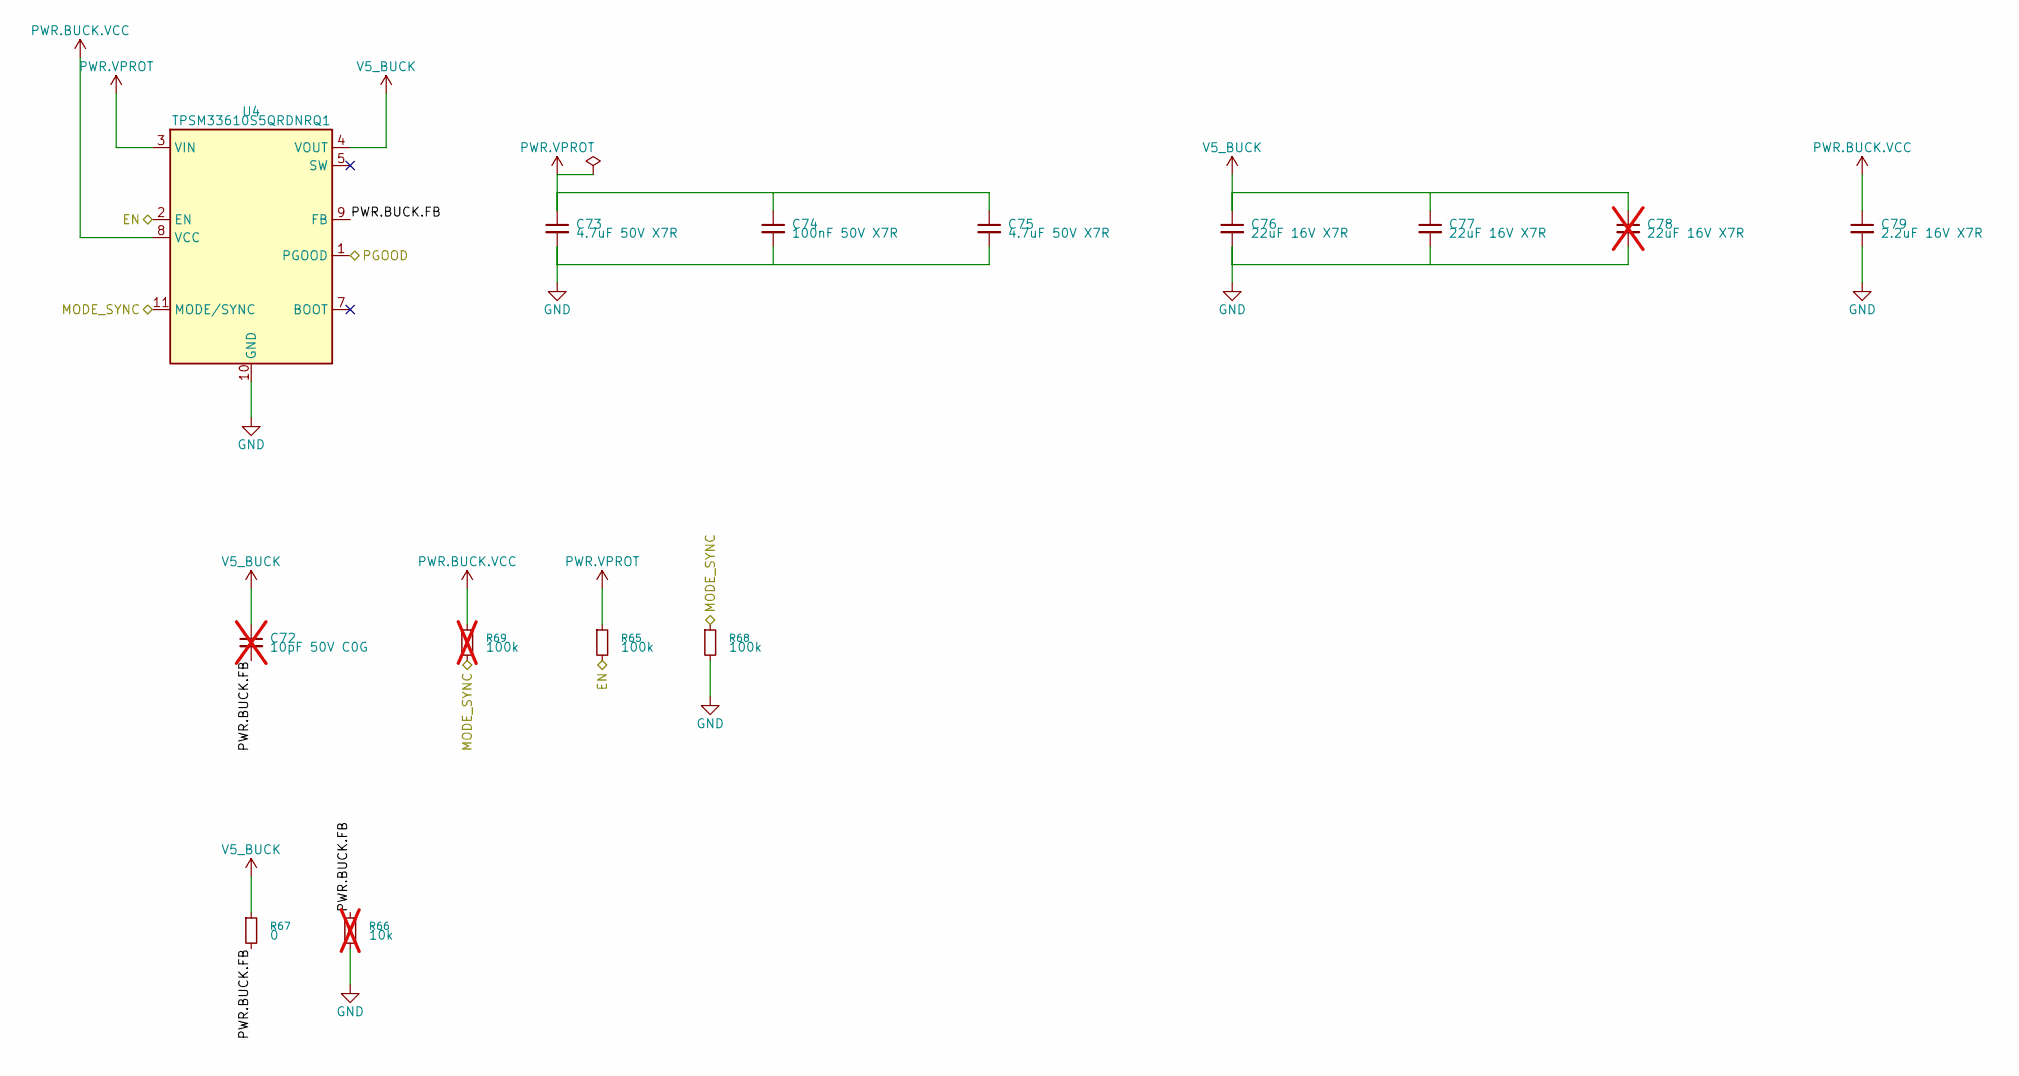
[picture p32: schematic PWR.BUCK.kicad_sch]

Parts:
C72: 10pF 50V C0G; C_0402_1005Metric; not fitted
C73, C75: 4.7uF 50V X7R; C_1210_3225Metric
C74: 100nF 50V X7R; C_0402_1005Metric
C76, C77: 22uF 16V X7R; C_1210_3225Metric
C78: 22uF 16V X7R; C_1210_3225Metric; not fitted
C79: 2.2uF 16V X7R; C_0603_1608Metric
R65, R68: 100k; R_0402_1005Metric
R66: 10k; R_0402_1005Metric; not fitted
R67: 0; R_0402_1005Metric
R69: 100k; R_0402_1005Metric; not fitted
U4: TPSM33610S5QRDNRQ1; TPSM336xx-Q1

Connections:
/BUCK/PWR_BUCK_FB: C72.2, R66.1, R67.2, U4.9 (FB)
/PWR_BUCK_EN: R65.2, U4.2 (EN)
/PWR_BUCK_MODE_SYNC: R68.1, R69.2, U4.11 (MODE/SYNC)
GND: C73.2, C74.2, C75.2, C76.2, C77.2, C78.2, C79.2, R66.2, R68.2, U4.10 (GND); also elsewhere on the board
PWR_BUCK_VCC: C79.1, R69.1, U4.8 (VCC)
PWR_VPROT: C73.1, C74.1, C75.1, R65.1, U4.3 (VIN); also elsewhere on the board
SHEET_76AEE5BD_A69C_56AF_AE87_0C38A51049F7./PWR_BUCK_PGOOD: U4.1 (PGOOD)
SHEET_76AEE5BD_A69C_56AF_AE87_0C38A51049F7.U4.NC_TPSM33610S5QRDNRQ1_BOOT: U4.7 (BOOT)
V5_BUCK: C72.1, C76.1, C77.1, C78.1, R67.1, U4.4 (VOUT); also elsewhere on the board

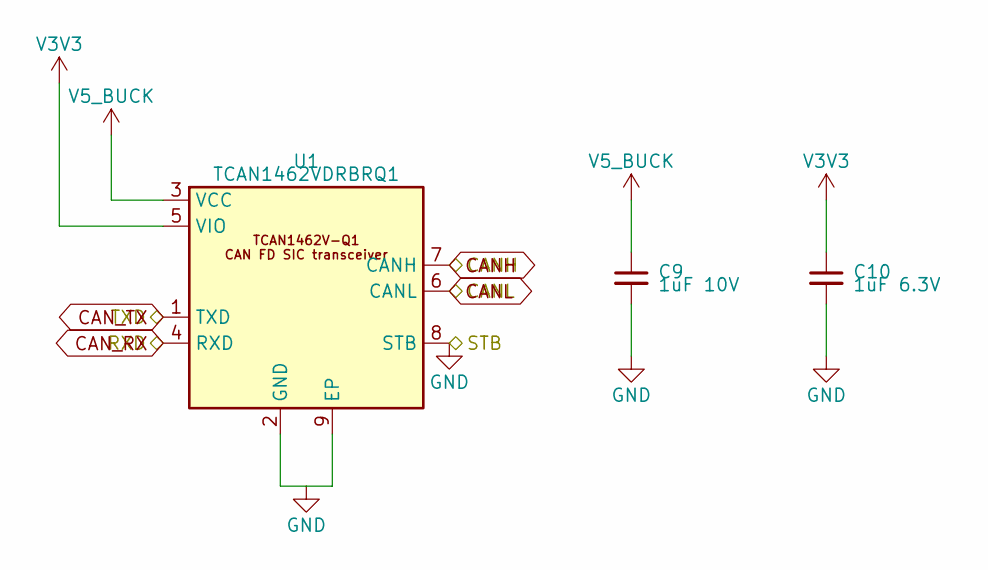
[picture p33: schematic CAN.kicad_sch]

Parts:
C9: 1uF 10V; C_0402_1005Metric
C10: 1uF 6.3V; C_0402_1005Metric
U1: TCAN1462VDRBRQ1; TCAN1462V-Q1-DRB

Connections:
CANH: U1.7 (CANH); also elsewhere on the board
CANL: U1.6 (CANL); also elsewhere on the board
CAN_RX: U1.4 (RXD); also elsewhere on the board
CAN_TX: U1.1 (TXD); also elsewhere on the board
GND: C9.2, C10.2, U1.2 (GND), U1.8 (STB), U1.9 (EP); also elsewhere on the board
V3V3: C10.1, U1.5 (VIO); also elsewhere on the board
V5_BUCK: C9.1, U1.3 (VCC); also elsewhere on the board

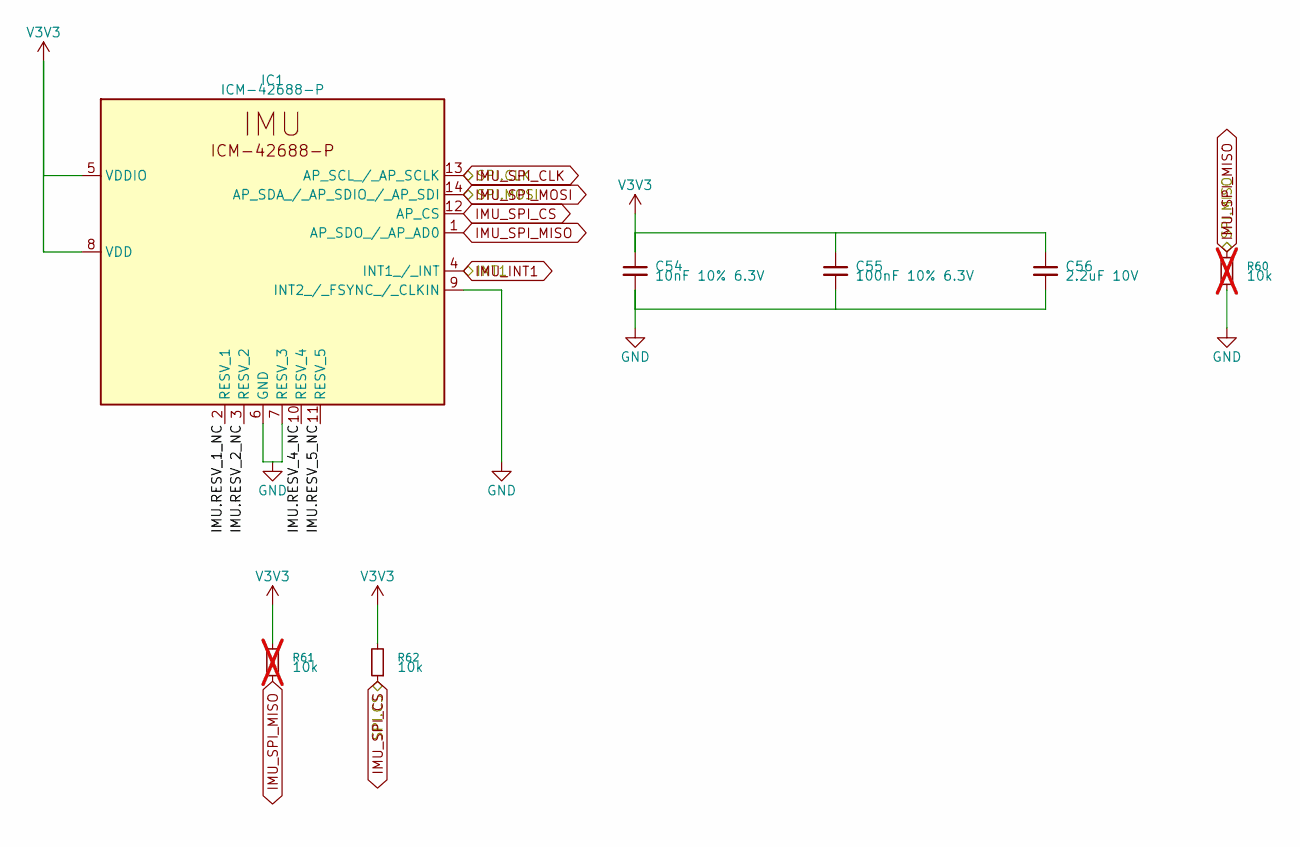
[picture p34: schematic IMU.kicad_sch]

Parts:
C54: 10nF 10% 6.3V; C_0402_1005Metric
C55: 100nF 10% 6.3V; C_0402_1005Metric
C56: 2.2uF 10V; C_0603_1608Metric
IC1: ICM-42688-P; IIM42352
R60, R61: 10k; R_0402_1005Metric; not fitted
R62: 10k; R_0402_1005Metric

Connections:
GND: C54.2, C55.2, C56.2, IC1.6 (GND), IC1.7 (RESV_3), IC1.9 (INT2_/_FSYNC_/_CLKIN), R60.2; also elsewhere on the board
IMU_INT1: IC1.4 (INT1_/_INT); also elsewhere on the board
IMU_SPI_CLK: IC1.13 (AP_SCL_/_AP_SCLK); also elsewhere on the board
IMU_SPI_CS: IC1.12 (AP_CS), R62.1; also elsewhere on the board
IMU_SPI_MISO: IC1.1 (AP_SDO_/_AP_AD0), R60.1, R61.1; also elsewhere on the board
IMU_SPI_MOSI: IC1.14 (AP_SDA_/_AP_SDIO_/_AP_SDI); also elsewhere on the board
SHEET_8522DDAD_AE9A_56B5_B069_4220863B1849./IMU/IMU_RESV_1_NC: IC1.2 (RESV_1)
SHEET_8522DDAD_AE9A_56B5_B069_4220863B1849./IMU/IMU_RESV_2_NC: IC1.3 (RESV_2)
SHEET_8522DDAD_AE9A_56B5_B069_4220863B1849./IMU/IMU_RESV_4_NC: IC1.10 (RESV_4)
SHEET_8522DDAD_AE9A_56B5_B069_4220863B1849./IMU/IMU_RESV_5_NC: IC1.11 (RESV_5)
V3V3: C54.1, C55.1, C56.1, IC1.5 (VDDIO), IC1.8 (VDD), R61.2, R62.2; also elsewhere on the board

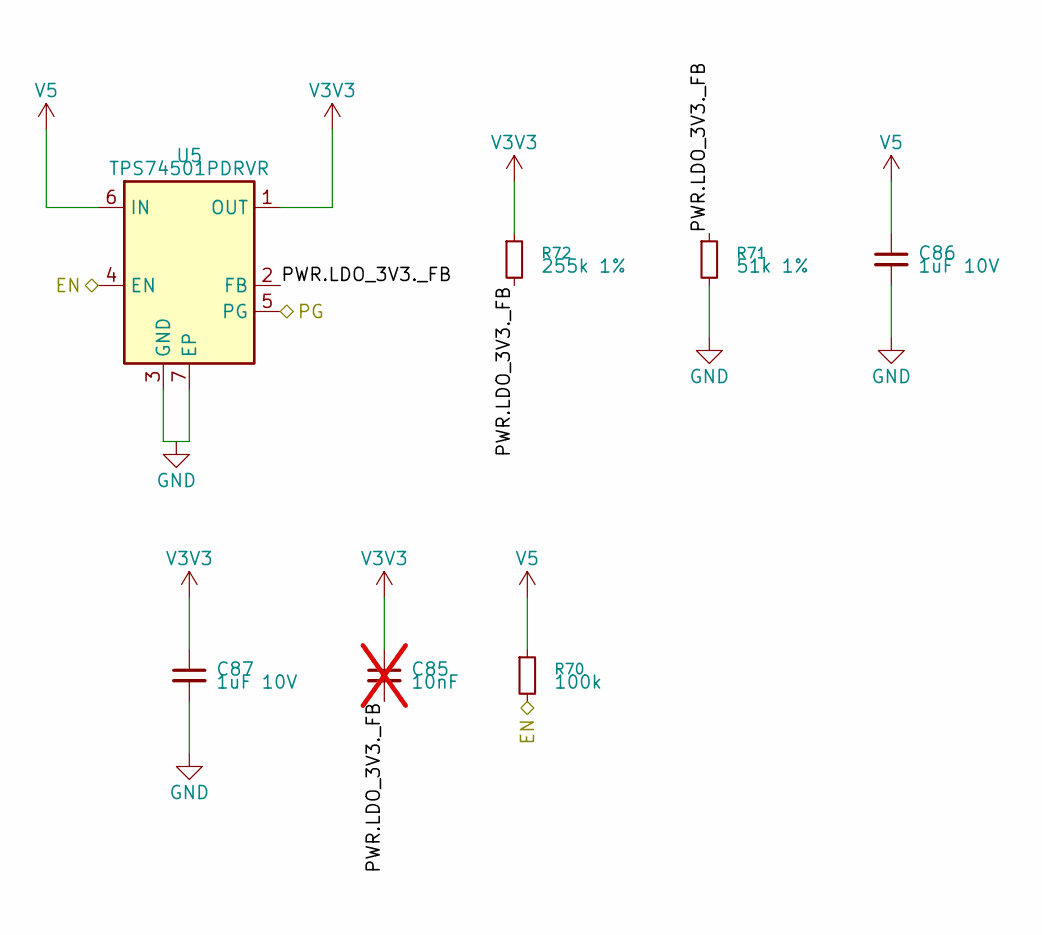
[picture p35: schematic PWR.LDO_3V3.kicad_sch]

Parts:
C85: 10nF; C_0402_1005Metric; not fitted
C86, C87: 1uF 10V; C_0402_1005Metric
R70: 100k; R_0402_1005Metric
R71: 51k 1%; R_0402_1005Metric
R72: 255k 1%; R_0402_1005Metric
U5: TPS74501PDRVR; TPS74x01P

Connections:
/LDO_3V3/PWR_LDO_3V3_FB: C85.2, R71.1, R72.2, U5.2 (FB)
/PWR_LDO_3V3_EN: R70.2, U5.4 (EN)
GND: C86.2, C87.2, R71.2, U5.3 (GND), U5.7 (EP); also elsewhere on the board
SHEET_28B8B799_7A7C_55D0_9ACD_16A5C6B80815./PWR_LDO_3V3_PG: U5.5 (PG)
V3V3: C85.1, C87.1, R72.1, U5.1 (OUT); also elsewhere on the board
V5: C86.1, R70.1, U5.6 (IN); also elsewhere on the board

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
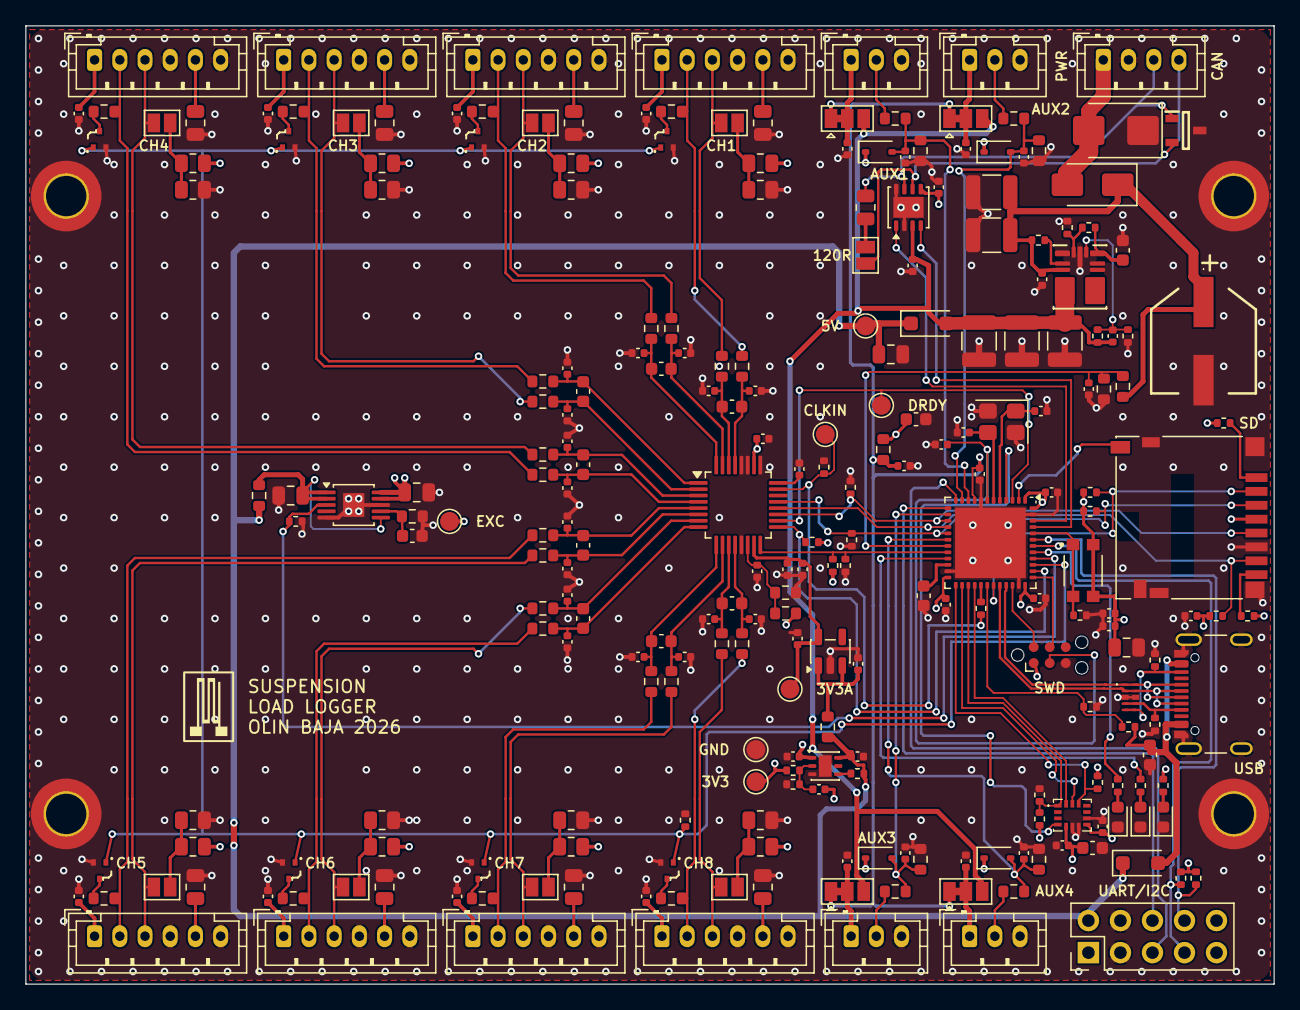
[picture p36: board suspension-load-daq.kicad_pcb from above]

Board: 4 copper layers, 99.0 x 76.0 mm, 256 parts (0 on the bottom side), 135 nets.
