rcyaon/suspension-board/(commit log)

2026-10-19 Add Rev B: routed layout and fab package (Diode 99bcdad)
    Imports the completed Rev B board from code.diode.computer/lena/b/string-gauge-daq
    at commit 99bcdad.
    - Design source: placed, routed and poured 99 x 76 mm 4-layer layout
    (DRC 0 errors / 0 unconnected), AUX fault clamps D10-D13, D6/D7 changed to
    RB168MM-40 (1A_40V_LowIR replaces 1A_20V), ICM-42688-P symbol update.
    pcb build: 256 components.
    - fab/rev-b/: JLCPCB Gerber zip, Gerbers/drills, BOM/CPL, schematic/assembly
    PDFs, DRC/ERC reports, STEP, IPC-2581, renders. MANIFEST.txt holds SHA-256
    sums (verified on import).
    - spec.md/README.md: Rev B layout and status merged with this repo's own
    edits (test-plan and board-spec ref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
    [IMU.kicad_sch, LQFP-64_10x10mm_P0.5mm.step, suspension-load-daq-BOM-JLCPCB.csv, suspension-load-daq-BOM-full.csv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]
2026-10-27 firmware inclusion
    [CONFIG.TXT, adams_rear_drive.csv]
2026-10-27 Update README with board documentation details
    Clarified documentation details for board labeling.
2026-10-27 update renders
    [suspension-load-daq.kicad_pcb]
2026-10-30 did not cook mb
    [suspension-load-daq-BOM-full.csv, suspension-load-daq.kicad_pcb, suspension-load-daq.kicad_sch]
